basicallysource/sorter-v2/software/sorter-design-system/docs/overlays.md

# Overlays

What floats over the page: the popover, the menu, the select's list, the
tooltip and the modal. All of them are the raised plane: `bg-raised` with one
`border-line`, and no shadow. They render in the browser's top layer (the
`popover` attribute, or the native `<dialog>`), so no ancestor's overflow can
clip them and no z-index is needed. `place.ts` puts a floating panel next to
what opened it, on the preferred side, flipped when that side has no room,
and kept 8px inside the window.

## Popover

`Popover.svelte`. A little content that opens from a button: a picker, a
short form, an explanation too long for a tooltip. It closes on a click
outside, on Escape, and focus goes back to the button. The trigger snippet
gets the attributes that wire its button to the panel; spread them onto it:

```svelte
<Popover label="Camera exposure">
	{#snippet trigger(props)}<Button {...props}>Exposure</Button>{/snippet}
	...
</Popover>
```

## Menu

`Menu.svelte`. Actions or links from one button: the machine's menu, a
card's "more" menu, a switcher. The button that opens an actions menu shows
three dots (`ellipsis`) and a name, never the icon of one of the actions
inside it ([icons.md](icons.md#a-menus-button-is-three-dots)). The arrow keys, Home and End
move, Enter chooses, Escape and Tab close. An item that destroys something
comes last, after a separator, in danger ink, and its action asks first (a
`Modal`). A switcher's items take `checked`, and the current one gets a
check; a link that is `checked` is the current page (`aria-current`), which
is how the top bar's folded pages mark where you are. A group,
`{ group: 'Admin', items: [...] }`, puts its name over its items as a label,
like a group in the side nav:

```svelte
<Menu
	label="Account"
	items={[
		{ label: 'Your settings', href: '/account' },
		'separator',
		{ group: 'Admin', items: [{ label: 'Users', href: '/admin/users' }] },
		'separator',
		{ label: 'Sign out', onselect: signOut }
	]}>...</Menu
>
```

With no `trigger`, a Menu is a context menu: the thing that was right-clicked
opens it where the pointer is, with `openAt(event)` on the component (on a
Mac it waits for the button's release), and it closes like any other menu. Keep what it offers on the page as well (a
button beside the selection), since a touch screen has no right click:

```svelte
<Menu bind:this={menu} label="Bin" items={[{ label: 'Point the chute here', onselect: aim }]} />
<canvas
	oncontextmenu={(e) => {
		e.preventDefault();
		menu.openAt(e);
	}}
></canvas>
```

## Select

`Select.svelte` is a field that opens a list: our own, not the browser's, so
it looks like the rest of the page on every system. From the keyboard, Enter,
Space or the arrows open it; the arrows, Home and End move; typing jumps to
the first match; Enter chooses; Escape and Tab close. The list is at least as
wide as the field and scrolls past 18rem.

`class` goes on a wrapper around the field, so a width set there wins
(`class="w-44"`): no sized `<div>` around it. Any other attribute goes on its
button. In a form, `name` submits the value from a hidden native `<select>`,
which also takes `required` and `autocomplete`, so the browser checks it on
submit and can fill it.

## Tooltip

`Tooltip.svelte`. A short name for something with no room for one: a cut-off
value, a status dot, a mark on a chart. It shows after a short pause under
the pointer, at once on keyboard focus, and hides on Escape. An icon button
names itself (`Button`'s `label`) and needs no Tooltip. A tooltip never holds
what a setting needs to be understood: that goes under the setting, where it
is always visible.

The one exception is a dense list of settings, where a sentence under every
row would make the list as tall as a page. There a row's explanation sits
behind an `info` icon button right after its name (`SettingRow`'s `info`,
[components.md](components.md#settings)), and its Tooltip shows it on hover and
on keyboard focus. That text says what the setting is for. A warning, or what
a setting costs, is still written under the setting where it is always visible.

## Modal

`Modal.svelte`, the browser's own `<dialog>`: focus stays inside it, Escape
closes it, and the page sits under the scrim. A head with the title and a
close button, a body that scrolls, and a foot with the actions: the way out,
then the one thing to do. A click on the scrim does not close it, so a
half-filled form is never lost to a stray click; the close button and Escape
always do. For a decision that stops everything else, or a short form that
belongs to nothing on the page.

A confirmation says what will happen in a sentence ("The machine stops
sorting and comes back in standby in about half a minute"), and its button
says the action ("Restart"), in `danger` when it destroys or stops something.

While something runs that must not be interrupted (restarting the backend,
rebooting, powering down), the dialog cannot be closed: `dismissible={false}`
takes away the close button and makes Escape do nothing, and the app closes it
when the thing is done. It still holds focus, and the page stays under the
scrim. `status` says what is happening now, beside the Spinner at the start of
the foot ("Waiting for the machine to come back"), where the actions were.
The confirmation and the wait can be one dialog: the title changes, the
actions go, the status comes.

```svelte
<Modal
	open={restarting}
	title="Restarting the machine"
	size="sm"
	dismissible={false}
	status="Waiting for the machine to come back"
>
	<p>This page reconnects by itself when the machine is back.</p>
</Modal>
```

## Image zoom

`ImageZoom.svelte`. A picture that enlarges where it is pointed at: a thumbnail
in a list of pieces, one frame of a burst. The pointer on it, or keyboard focus
in it, shows the picture large beside it at once, and taking the pointer off
puts it away: nothing to click, nothing to close, so a row of photos is looked
over by moving along it. It is the raised plane in the top layer like the
others, and it never takes the pointer, so what is under it stays where it was.
The large picture is the thumbnail's own file, shown whole at its own shape
(never cropped, no bars), as large as the window allows up to about 28rem and
three times its own size, on the right of the thumbnail or on the left where
there is no room; `label` says what it is under it. A click on the thumbnail
still does what it did.

```svelte
<ImageZoom src={crop.src} label="Burst 3 of 9, 16:37:31">
	<img src={crop.src} alt="" class="size-20 object-contain" />
</ImageZoom>
```

## What there is not

- **No toasts.** A result shows where it happened: the button's own state, a
  sentence in the panel, or an `Alert` in the flow.
- **Nothing opens on hover but a tooltip and a picture's enlargement.** A
  touch screen has no hover, and a machine may have one; both only say more
  about what is already shown.
- **One overlay at a time.** A menu item that needs a dialog closes the menu
  first, and a dialog never opens another. A select inside a popover is the
  one exception, because its list belongs to the popover.
- **No shadows.** The line and the fill are enough.
