basicallysource/sorter-v2/docs/src/content/hardware/helpers/lazy-susan.md

---
layout: default
title: Preparing the Lazy Susan
type: how-to
section: hardware
slug: helper-lazy-susan
kicker: Helpers — Lazy Susan
lede: One-time prep for the lazy Susan bearing before it goes into an assembly.
permalink: /hardware/helpers/lazy-susan/
author: spencer
parts_needed:
  - part: brg-lazy-susan
    qty: 2
tools_needed: [Pliers]
---

**A machine takes two of these bearings and both get the same prep.** Some variants
ship with four rubber feet on one face. They hold the bearing off whatever it is
bolted to, so they come off first. If yours has no feet, there is nothing to do on
this page.

Do this before either bearing goes in: one at the [top interface]({{ '/hardware/assembly/distribution/top-interface/' | relative_url }}), one at the [bottom interface]({{ '/hardware/assembly/distribution/bin-frame/bottom-interface/' | relative_url }}).

<figure class="single-figure">
  8-inch lazy Susan bearing; the rubber foot to remove is boxed in red
  <figcaption>One of the four feet, boxed in red. <cite>Photo: Spencer.</cite></figcaption>
</figure>

## Remove the rubber feet

<ol class="numbered-steps">
  <li>Grip one foot with the pliers, close to where it meets the bearing housing.</li>
  <li>Pull straight up until it releases.</li>
  <li>Work around the housing until none are left.</li>
</ol>

<figure class="video-figure">
  <div class="video-embed video-embed-wide">
    <iframe
      src="https://www.youtube.com/embed/YQCLAKlc9-M"
      title="Removing the lazy Susan rubber feet"
      allow="encrypted-media; picture-in-picture; web-share"
      allowfullscreen
      loading="lazy"></iframe>
  </div>
  <figcaption>The same three steps on video. <cite>Video: Basically's own YouTube channel. Who filmed it isn't recorded.</cite></figcaption>
</figure>

## The finished result

A bearing that sits flat on a bench on both faces, with no feet on either.

<div class="img-placeholder">Image coming: the prepared bearing lying flat, the face the feet came off facing up, with the four feet beside it</div>

Sourcing, the load rating and the 8 inch variant are on the [Lazy Susan part page]({{ '/hardware/parts/lazy-susan/' | relative_url }}).
