basicallysource/sorter-v2/software/hive/agent-docs/labeling-queue.md

# The review queues, and why no request scans the fleet

The two review pages, Piece samples (`/piece-bboxes`) and Channel samples
(`/samples`, its sample pages and `/review`), read from tables that background
workers keep and from indexes walked in order, never from a join or count over
all of `machine_pieces`, `machine_piece_images` or `samples`. At a million pieces those took 11 to 48 s
per request and spilled hundreds of MB to temp files; every request now reads a
handful of rows. Keep it that way: **no HTTP request aggregates, sorts or counts
history.** If a page needs a number over the fleet, a worker computes it per
machine and the request sums the rows.

## What lives where

## One queue module, one machine filter

`services/review_queue.py` is "the filtered, sorted, keyset-paged queue of
things to review" for both pages: `piece_page` / `piece_cards` / `piece_count`
for pieces, `sample_page` / `sample_counts` for samples. What a sample filter
means lives in `services/sample_filters.py` (`SampleFilters`,
`apply_sample_filters`); the samples list, the review queue (`needs_review`),
the batch archive and delete, and a teacher re-run all go through it, so an
action never reaches a sample the page did not show.

**The machine filter is one machine or several** (`machine_id` repeated in a
query, `machine_ids` in a body, `machine=<id>,<id>` in the page URL) and is
applied by `restrict_to_machines` inside the one query every page of a list is
read from: every sort, every tier of a sort, every "load more". The tests
(`test_labeling_queue.py`, `test_review_queue.py`) walk every sort with one
machine and with several and fail on any other machine's row.

On the frontend, `lib/reviewQueue.svelte.ts` is the list both pages share: a
`ReviewQueue` per set of filters (`queueFor`), loaded a page at a time; the
grid (`ReviewGrid.svelte`), the Piece samples pane, the sample page and the
review page all step through it. A filter change makes a new queue and drops
the old one, so a response still on its way for the old filter can never land
in the new list (that is how one machine's pieces once showed up in another
machine's grid: a "load more" for the previous filter was appended after the
filter changed). `MachineFilter.svelte` is the machine picker on both pages.

| table | written by | read by |
|---|---|---|
| `labeling_queue` | `services/labeling_queue.py` (worker) | the piece grid (`GET /api/labeling/pieces`) |
| `labeling_queue.has_palette` | same worker, from `services/piece_palette.py` | the grid's palette badge and filter (`with_palette`) |
| `labeling_queue.has_training_label` | same worker, and the sync endpoints (`services/training_runs.py`) | the colour sorts, the cards' Training badge |
| `machine_training_runs.*_count` | the sync endpoints, per run they touch (`services/training_runs.py`) | the machine page's runs, the worker's per-machine sum |
| `labeling_queue_counts` | same worker, every pass | `GET /api/labeling/stats` (`total_labelable`, and `training_labeled_pieces` from `training_labeled`) |
| `labeling_queue_state` | same worker | the worker (its progress) |
| `piece_link_scores` | `services/piece_link_scores.py`, on the first open of a piece | `GET /api/labeling/possible-crops/...` |
| `piece_color_guesses` | `services/piece_color_guess.py`, on the first open | `GET /api/labeling/piece/...` |
| `machine_stats_cache.*_samples` | `services/machine_stats.py` (hourly) | `GET /api/stats/overview` (the dashboard) |
| `sample_diversity_weekly` | `services/sample_diversity.py`, in the same hourly pass | `GET /api/samples/diversity` |

## The samples list

`sample_page` walks one index newest first (`sample_path`): the one that leads
with the most selective filter the page has, a review state, then the machines
(a filter's, or the caller's own), the source, the capture reason, each with a
teacher-checked twin for the default view; archived samples have their own.
It looks at `SAMPLE_WINDOW` (2,000) samples of that index at most: it reads the
key of the last one from the index alone, then takes the page's rows from that
stretch. A filter that is rare in the stretch gives a short page, even an
empty one, with a `next_cursor` to go on from; the list ends when
`next_cursor` is null, and the frontend's queue keeps asking through short
pages (`reviewQueue.svelte.ts`). However rare the filters, no request reads
further back than the window.

## The queue

One narrow row per labelable piece: not dead, at least one crop in storage. The
grid also waits until a piece arrived 15 minutes ago (its upstream channel crops
upload after it), checked on `arrival_at` at read time. `arrival_at` is
`coalesce(seen_at, recorded_at, created_at)`: the grid's "newest" order, the
15-minute rule and the same-piece window all use it.

The worker (`labeling-queue-worker`, every 5 minutes):

- evaluates the pieces, and piece crops, that reached Hive since its last pass
  (by `created_at`, with a 10-minute overlap for transactions still open),
- marks queued pieces whose arrival window holds a newly synced channel crop as
  having same-piece candidates,
- recounts each machine's labelable pieces, and sums the pieces its training
  runs labelled (from the counts kept on each run),
- sets `has_training_label` for the pieces it evaluates (a training run's
  colour that counts, `piece-data.md`); the piece-records and training-runs
  sync endpoints set it for queued pieces whose training state, or whose run's
  exclusion, changes later,
- works out `has_palette` again for the queued pieces near the swatch runs
  stored since its last pass (see the palette, below),
- once a day re-evaluates every piece in batches of 5,000, which catches rows
  that changed after they arrived (a record re-sent as dead or re-classified,
  a palette frame whose sample was deleted); and so does the first pass after
  the swatch model the palette filter reads changes.

The first pass after a deploy is that full evaluation; it fills an empty queue
in a couple of minutes, and the grid shows what is done so far. A piece that
dies between evaluations never shows: the grid joins `machine_pieces` and
checks `dead` on the rows it serves.

It reads the crop tables through BRIN indexes on `created_at` (they only
append), and `machine_pieces` through `(machine_id, created_at)` one machine at
a time.

## The grid

`services/review_queue.py` (`piece_page`). Every sort is a few segments read in order until
the page is full: a **walk** of the queue in arrival order through an index
(for a sort about a label count, only pieces with no label of that kind, which
is nearly all of them), the **labeled** pieces ordered by how many labels (a
small set, written by people), and for "likely a rare color" a walk of its own
index. "Priority" is: candidates with no colour label, candidates with labels,
then the same without candidates.

**A training run's colour is a colour label.** The colour sorts (priority,
needs_me, least/most colour) leave the pieces with `has_training_label` out of
their walks and read them in a "trained" segment of their own: the pieces a run
labelled and no person has, newest first, through two partial indexes like the
palette's (`ix_labeling_queue_training_arrival`, `..._machine_arrival`). It
comes just before the labeled segment, as if they had one label; a piece people
labelled is in the labeled segment by their labels, whatever a run said.
`GET /api/labeling/stats` adds `training_labeled_pieces`, a sum of the
per-machine counts the worker keeps from the runs' own.

**By a colour model's confidence.** `least_sure` and `surest` (with
`color_model`, a model's sha256; the active model when none is named) walk that
model's stored answers (`piece_model_colors`, kept by the `color_model_run`
job, `jobs.md`) through `ix_piece_model_colors_confidence` (model,
confidence, machine, piece), or `..._machine_confidence` for one machine,
joining each answer to its queue row for the filters. Only the pieces the model
has answered are in these sorts. Any sort given `color_model` puts that model's
answer on its cards (`model_color`, a keyed read of the page's pieces); the
page shows it with a High / Medium / Low band (`frontend/src/lib/colorModels.ts`,
90% and 60%). The menu after "N shown" picks the model and the order.

**Agreeing in bulk.** With a model chosen, cards with its answer can be picked
(shift-click picks a stretch, "Pick all shown" the loaded ones), and
`POST /api/labeling/agree` (`model_sha256`, up to 500 pieces) writes the
user's own colour label for each as the colour that model answered for it: a
few keyed reads and one row each, skipping pieces the user may not see, the
model has not answered, or whose answer is not a labelable colour. The cards
are patched in place; correcting one piece stays the panel's job.

Paging is a keyset cursor (`next_cursor`, passed back as `cursor`): the segment
and the sort key of the last piece served. Page 50 costs what page 1 does, and
a label made while someone scrolls shifts nothing under them.

`with_palette` keeps the pieces with the colour reference palette in view near
them; it is `has_palette IS true`, the predicate of two partial indexes that
are the arrival walks over only those pieces, so the filter is an index walk in
every sort.

Thumbnails come as presigned storage URLs (`thumb_url`) when the storage
backend can sign them, so a page of 60 cards is not 60 more API requests. The
image routes remain for local storage and as the fallback.

## Per-piece results kept, not recomputed

Both results below are worked out ahead for the pieces a grid page shows (the
`piece_warm` job, `jobs.md`), so opening a piece reads rows. The page also
fetches the next three pieces after the open one, and a card the pointer
rests on, with their pictures (`frontend/src/lib/pieceCache.ts`); the pane
shows that at once and refreshes it in the background. Images in the object
store are written with `Cache-Control: private, max-age=86400, immutable`, and
their signed URLs are kept for half the signature's life, so the browser keeps
them.

- **Link scores** are kept per `(machine, piece, link model sha256)`. The first
  open reads the anchor and candidate crops concurrently, with no transaction
  open, and scores them; later opens read the row. Crops that synced since are
  scored and merged in. The pick threshold is the published model's
  `predict_threshold` (the `detection_models` row of the same slug), else
  `hive.predict_threshold` in the ONNX metadata, else 0.5; the response carries
  it as `link_threshold` and the panel shows it.
- **Colour guesses** (pixel average and colour model) are made from one
  concurrent read of the piece's crops and kept per `(machine, piece, colour
  model sha256)`, remade when the piece's usable crops change.

## The palette near a piece

Some machines carry a colour reference palette at the edge of the
classification camera's view (`jobs.md`, `swatch_find`). A piece has it in view
when a classification frame of its machine within two hours of its arrival
(`piece_palette.WINDOW`; a sorting machine takes one at least hourly) was called
palette-in-view by the swatch model the samples filter reads (the active one,
else the one changed last). Each swatch run carries its sample's machine and
frame time (`machine_id`, `frame_at`: captured, else uploaded), and
`ix_sample_swatch_runs_palette_frames` (model, machine, frame time; palette
calls only) makes "this machine's palette frames near this time" one range:

- the worker reads the frame times near a stretch of a machine's pieces in one
  query (pieces grouped into runs, the runs' ranges OR'd, as for candidates)
  and sets `has_palette`; a run stored since its last pass makes it work out
  the pieces within two hours of that frame again; a run stored without a
  machine and time (by a release that did not set them) is given them first;
- the piece panel (`GET /api/labeling/piece/...`, `palette`) shows the latest
  palette frame at or before the piece within the window, else the first one
  after it, and that run's swatches: two LIMIT 1 probes on the same index.

## Postgres

Prod's postgres settings are in `docker-compose.prod.yml` (`command:`), sized
for the 4 GB box. A release never recreates the postgres container, so a change
there only takes effect after `docker compose ... up -d postgres` on the box
(see `scripts/README.md`). Handlers and workers that still aggregate call
`app.database.tune_for_aggregates` (per-transaction `work_mem`, JIT off).
