basicallysource/sorter-v2/docs/src/content/index.md

---
layout: default
title: What Sorter is
type: landing
slug: home
kicker: Sorter
lede: An open-source LEGO sorting machine: what it sorts, what it will not, and where to start if you want to build one.
---

<figure class="landing-hero-float">
  <div class="landing-hero-media">
    Sorter assembled: a hexagonal tower of open bins under the platter, distributor and camera head.
  </div>
  <figcaption><cite>Rendered from the part geometry, not from a build.</cite></figcaption>
</figure>

You feed bulk LEGO into a hopper. The machine separates the pieces one at a time, works out what each one is by part number (and by color, if you want), and drops it into the right bin.

Machines are built and running, and they sort every day. It is not a product yet: there is no kit and no price yet. What exists is the design, the parts list, and these instructions. For the latest, see the [Basically website](https://basically.website/).

**What it sorts:** loose, rigid LEGO pieces up to ten studs in any direction. That is most of a mixed tub, not all of it, and the rest you pick out by hand before a run:

- **Anything over ten studs.** Baseplates, long plates and beams, boat hulls, large wheels and tank tracks.
- **Tyres and anything rubber.** Rubber grips where plastic slides, so a tyre stalls in a channel instead of dropping out of it.
- **Cloth, string and chain.** These tangle, with each other and with ordinary parts.
- **Minifigures and their small accessories.**
- **Duplo, Primo and other brands.**

[Preparing LEGO]({{ '/sorter/preparing-lego/' | relative_url }}) is the full list, with what each thing does to the machine if it stays in.

**How much it sorts at once is your choice.** The machine is a stack of layers, each holding 18 bins or 12 larger ones, so more layers means more categories in one pass and more to build. [Getting started]({{ '/getting-started/' | relative_url }}) has what a machine costs and what you need to build one.

## Start here

<div class="callout-grid callout-grid-paired">
  <a class="callout callout-lead" href="{{ '/getting-started/' | relative_url }}">
    <strong>Getting started</strong>
    <p>Want to build a machine? Read this first: what it costs, the skills and tools you need, and the order to read the rest in. It also covers working on the project.</p>
    <span class="callout-lead-cta">Start here</span>
  </a>
  <div class="callout">
    <strong><a href="{{ '/hardware/' | relative_url }}">Hardware</a></strong>
    <p>The detail behind the build: machine sizes, parts counts and printing time, everything to buy and print, and the step-by-step assembly.</p>
  </div>
  <div class="callout">
    <strong><a href="{{ '/sorter/' | relative_url }}">SorterOS</a></strong>
    <p>The software on the machine. Install it, set it up, calibrate the cameras and the chute, and run a sort.</p>
  </div>
  <div class="callout">
    <strong><a href="{{ '/hive/' | relative_url }}">Hive</a></strong>
    <p>The community space in the cloud: sorting profiles shared by other builders, the samples behind them, and the community review that checks those samples.</p>
  </div>
  <div class="callout">
    <strong><a href="{{ '/lab/' | relative_url }}">Design and research</a></strong>
    <p>How the machine is designed, what is connected to what, tested variants, and the research behind it.</p>
  </div>
</div>
