basicallysource/sorter-v2/docs/src/content/sorter/preparing-lego.md

---
layout: default
title: Preparing LEGO for a sort run
type: how-to
section: sorter
slug: sorter-preparing-lego
kicker: SorterOS — Operate
author: brickcyclealice
lede: What to take out of a tub of bulk LEGO before it goes in the bulk bucket, and what each thing does to the machine if it stays in.
permalink: /sorter/preparing-lego/
last_verified: 2026-09-20
og_image: https://assets.basically.website/sorter-docs/lego-intake-prep-sheet-full-7444bbbb1daa.png
warning: >-
  **A working house standard, not a published specification.** Basically has not
  published a list of parts the machine will and will not take. This page is
  written from failures builders have reported and from what the software does
  with a part, so treat it as a starting point and adjust it to what your own
  machine stops on.
---

The machine does not check a piece before it feeds it. Nothing in the feeder sets oversized or awkward parts aside, so whatever goes in the bulk bucket is what the machine tries to sort. A tub is prepared by hand first.

This is worth a few minutes per tub. One stuck piece stops every piece behind it.

## The size limit

**The machine handles a piece up to 80 mm in any direction.**

A LEGO stud is 8 mm across, so 80 mm is ten studs. Count studs instead of measuring:

- A 2x10 brick fits.
- A 2x12 brick does not.
- A Technic beam with ten holes fits. A longer one does not.
- A 10L axle fits. A longer one does not.

A piece over the limit does not fall through a channel cleanly. It bridges the channel, or it wedges on the way into the chute, and everything behind it stops.

**Ten studs is the feed side, and the layer a piece is sorted to is tighter.** A half-size layer takes 8 studs, a third-size layer 6, so on a machine whose layers are all third size six studs is the working limit for the tub. [Which bin a box lands in]({{ '/hive/first-profile/send-it-to-your-machine/' | relative_url }}#bins-are-chosen-on-the-machine-not-in-the-profile) has the detail and what it means for your sorting profile.

The [one-page sheet](#the-one-page-sheet) at the bottom of this page carries a life-size 2x10 brick, so a doubtful piece can be laid straight on top of it instead of counted.

## What to take out

### <svg viewBox="0 0 100 100" width="30" height="30" aria-hidden="true" style="display:inline-block;vertical-align:-7px;margin-right:10px"><g fill="#fff" stroke="currentColor" stroke-width="5" stroke-linejoin="round" stroke-linecap="round"><rect x="8" y="30" width="15" height="11"/><rect x="43" y="30" width="15" height="11"/><rect x="78" y="30" width="14" height="11"/><rect x="5" y="41" width="90" height="25" rx="2"/><path d="M5 84 H95" fill="none"/><path d="M17 76 L5 84 L17 92" fill="none"/><path d="M83 76 L95 84 L83 92" fill="none"/></g></svg>Pieces over ten studs

Baseplates of every size. Long plates, bricks and tiles. Boat hulls, wings, masts, aerials, long poles and ladders. Long Technic beams, liftarms, axles and flexible tubing. Large windscreens and canopies. Large wheels and tank tracks.

### <svg viewBox="0 0 100 100" width="30" height="30" aria-hidden="true" style="display:inline-block;vertical-align:-7px;margin-right:10px"><g fill="#fff" stroke="currentColor" stroke-width="5" stroke-linejoin="round" stroke-linecap="round"><circle cx="50" cy="50" r="40"/><circle cx="50" cy="50" r="17"/><path d="M50 10 V22 M50 78 V90 M10 50 H22 M78 50 H90 M22 22 L30 30 M78 78 L70 70 M78 22 L70 30 M22 78 L30 70" fill="none"/></g></svg>Tyres, wheels and rubber

Every tyre, loose or still on its rim. Rubber tank treads, rubber bands, hoses, flexible tubing, suction cups and rubber axle connectors.

Rubber grips where plastic slides. A tyre carried around a channel is pushed by the turning rotor against the fixed outer wall, and instead of sliding on it stalls there. It does not drop out of the channel on its own. This is the most frequently reported way a machine stops.

Take the whole wheel out. If you pull the tyre off the rim, the bare rim is an ordinary part and can go back in.

### <svg viewBox="0 0 100 100" width="30" height="30" aria-hidden="true" style="display:inline-block;vertical-align:-7px;margin-right:10px"><g fill="none" stroke="currentColor" stroke-width="6" stroke-linecap="round" stroke-linejoin="round"><path d="M6 40 C6 18 30 8 44 18 C56 26 50 44 36 40 C22 36 28 16 48 14 C64 13 72 22 72 32"/></g><g fill="#fff" stroke="currentColor" stroke-width="6" stroke-linejoin="round"><rect x="7.0" y="75.0" width="30" height="18" rx="9.0" transform="rotate(-17.5 22 84)"/><rect x="28.0" y="68.4" width="30" height="18" rx="9.0" transform="rotate(-17.5 43 77.4)"/><rect x="49.0" y="61.8" width="30" height="18" rx="9.0" transform="rotate(-17.5 64 70.8)"/></g></svg>Cloth, string and chain

Capes, sails, flags, curtains, sleeping bags and parachutes. String and rope. Chain. Paper and card.

These tangle, with each other and with ordinary parts. The cameras read a tangle as a single object, and nothing in the machine pulls one apart.

### <svg viewBox="0 0 100 100" width="30" height="30" aria-hidden="true" style="display:inline-block;vertical-align:-7px;margin-right:10px"><g fill="#fff" stroke="currentColor" stroke-width="5" stroke-linejoin="round"><rect x="34" y="22" width="16" height="10"/><rect x="62" y="22" width="16" height="10"/><rect x="30" y="32" width="58" height="24" rx="2"/><rect x="16" y="46" width="14" height="10"/><rect x="12" y="56" width="58" height="24" rx="2"/></g></svg>Pieces still joined together

Part-built models. Stacked plates. Bricks pressed together. Pins pushed into beams. A wheel on a hub.

Every piece has to arrive on its own. Two pieces joined together are photographed as one object, and no such object exists in the catalog, so the machine cannot name it. Pull them apart before they go in the tub.

### <svg viewBox="0 0 100 100" width="30" height="30" aria-hidden="true" style="display:inline-block;vertical-align:-7px;margin-right:10px"><g fill="#fff" stroke="currentColor" stroke-width="5" stroke-linejoin="round" stroke-linecap="round"><circle cx="50" cy="20" r="14"/><rect x="44" y="34" width="12" height="6"/><path d="M34 40 H66 L72 70 H28 Z"/><path d="M34 44 L18 60 M66 44 L82 60" fill="none"/><rect x="30" y="70" width="16" height="22"/><rect x="54" y="70" width="16" height="22"/></g></svg>Minifigures

Whole figures, capes, whips, and accessories smaller than a fingernail.

Two separate reasons. The soft accessories behave like the cloth and string above. Whole figures are a different matter: the classifier does recognise an assembled figure, but no one has reported running figures through a machine, so how one travels through the channels is unknown. Figures are also usually the most valuable thing in a tub, which is its own reason to set them aside for a person.

Loose minifigure heads, torsos, legs, hats and hair are ordinary rigid parts. Leave those in.

### <svg viewBox="0 0 100 100" width="30" height="30" aria-hidden="true" style="display:inline-block;vertical-align:-7px;margin-right:10px"><g fill="#fff" stroke="currentColor" stroke-width="5" stroke-linejoin="round"><rect x="24" y="34" width="20" height="12"/><rect x="56" y="34" width="20" height="12"/><rect x="20" y="46" width="60" height="28" rx="2"/></g><g fill="none" stroke="#C8102E" stroke-width="7" stroke-linecap="round"><circle cx="50" cy="52" r="42"/><path d="M21 23 L79 81"/></g></svg>Rubbish, or Primo, Duplo and other brands

Anything that is not LEGO at all: paper, stickers, packaging, coins, screws, batteries and dirt. Duplo and Primo. Other brick brands.

Duplo and Primo are a firm exclusion rather than a preference. The software throws away any identification in those two categories, so a Duplo brick can never be named, whatever the camera sees. It occupies the machine for its full classification timeout and then goes to the misc bin.

### <svg viewBox="0 0 100 100" width="30" height="30" aria-hidden="true" style="display:inline-block;vertical-align:-7px;margin-right:10px"><g fill="#fff" stroke="currentColor" stroke-width="5" stroke-linejoin="round" stroke-linecap="round"><path d="M72 6 C72 6 92 30 92 43 A20 20 0 0 1 52 43 C52 30 72 6 72 6 Z"/><rect x="10" y="52" width="18" height="11"/><rect x="40" y="52" width="18" height="11"/><rect x="6" y="63" width="62" height="29" rx="2"/><path d="M30 63 L38 74 L26 80 L34 92" fill="none"/></g></svg>Dirty, damaged or damp pieces

Chewed, cracked, glued, painted, mouldy or badly faded pieces. Anything damp.

A piece is identified from a photograph of it, so dirt and damage change what the machine sees and it files the piece wrongly. Damp pieces stick to each other and to the rotor. The tub goes in dry.

## What to leave in

These are all in scope, and picking them out wastes time:

- **Small parts**, down to 1x1 plates and tiny tiles.
- **Printed and decorated parts.** The classifier covers printed parts.
- **Transparent, glow, chrome, metallic and rare colours.**
- **Loose minifigure heads, torsos, legs, hats and hair.**

Some small flat pieces are still hard to name, because the classification channel photographs a piece from above only and a small tile's identifying detail is often underneath. Those pieces go to the misc bin. That costs one slot in a bin, not a stoppage, and it is not a reason to pre-sort them out.

## Where the pulled pieces go

Use one tray for everything that comes out, and have someone go through it afterwards rather than deciding at the tub. Anything a person is unsure about goes in the same tray. A wrong guess into the tub can stop the machine; a wrong guess into the tray costs nothing.

## The one-page sheet

<figure class="single-figure">
  One-page intake standard headed LEGO tub prep, in three numbered zones: a size check with a life-size 2x10 brick drawn under an 80 mm dimension, a red take-out block of eight illustrated tiles, and a green leave-in strip
  <figcaption>The same rules as a single sheet for the bench or the wall. <a href="https://assets.basically.website/sorter-docs/lego-intake-prep-sheet-full-7444bbbb1daa.png">Open it full size</a> and print it at A4, at 100% scale rather than fit-to-page. The brick on it is drawn life size, so a doubtful piece can be laid straight on top of it; the bar under the brick measures 80 mm on a correct print, which is how you check the printer did not scale the page. <cite>Drawn from the rules on this page. Drawing: balloon.</cite></figcaption>
</figure>

## Box labels

Everything pulled out has to go somewhere, and a box with a label on it is faster to aim at than a list on a wall. This second sheet is the same seven icons plus the ask-someone one, sized to cut out and stick on a box or a tray.

<figure class="single-figure">
  An A4 sheet of eight box labels, two columns by four rows, each with a dashed cut line, a red header carrying the category number, a large icon, the category name in capitals and one line of examples; the last label is yellow and reads Not sure
  <figcaption>Eight labels on one A4 sheet. <a href="https://assets.basically.website/sorter-docs/lego-intake-box-labels-full-46addd21f573.png">Open it full size</a> and print it at A4, 100% scale. Each label cuts out at about 96 by 63 mm. The numbers are the same as the wall sheet, so a piece that matches tile 3 goes in box 3. <cite>Drawn from the rules on this page. Drawing: balloon.</cite></figcaption>
</figure>

Anything not named on one of those boxes stays in the tub and goes to the machine.

## Next

[Before your first sort run]({{ '/sorter/before-first-sort-run/' | relative_url }}) covers the machine side, and [Your first sort run]({{ '/sorter/tutorials/first-sort-run/' | relative_url }}) walks a prepared tub through it.
