basicallysource/sorter-v2/parts-calculator/VERSIONING.md

# Versioning: how parts are identified, revised, and retired

The short version of how this catalog handles change. When someone asks "can
we delete this part?" or "how do I revise this?", this page is the answer to
point at. The authored source of truth is `catalog/parts.json`; the mechanics
live in `catalog/generate.py` and are enforced by CI.

## Identity: the uid

Every part, hardware item, assembly, version, and candidate gets a **uid** when
it is added (`catalog/mint_uid.py`). A uid names one design revision. It is the
string engraved into printed plastic, and the site serves a permanent page at
`/u/<uid>` for every uid ever minted.

**A uid is a permanent promise.** Once minted, it must keep resolving forever —
someone may hold a print with it stamped on, or a link to its page. CI
(`scripts/check_generated_pins.py`) fails any change that drops a uid from
`parts.json`. There is no override; entries are never deleted.

## Revising a part

A revision is an **addition**, never an edit-in-place:

1. New geometry is exported and published; its bytes get a new content hash and
   therefore a new URL. Old URLs keep serving forever (the asset service has no
   delete or overwrite operation — see the "Artifacts and the asset service"
   section of `AGENTS.md`).
2. The new revision gets a new uid. `stamp_versions.py` archives the outgoing
   design into the part's `versions[]` with its uid and `stl_hash` (the sha256
   of its final bytes). Historical geometry is fetched by that pin — never
   reconstructed from git history.
3. The new `versions[]` entry declares its **`breaking` bit** (next section).
4. Regenerate (`catalog/generate.py`) and commit source and generated data
   together in the same change.

A **candidate** is a revision under test for a part's slot: its own uid and
`stl_hash`, no version number until adopted. Candidates are never deleted,
only marked `superseded_by` / `rejected_at`.

## The `breaking` bit

From 2026-08-31, every new `versions[]` entry — part or assembly — declares
`breaking: true | false`. It answers exactly one question about exactly one
node:

> **Can an old physical instance of THIS node still be used in its place?**

For a part an instance is a print; for an assembly it is an assembled unit.
`false`: old instances stay interchangeable with the new revision. `true`:
old instances don't fit or function in the current design — scrap for
current builds (still valid for building the archived old structure they
came from).

The rules that keep the bit meaningful:

- **Each node speaks only for itself.** An assembly can be reworked inside —
  parts merged, members swapped — and still be `breaking: false` if it mates
  outward the same way; whoever holds the old assembled unit keeps using it.
- **Bits are set bottom-up at authoring time, on the nodes the change
  touched.** A change is recorded on the node that owns what changed:
  geometry → the part; membership or quantities → the assembly that owns
  the lines. Then ask the same question one level up, and stop as soon as
  the answer is false. There is never a search for "what broke" after the
  fact — the causal chain and the edit are the same thing.
- **First versions and new identities carry no bit.** Nothing older exists
  to break. A replacement design is a *new* part or assembly (new uid, v1),
  not a revision of the thing it replaces — the replaced one is retired from
  the lines that used it, unrevised.
- **Unused ≠ breaking.** A part whose slot disappeared is retired (see
  below); its geometry didn't stop fitting anything. Never use `breaking`
  to express removal.
- **Candidates carry no bit.** A candidate is a parallel experiment, not a
  revision; the judgment happens on the version minted if it is adopted.

Why: whether any old print fits today's machine becomes *computable* from
the chain of bits — never reconstructed from memory or CAD archaeology.
`scripts/check_versioning.py` (CI) refuses a new revision without its bit.

## Revising an assembly

Any change to an assembly's `lines` — a member added, removed or replaced,
a quantity changed — is a revision and must be **stamped** in the same
change:

1. Bump the assembly's `version`.
2. Append a `versions[]` entry: new version number, `date`, `message`, its
   `breaking` bit, `"commit": null` (pending).
3. After committing, run `catalog/stamp_versions.py`: it ties the entry to
   its commit and snapshots the superseded lines with each member's uid of
   the day, so the box as built then reads back part by part. On a node's
   first stamp it also writes the entry for the state being left behind, so
   there is always a snapshot to flip back to.

There is no "just filling in what was always there" exemption: the lines
are the record, and every change to them is a moment someone may need to
flip back to. CI enforces this (`scripts/check_versioning.py`).

**Flipping to a version shows the site as it was, straight out of git.**
The site of any stamped moment already exists, verbatim: the generated
catalog committed alongside the change. Nothing about old versions is
copied into today's data. At build time (`npm run build`, and dev),
`scripts/version-snapshots.mjs` subsets that data per superseded version —
the era's own records for every assembly, part and hardware item under the
node — into `static/versions/<assembly>-v<version>.json` (gitignored,
derived). Flipping "Viewing vN" fetches that file and renders only from
it: the era's names, descriptions, photos, renders, weights, joints, and
the era's plain and uid-engraved STL downloads, all at permanent
content-addressed URLs published when that version was current. A
version's moment is the last commit of its reign (the parent of the commit
that superseded it); an entry may pin a different moment with
`snapshot_at` — the feeder's v4, stamped purely to lock the machine before
the C-channel overhaul, points at its own commit. Structurally, a flipped
view cannot show anything from today: it never reads today's catalog.

## History is derived, not recorded

A node's change log — everything that ever happened at or below it — is
computed, git-log style, as the union of the `versions[]` entries in its
subtree. The assembly page's History panel renders it at any level, from one
bracket up to the whole machine. Version entries are therefore the only
history anyone writes; there is no separate log to maintain.

Every row of that timeline is a moment the whole tree can be resolved at:
each assembly's lines are read from its recorded states, so the page can
render the tree as it was then, diff a moment against the one before it (the
change itself), or diff it against the current tree. This works because
stamps snapshot lines: keep stamping and time travel keeps working for free.

Changes older than the stamp rule (2026-08-31) were reconstructed once from
the git history of `parts.json` into `src/lib/data/changelog.generated.json`
(`scripts/backfill_changelog.py`), along with the per-assembly line
timelines that resolve moments inside that era. The file is frozen: it
covers a closed era, is never regenerated, and is never hand-edited.
Moments after its horizon resolve from `versions[]` snapshots.

## Tags

A tag blesses a moment of a node's whole subtree: top-level `tags` in
`parts.json`, each `{name, node, stability, date, commit, message?}`.
`stable` means the build as of that moment is known good; `golden` adds the
forward promise — future revisions of a golden-tagged node must not be
breaking, so anything built against it keeps working; `experimental` marks
a coherent but unproven cut. A tag resolves against history exactly like a
timeline point and renders highlighted on the timeline.

A tag resolves exactly like a version flip — the whole subtree as of the
end of its date — but adds a stability claim about that build. Locking a
subtree needs no tag: stamp a version (previous section).

Tags are appended only by a human decision. No tool, check, or agent ever
mints one.

## Retiring a part

A part, hardware item or assembly the machine stops using is **retired**,
never deleted. It becomes invisible to the current version and stays whole
for the older ones that used it:

1. **Take it out of every current line** that names it, stamping each
   assembly you change (above). The superseded versions keep their line
   snapshots, which name it by uid, so the builds they describe stay intact.
2. **Set `retired_at`** on the entry to the date it left the machine, and
   drop any `quantities` or `sheet_qty` it still carries. In its
   `description`/`note`, say why it went and what replaced it, plus a
   "do not re-add" warning if old docs or photos still show it.
3. **Update the docs pages** that had steps using it.
4. **Regenerate and commit** source + generated together.
5. **Leave the assets alone.** STLs, renders, and stamped downloads stay at
   their hash URLs by design; they cost nothing and old links keep working.

What `retired_at` does: every view of the current machine (the parts and
hardware lists, the totals and buy list, search, the all-parts bundle, the
assembly tree) leaves the entry out. Its own page, `/u/<uid>`, the History
panel and the flipped views of the versions that used it still resolve it,
and its page says it is retired. `scripts/check_versioning.py` (CI) refuses a
retired entry that a live line, param or `requires` still names, or that
still carries quantities.

**Retiring is the end of an entry's life here.** Nothing is left to delete,
so there is no deletion to track, request or approve: no "to be removed"
notice, no delete issue, no override of the check that keeps entries. If a
later design needs the same part again, clear `retired_at`; if it is a new
design, it is a new part with its own uid.

Worked example: the light post, the overhead camera mount and the camera
extension, retired 2026-09-02 when the Camera lamp replaced them. None of
them is in today's lists, and the feeder's v0.1 and v0.2 still show them.

## What never happens

- Deleting an entry from `parts.json`, or asking for one to be deleted
  (CI refuses the deletion; retiring, above, is the whole job).
- Reusing a uid, or minting a new uid for unchanged geometry (a re-export of
  the same design is a new hash under the same uid).
- Deleting or overwriting an asset (the service cannot).
- Hand-editing `src/lib/data/catalog.generated.json` (it is an output).
- A new revision without its `breaking` bit, or a change to an assembly's
  lines without a version stamp (CI refuses both, from 2026-08-31;
  `scripts/check_versioning.py`).
- Compatibility claims between arbitrary version pairs. Compatibility is
  computed from the chain of `breaking` bits; anything the chain can't
  derive is honestly unknown.
