basicallysource/sorter-v2/docs/src/content/hardware/software-setup.md

---
layout: default
title: Software setup
type: how-to
section: hardware
slug: hardware-software-setup
kicker: Hardware — Software setup
lede: The physical build is finished. Install the software, then carry on in the SorterOS section.
permalink: /hardware/software-setup/
og_image: https://assets.basically.website/sorter-docs/sorteros-first-load-sorter-ui-full-c7e8aae4ac07.png
author: spencer
---

The machine is built. Everything is printed, bolted, wired and plugged in, and nothing more is added to it by hand. What is left is software, and all of it lives in the [SorterOS]({{ '/sorter/' | relative_url }}) section.

## 1. Install SorterOS on the Pi

[Installation]({{ '/sorter/installation/' | relative_url }}) has three routes: the **SorterOS image**, pre-built and the recommended one for the Orange Pi 5; the **one-command installer** for generic Linux; and the **by-hand** sequence for anything else. Each ends the same way, with the SorterOS UI open in a browser and the first-boot setup wizard waiting.

## 2. Carry on in SorterOS

Flashing the control board, the setup wizard, the calibrations and your first sort run are all in the [SorterOS]({{ '/sorter/' | relative_url }}) section, which lists them in order.

## The finished result

The SorterOS UI open in a browser on the machine's own address, and the setup wizard waiting. Everything from here happens in this window.

<div class="img-row">
  <figure>
    The SorterOS UI's dashboard the first time it loads: the Dashboard, Bins, Profiles, Records and Settings tabs along the top, a feeder panel reading No Camera Assigned, the machine in System Standby with a Home button, no pieces yet, and the runtime stats all at zero.
    <figcaption>The SorterOS UI, before the wizard has been through it. <cite>Screenshot recorded in a browser.</cite></figcaption>
  </figure>
</div>
