basicallysource/sorter-v2/docs/src/content/lab/operation-target-10ppm-2026-04-25.md

---
title: Operation Target 10 PPM
type: working-note
audience: contributors tuning the live SorterOS runtime
applies_to: sorter-v2
owner: lab
last_verified: 2026-04-26
section: lab
slug: operation-target-10ppm-2026-04-25
kicker: Design and research — Runtime Target
lede: A concrete operating target for the current live tuning phase, ten cleanly classified and distributed LEGO pieces per minute without relying on harsh C4 acceleration.
permalink: /lab/operation-target-10ppm-2026-04-25/
---

## Target

Reach a sustained operating point where the sorter cleanly classifies and distributes **10 pieces per minute** from C4 into the distributor.

Interim target: **8 solid pieces per minute** is a valid near-term operating point if it preserves the single-piece/bin-correctness invariant and does not rely on harsh C4 acceleration.

The target is about stable end-to-end flow, not peak burst speed. A run only counts when pieces are:

1. tracked through the C-channel and C4 runtime path without identity churn causing operational confusion;
2. classified with a usable result;
3. handed from C4 into the distributor;
4. physically delivered without C4 overfill, repeated jams, or obvious pile-up behavior;
5. ejected one-at-a-time into the bin selected for that exact classification result.

## Success definition

| Metric | Target |
| --- | --- |
| End-to-end throughput | >= 10 distributed pieces/min over a measured run |
| Confirmation window | First prove it on short 30-60 s runs, then on 3-5 min runs |
| C3 density | roughly 8-10 visible pieces, not clumped at one exit/intake area |
| C4 density | roughly 8-10 visible pieces, evenly spread enough for tracking and classifier capture |
| Classification | no large backlog of registered-but-unclassified pieces |
| Distributor | no sustained distributor_busy bottleneck or repeated failed handoffs |
| Bin correctness | exactly one C4 piece is released per distributor-ready/commit cycle, into the bin selected for that piece |
| Mechanical smoothness | C4 motion remains audibly and visibly smooth |

## Non-goals

- Do not chase 10 PPM by making C4 acceleration harsh.
- Do not accept high C4 pile-up just because throughput briefly rises.
- Do not tune from UI impressions alone; every change needs a measured before/after.
- Do not reintroduce old tracker stacks for production runtime. BoxMot plus the stable piece layer remains the intended path.
- Do not count a run as successful if C4 ejects trailing pieces into a bin that was positioned for a different classification.

## Preferred tuning levers

Tune in this order:

1. **Backpressure and density**
   - C1 feed cooldown and jam threshold
   - C2 max piece count
   - C3 max piece count
   - C2->C3 and C3->C4 exit handoff spacing
   - C3->C4 virtual slot allowance
   - C4 max zones

2. **Pulse timing**
   - C2 pulse cooldown
   - C3 pulse cooldown
   - C4 transport cooldown

3. **Gentle transport speed**
   - C4 target rpm
   - C4 transport speed scale
   - C4 transport step and max step

4. **Only last: acceleration**
   - Keep C4 transport acceleration conservative by default.
   - Raising acceleration is allowed only for a measured reason and should be rolled back if the motion sounds or looks aggressive.

## Current C4 motion baseline

As of 2026-04-25, the intended C4 baseline is:

| Field | Value |
| --- | --- |
| transport_step_deg | 3.0 |
| transport_max_step_deg | 8.0 |
| transport_cooldown_s | 0.18 |
| transport_target_rpm | 0.7 |
| transport_speed_scale | 4.0 |
| transport_acceleration_usteps_per_s2 | 4000 |
| startup_purge_speed_scale | 4.0 |
| startup_purge_acceleration_usteps_per_s2 | 20000 |
| stepper_degrees_per_tray_degree | 12.0 live-calibrated on 2026-04-27 five-wall C4 platter |

## Current measured candidate

As of the 2026-04-26 early-afternoon pass, the most useful live profile is a cautious C1/C4 flow profile, not the older aggressive C4 density profile:

| Area | Candidate |
| --- | --- |
| C1 | `steps_per_pulse=50`, `microsteps_per_second=1800`, `delay_between_pulse_ms=1500`, `pulse_cooldown_s=2.0`, `startup_hold_s=3.0`, `unconfirmed_pulse_limit=3`, `observation_hold_s=3.0`, `jam_timeout_s=30`, `jam_min_pulses=20` |
| C1/C2 vision gate | `target_low=1`, `target_high=3`, `clump_block_threshold=0.65`, `exit_queue_limit=1` |
| C1/C4 backlog gate | `raw_high=7`, `dossier_high=3` |
| C3 | `max_piece_count=8`, `exit_near_arc_deg=25`, `approach_near_arc_deg=55`, `pulse_cooldown_ms=120` |
| C3->C4 | `slot_capacity=5` |
| C4 density | `max_zones=5`, no `max_raw_detections` cap in the current best profile |
| C4 transport | `transport_step_deg=4.0`, `transport_max_step_deg=10`, `transport_cooldown_ms=140`, `target_rpm=0.9`, conservative acceleration |
| C4 classification / handoff | `classify_pretrigger_exit_lead_deg=160`, `handoff_request_horizon_deg=90` |
| C4 exit approach | `exit_approach_angle_deg=24`, `exit_approach_step_deg=4.0` |
| C4 release | `exit_release_shimmy_amplitude_deg=1.5`, `exit_release_shimmy_cycles=2` |
| Distributor | `simulate_chute=true`, `simulated_chute_move_s=3.5`, `chute_settle_s=0.4`, `fall_time_s=1.5` |

The counterexample matters: `max_zones=10`, tighter `half=6` / `guard=5`, and a wider C3 slot allowance drove C4 raw detections as high as 15 and reduced useful throughput. Overfilling C4 made tracking and classification less stable instead of faster.

The 2026-04-26 counterexamples also matter: capping C4 too hard (`max_zones=3`, `max_raw_detections=5`) reduced distributed throughput, and a faster C4 approach profile (`exit_approach_step_deg=5`, `target_rpm=1.1`) performed worse. A shorter simulated distributor cycle of about 3.7 s did not improve the score either. The current bottleneck is sustained C4 dispatch/backlog balance, not raw distributor wait time and not C4 acceleration.

## Current state, 2026-04-26

The 8 PPM target is not yet proven. The best late-night end-to-end signal from a freshly refilled hopper was `bedtime-fresh-hopper-current-profile-180s`: `+10` distributed during the requested 180 s window, but it ended with C2 overfilled and C4 backlog, so it does not count as "solid".

The follow-up isolated downstream drain, `local-downstream-drain-after-fresh-hopper-c1-held-120s`, distributed `+5` with C1 effectively held. That run proved the current blocker was not the simulated distributor: C4 and distributor drained, while C2 stayed blocked behind C3.

The stationary round/yellow C3 landing-area part was manually removed, and Runtime C3 now has localized bad-actor suppression paths for this failure mode. In `after-round-badactor-removal-and-c3-ignore-120s`, the landing-arc suppression triggered live (`ignored_count=1`) and prevented one stationary track from blocking the C2->C3 lease forever. A follow-up C1 dose loop then exposed a second variant: one C3 track at about `-28 deg` stayed visible after purge, sample transport, and a direct C3 move. Runtime C3 now also quarantines broad C3 transport bad actors after real C3 movement attempts if the track remains angularly stationary, and releases the quarantine again after clear angular motion.

That run still delivered `0.0 PPM`: several active C3 pieces clustered near the upper/landing side and did not move meaningfully toward C4 despite repeated C3 pulses. Treat this as the current local blocker before another full throughput attempt.

Update from the 2026-04-26 late-morning pass:

- C4 no longer advances a classified handoff piece while the simulated distributor is still positioning. The first live verification distributed one controlled piece cleanly.
- C4 now uses gentle approach motion once the distributor is ready, even when the piece is still far from the exit, avoiding the previous "ready but shoved/lost before exit" failure.
- The C4 hardware worker now restarts/reuses queued work robustly after a stale stop sentinel; the previous stuck state was `hw_pending=1`, `hw_busy=false`.
- C4 classification can still happen early (`classify_pretrigger_exit_lead_deg=160` in the current test profile), but distributor handoff requests are now horizon-gated. The best current compromise is `handoff_request_horizon_deg=90`: `60` was safer but starved the distributor; unbounded early handoff caused order thrash.
- C3 transport bad actors no longer freeze upstream at three ignored tracks. The current software block threshold is eight ignored transport bad actors. Five visible non-carrying C3 parts were later drained/distributed instead of freezing C1/C2.
- The current best measured distributed score is **10 distributed in 180 s = 3.33 PPM** (`scored-180s-c1-rhythm2s-low1-handoff90`). That same run classified **26 in 180 s = 8.67 classified PPM**, but it ended with C2/C3/C4 WIP and C4 overfill, so it does not count as 8 solid PPM.
- The honest current conclusion is: **C4 safety/handoff is much better, C1 can feed, and classifier throughput can reach the target band, but sustained distributed throughput is still blocked by C4 backlog/dispatch balance and upstream backpressure.**
- `run_observer.py` post-run drain now must require the whole line to be idle (`C2/C3/C4` runtime and runner counts zero), not merely distributor idle. Older `drained=true` summaries before this change can hide C3/C4 WIP.
- C1 now has a live `feed_inhibit` maintenance gate and an orchestrator C4-backlog gate. This lets downstream local drains happen without fighting new bulk feed, and lets C4 WIP stop C1 before the line turns a good classification rate into an overfilled C4 state.

Update from the 2026-04-26 dynamic live-tuning pass:

- The machine was restarted, homed to `ready`, and visually/camera-checked clean before the dynamic tests: direct C2/C3/C4 detection showed no objects and RT showed C2/C3/C4 empty.
- A conservative 90 s loop (`live-dynamic-cautious-loop-90s`) distributed `+2` and classified `+3`. Flow-gate accounting showed C1 was too conservative: `BLOCKED_C2_VISION_TARGET_BAND` plus `BLOCKED_C2_VISION_EXIT_QUEUE` dominated while C4 was mostly not backlogged.
- Opening C1 live (`target_low=2/3`, `target_high=4/5`, faster C1 pulses) immediately improved feed but rebuilt C4 backlog. The 120 s loop (`live-dynamic-open-c1-loop-120s`) classified `+10` and distributed `+3`; C1 was then correctly stopped by `BLOCKED_C4_BACKLOG_DOSSIERS`.
- The follow-up drain with `feed_inhibit=true` (`local-drain-after-dynamic-open-c1-inhibited`) distributed another `+3`, reached `drained=True`, and ended clean by RT and direct camera detections.
- Current lesson: dynamic live tuning is the right workflow, but the control law needs hysteresis/phase awareness. C1 should be allowed to refill when C4 is genuinely starved, then inhibited quickly when C4 has 2+ dispatch dossiers; otherwise it oscillates between starvation and C4 backlog.

Earlier, the stationary part had remained detected after:

- a 180 s C2/C3/C4 purge attempt;
- direct C3 reverse/forward moves;
- direct C2/C3/C4 detection verification.

Direct detection after that purge timeout:

| Channel | State |
| --- | --- |
| C2 | no object detected |
| C3 | 1 object detected at the C2->C3 landing area |
| C4 | no object detected |

Do not run another throughput test until the tray state has been visually checked again and the C3 clustered/stiction state has either been purged, manually cleared, or deliberately selected as a localized C3 transport test. Any run started from an unintended C3 cluster is invalid for PPM scoring.

Safety update from the 2026-04-26 morning recovery attempt: aggressive maintenance motion can make the C-channel steppers skip and sound rough. Sample transport and direct debug moves are now capped in software, but the operating rule remains stricter than the code: if a recovery move causes skipping, rattling, or harsh circular noise, stop immediately, power-cycle/re-home if needed, and continue only with lower speed/acceleration and shorter local probes.

## Test protocol

Each tuning iteration should be small:

1. Capture `/api/system/status`, `/api/rt/status`, `/api/rt/tuning`, and current C2/C3/C4 track snapshots.
2. Visually inspect the C2/C3/C4 trays before every test.
   - Look at the current camera frames/overlays, not only numeric track counts.
   - Record the physical starting state: empty, lightly loaded, overloaded, clumped, or containing a known bad actor such as a round/stationary piece.
   - Decide explicitly whether to purge, partially drain, manually remove a piece, or keep the state as an intentional loaded-start condition.
   - Do not start a throughput test if the trays do not match the intended starting condition.
3. Use conservative maintenance motion only.
   - Prefer normal runtime pulses or capped sample transport over direct stepper moves.
   - Start local recovery at low speed/acceleration and short duration; scale only after camera evidence shows smooth motion.
   - Do not use long direct moves or high-rpm sample transport as a purge substitute.
   - Stop immediately on skipped steps, rough circular noise, or visible loss of motion authority.
4. Run a short observed test window.
   - Start with 30-60 s while behavior is uncertain.
   - Move to 3-5 min only after C4 flow is stable.
5. Record:
   - distributed pieces/min;
   - classified pieces/min;
   - bin-correct single-piece ejections;
   - any multi-piece tailgating during a single C4 exit release;
   - visual starting condition and purge/no-purge decision;
   - registered piece backlog;
   - C2/C3/C4 live track counts;
   - C3/C4 density and clump symptoms;
   - blocked reasons from runtime status;
   - `flow_gate_accounting` Pareto from the run summary;
   - any audible or visible harsh motion.
6. Change one small cluster of related parameters.
7. Repeat and compare to the previous run.

## Density heuristic

The desired physical state is not "as empty as possible" and not "as full as possible".

Good:

- C3 and C4 show multiple separated pieces across the tray.
- The exits are fed regularly, but not buried.
- Pieces have enough spacing that tracking can hold stable identities.
- C4 has enough candidates to keep the classifier and distributor busy.

Bad:

- C2 stores a pile because the bulk bucket dumped too much at once.
- C3 exit area repeatedly forms a clump.
- C2 or C3 pushes several pieces through an exit in one short burst.
- C4 contains many pieces in one arc and empty space elsewhere.
- C4 must use harsh or frequent recovery motion to keep up.

## C1/C2 burst controller

C1 is not a precision feeder. A single C1 pulse can produce no piece, one piece, a few pieces, or a large clump if the hopper exit releases a packed bridge. Do not tune C1 as though `N` pulses should yield `N` parts.

The intended control model is:

**C1 is a stochastic bulk source. C2 is the measured buffer and first singulator.**

Runtime C2 now exposes a compact density snapshot for the orchestrator:

| Metric | Meaning |
| --- | --- |
| `c2_occupancy_area_px` | Sum of visible C2 bbox areas; a rough burst/load signal. |
| `c2_piece_count_estimate` | Fresh visible C2 track count, including pending tracks. |
| `c2_clump_score` | Simple polar-spacing/cluster score from 0.0 to 1.0. |
| `c2_free_arc_fraction` | Largest empty angular gap as fraction of the platter. |
| `c2_exit_queue_length` | Stable tracks already in the C2 exit/approach queue. |

C1 is allowed to feed only when C2 is low and clean. Current first-pass constants:

| Gate | Value |
| --- | --- |
| target low | `< 1` C2 visible pieces |
| target high | `>= 3` C2 visible pieces blocks C1 |
| clump block | `c2_clump_score >= 0.65` with at least two visible pieces blocks C1 |
| exit queue block | `c2_exit_queue_length >= 1` blocks C1 |
| C4 raw backlog block | `c4.raw_detection_count >= 7` blocks C1 |
| C4 dossier backlog block | `c4.dossier_count >= 3` blocks C1 |

If C2 is in the middle band, C1 holds and lets C2/C3 drain. This intentionally trades a little peak feed aggressiveness for fewer bulk avalanches onto C2 and fewer C2->C3 clump transfers. C1 still also respects transitive C3 and C4 backpressure, so it will not add material just because C2 is low when C3 is saturated or C4 already has a dispatch backlog.

## Stop conditions

Pause or back off immediately when:

- C4 starts visibly overfilling;
- C4 stepper motion sounds aggressive again;
- distributor handoff failures repeat;
- C4 releases more than one visible piece during one distributor-ready/commit cycle;
- a trailing C4 piece falls into the bin positioned for the previous classified piece;
- runtime blocked reasons stay stuck instead of cycling;
- track counts explode relative to visible pieces;
- pieces are being classified but not physically distributed.

## Working hypothesis

The path to 10 PPM is likely not higher C4 acceleration. It is a better density gradient:

**C2 buffers gently -> C3 singulates and spaces -> C4 stays moderately populated -> classifier and distributor remain continuously fed.**

That means the main work is runtime tuning plus observability around density, not simply making each motor faster.

## C-channel singulation invariant

C2, C3, and C4 should all behave like gated exits, with stricter correctness the further downstream a piece gets:

1. C2 should avoid dumping several pieces into C3 at once. It may be a little forgiving, but the next platter should receive separated arrivals rather than bursts.
2. C3 should avoid pushing a short train of pieces into C4. C4 needs spaced arrivals for stable tracking, classification capture, and a clean final ejection queue.
3. C4 is strict: one classified piece, one distributor-ready decision, one physical release attempt.
4. If an exit handoff was just started, the runtime should hold nearby following pieces for a short configurable gap before allowing the next handoff.
5. If the same exit track is still waiting for the downstream side to accept it, the runtime should not create repeated downstream claims for that same track.

## C4 to distributor invariant

C4 must treat the distributor as a per-piece gate, not as an open drain:

1. Once a C4 piece has a classification result, C4 may request a distributor handoff before the physical exit, ideally during the final approach window.
2. The distributor must finish moving to the selected bin and signal ready before C4 releases that piece.
3. A distributor-ready signal authorizes exactly one C4 eject attempt for the matching `piece_uuid`.
4. The exit release should be gentle and narrow enough that only the matched piece falls. If the matched piece is more than half inside the exit zone but does not drop, C4 may use a small exit wiggle for that same piece.
5. The next piece must remain staged behind the exit until it has its own classification result, bin decision, distributor-ready signal, and eject/commit cycle.

Throughput only counts when this invariant holds. A run with 10 physical pieces/min is a failure if multiple pieces ride through one bin decision.

## Open work queue

These are the current known tasks, ideas, and hypotheses while driving toward 10 real PPM. Keep this list compact and update it after each meaningful run or code change.

| Priority | Task / idea | Why it matters | Current next action |
| --- | --- | --- | --- |
| P0 | Fix the active C4 tracked-piece projection truth | Runtime C4 can be empty while `/api/tracked/pieces` still shows old active C4-zone rows. That makes Recent/Tracked and observer queue metrics look unstable or wrong. | Verify and fix the `piece.registered/classified/distributed/lost` projection so delivered/lost C4 pieces become terminal/inactive reliably. |
| P0 | Visually verify tray state before every test | Numeric RT counts can miss the operational reality: leftover piles, clumps, or a round/stationary object can invalidate a run before it starts. | Before each run inspect camera frames/overlays, document the starting condition, and choose purge/partial drain/manual removal/no-purge deliberately. |
| P0 | Treat stationary or non-carrying C3 parts as localized blockers | A part can sit on C3 without moving with the platter, causing correct lease denial or invalid local C1-dose trials. | Runtime C3 quarantines stationary landing-arc tracks and post-transport non-carrying tracks. Validate live with the current stuck C3 object; if this becomes frequent, add a mechanical anti-hook/stiction feature instead of expanding software ghost logic. |
| P0 | Do not blindly score PPM runs while C3 has visible transport bad actors | Ignored C3 tracks keep software flow from freezing, but the physical parts still occupy the tray and can invalidate feed/throughput conclusions. | Observer reports `c3_transport_bad_actor_visible`; C3 now blocks upstream capacity only when the ignored transport cluster reaches 8 pieces. Deliberately decide whether a run is a bad-actor stress test or a clean PPM test. |
| P0 | Make purge success camera-backed | C234 purge can report `cleared` while a fresh camera frame still sees one C2/C3 part shortly afterward. That invalidates automated dose-loop trials. | Observer post-run drain now checks line-idle state, but the maintenance purge coordinator itself still needs camera/runner-backed clear hold. |
| P0 | Use flow-gate accounting before the next tuning change | `downstream_full` hides whether C4 admission, lease spacing, density caps, or distributor readiness is the real blocker. | Compare the `Flow Gate Pareto` in each `run_observer` summary before changing spacing/admission parameters. |
| P0 | Keep enforcing one C4 piece per distributor decision | The 10 PPM target is invalid if trailing pieces fall into the bin positioned for the previous classification. | Keep C4 handoff ordering strict: nearest physical exit candidate only, abort stale handoffs, and only one eject per `piece_uuid`. |
| P0 | Use burst diagnostics to explain multi-arrival drops | When >2-3 pieces appear in a downstream dropzone quickly, we need the upstream motion context, not guesswork. | Review `handoff_burst_diagnostics` after each run and tune C1/C2/C3 exit spacing based on concrete burst records. |
| P1 | Verify the C1/C2 vision burst controller live | Current C1/C2/C3 behavior still oscillates between starvation and clumps. The first C1 gate from C2 density is implemented, but not yet proven in a clean run. | After resolving the current C3 transport/stiction cluster, run a short visual-start test and watch `capacity_debug.c1.controller`, C2 density, and C1 pulse cadence. |
| P1 | Validate the C1/C4 backpressure hysteresis live | Code is in (resume thresholds + sticky block state, default 4/1 below 7/3) but unmeasured. Without hysteresis the gate flapped at the high-water mark every distributor cycle, which let C1 fire one bulk pulse per cycle and rebuilt C4 backlog. | After the next backend restart, run a 90-180 s C1-feeding loop and watch `c1.c4_backpressure.blocked` and the `*_holding` reasons in `capacity_debug.c1`. Adjust `raw_resume` / `dossier_resume` if the dwell band is too narrow (gate flaps) or too wide (C1 starves while C4 has room). |
| P1 (live) | Validate the headroom-gated C1 recovery escalation | Code is in (`c1.recovery_admission` with seed q95 estimates `[3, 6, 12, 25, 40]` and safe capacity 14), but the seed numbers are heuristic. The original symptom was the 2026-04-26 stepper-skip when a high-level recovery push fired into a near-full C2. | Force a stall with C2 partially loaded and watch `c1.runtime_debug.last_recovery_admission`. The decision must show `allowed=false / reason=insufficient_c2_headroom` for higher levels until C2 drains. After enough live data, replace seed `level_estimates_eq` with measured q95 from `c1_pulse_observations.jsonl`. |
| P1 (live) | Calibrate `level_estimates_eq` and pulse output from observation logs | Each C1 dispatch now lands in `logs/c1_pulse_observations.jsonl` with `delta_c2_*` measurements at +1 s and +3 s per `action_id` (`pulse` or `recover_level_N`). The headroom-gated recovery currently relies on **seed** q95s that have not been measured. | After 50-100 dispatches per action, group by `action_id`, compute q50/q95/q99 of `delta_t3.c2_piece_count_estimate`, and `runtime_tuning` the new q95s into `c1.recovery_admission.level_estimates_eq`. Same procedure can later refresh the C2 vision target band and the C1/C4 hysteresis thresholds. First 23 live samples already confirm seed `[3, 6, 12, 25, 40]` is too low for level 0 (observed `[1, 4, 7]` non-zero outputs; max `7`). |
| P0 | Add C2 clump-quarantine / micro-wiggle escape | C2 has no bad-actor / clump-escape path analogous to C3. Once 3 pieces land within a 60° arc on C2 (`min_spacing_deg ≈ 3`, `max_cluster_count_60deg=3`), the vision burst gate hits `clump_score=1.0` and C1 is blocked for the whole run. Two consecutive 180 s test runs in this session distributed `0` because of this lock-out. | Add a periodic small reverse/forward C2 wiggle that fires when `clump_score >= 0.65` and `pulse_count_estimate <= max_piece_count` — break the clump before the gate locks. Alternatively, model a C2 transport-bad-actor suppression like C3's `transport_bad_actor_suppression`. |
| P0 | Document and operationalise the platter-friction bottleneck | The 2026-04-26 acceleration sweep (4 runs, A-D) produced 0.0 / 0.0 / 1.89 / 1.25 PPM. PPM variance across runs is partly physical (stuck pieces) but the section-shadow observer at 17:34 showed the ceiling is **not** physical — Main's section-based logic would have allowed C1 to feed 92 % of the run while sorthive blocked it 69 %. | Out-of-software next steps: visual inspection of the C3/C2 surfaces during a stuck-piece episode; passive C1 weir to cap worst-case dump size; anti-hook geometry. Software side: pick the architectural option below before the next throughput attempt. |
| P0 | Decide architectural path: keep multi-layer backpressure or revert to Main-style sectional logic | Live shadow observer evidence (2026-04-26 17:08–17:38, ``logs/sector_shadow.jsonl``) shows sorthive's C1 backpressure stack (``vision_density_clump``, ``vision_target_band``, ``c4_backpressure_holding``, ``transport_bad_actor_cluster``) is the dominant cap on PPM. Disabling them progressively brought PPM 0.0 → 2.17, but Main's sectional logic delivered 6-7 PPM at ~1/10 the LOC. | Section path (option A) is now wired in as ``orchestrator.feeder_mode = "section"``. Geometry calibration is the next gate before a fair PPM comparison. |
| P0 | Make section-mode the default feeder path (after the daemon-death bug is fixed) | Clean A/B 2026-04-26 19:21–19:55 measured **lease 1.07 PPM** vs **section 2.08 PPM** under identical conditions. Section's calibrated geometry (`c2_intake_center=-60°`, narrow `c3_exit_arc=8°`) and piece caps deliver ~2× throughput at ~10 % of the LOC. The remaining gap to Main's 6-7 PPM is downstream of the feeder. | Wait for the daemon-thread-death bug (next row) before making section the default; once stable, change the bootstrap default to `feeder_mode="section"` and tighten lease back as the fallback / debug path. |
| P1 | Investigate orchestrator daemon-thread death after long sessions | 2026-04-26 19:35: in the second section-mode A/B round, the orchestrator's daemon loop stopped advancing (`tick_count` flat across polls, individual runtime `last_tick_ms` still reflecting older work). Switching `feeder_mode` did not revive the loop. Only a supervisor hard restart recovered. Backend log captured camera-init noise but not the underlying exception. | Reproduce with a deterministic stress sequence (purge → tune → resume → run → repeat). Add an explicit watchdog that logs when the daemon hasn't ticked for >2 s. Possibly the issue is a deadlock or thread leak around live tuning patches mid-run. |
| P0 | Drive the C4 classify + distributor cycle next (the new bottleneck) | With section feeder removed as the cap, C4's `front_already_requested = 2122` vs `accepted = 14` shows the time budget is dominated by C4 transport waiting for classification + distributor handoff. The simulated chute is fast (1 s + 0.4 s settle + 1.5 s fall = ~3 s/piece), but the classify pre-trigger and handoff horizon currently leave the front piece in `front_already_requested` for most of its rotation. | **Done**: `CarouselC4Handler` (commit 82baa60), live wiring (RuntimeC4 `set_carousel_mode_active` + orchestrator `_tick_carousel_c4_handler`), and 5-sector mode for the new platter (commit pending). 585 tests passing. **Next**: install the 5-wall platter, switch `c4_mode = "carousel"` + `geometry.sector_count = 5`, run a fair lease/runtime vs section/carousel A/B from a clean state, then move the cap further downstream. |
| P0 | First-run config for the 5-wall C4 platter (install 2026-04-27) | New rotor with 5 physical walls forces pieces into fixed 72° sectors. The carousel handler + sector mode + wall-angle calibration path are wired; the operator-side workflow on first install is the only remaining question. | Step-by-step: (1) install rotor, home machine, drain via the C234 purge, then verify all three trays are physically empty with ``scripts/grab_camera_frame.py 0/1/2 /tmp/cN.jpg``. (2) Capture 60–120 wall frames at varied platter rotations: ``uv run --with websockets python scripts/wall_detector_capture.py --output-dir captures/c4_walls_<date> --duration-s 90 --frame-period-s 0.5 --c4-rpm 1.0`` — script auto-inhibits C1 feed and slowly rotates C4 via ``sample_transport`` while pulling frames off the camera-preview WS. (3) Label the frames with Gemini: ``OPENROUTER_API_KEY=… uv run python scripts/wall_detector_collect.py --input-dir captures/c4_walls_<date> --output-dir datasets/c4_walls_<date> --preview --min-walls 4`` (script defaults already set, ``--preview`` writes overlay JPEGs for spot-checking). (4) Review ``datasets/c4_walls_<date>/previews/`` for any wrong boxes, fix the corresponding ``.txt`` by hand if needed. (5) Train a small YOLO model (single class ``wall``, class_id 0) on the resulting tree. (6) At runtime, post detected wall angles via tuning API: ``{"orchestrator": {"carousel_c4_handler": {"geometry": {"wall_angles_deg": […]}}}}`` — the handler auto-snaps ``classify_deg`` / ``drop_deg`` to the matching sector centers. (7) Visual cross-check from the camera frame; if the snapped angles don't physically match the chute geometry, override them via ``geometry.classify_deg`` / ``geometry.drop_deg``. |
| P1 | Tune C2/C3 singulation earlier in the chain | Every downstream platter is easier when the previous exit avoids short trains of parts. | Keep C2/C3 retry pulses bounded; tune handoff gap, precise pulse size, and escalation separately per channel. |
| P1 | Keep distributor prepositioning, but only in physical exit order | Early handoff requests can hide chute/bin movement time, but wrong ordering creates wrong-bin risk. | Preposition only the nearest classified exit-order piece; never request a trailing classified piece ahead of an unclassified/front piece. |
| P1 | Continue with simulated chute while Waveshare is unreliable | We still need meaningful C4 flow tests even when the real chute controller flakes out. | Use `simulate_chute=true` with realistic move/settle/fall timing, and separately monitor real Waveshare availability before real distribution tests. |
| P2 | Improve observer truth source for C4 queue | The observer currently derives queue symptoms from tracked API data that may be stale. | Prefer runtime C4 dossiers for live queue metrics; use tracked API for history/UI validation. |
| P2 | Add a target-density/clump monitor | The desired state is 8-10 well-spaced pieces, not just a count. | Derive simple per-channel density/clump signals from polar spacing and dropzone-arrival bursts. |
| P2 | Run longer confirmation windows once short runs are clean | Short runs are good for debugging but do not prove sustained target throughput. | After reaching clean >=10 PPM in 60 s, run 3-5 min windows with raw observer evidence. |
| P2 | Re-check BoxMot tracker stability under final density | The current tracker is visually good, but density and burst behavior can still create identity churn. | After flow is stable, rerun the replay/live tracker benchmark on fresh raw crops and verify low churn. |

## Changelog

Real PPM is `distributed delta / requested active run window`. Post-run drain time is tracked in the observer summaries but not counted as active throughput.

| Time | Real PPM | Finding / change | Result / next step |
| --- | ---: | --- | --- |
| 2026-04-25 11:00 | n/a | Defined the operating target as 10 clean classified+distributed pieces/min with smooth C4 motion. | Target and test protocol are now explicit. |
| 2026-04-25 11:10 | 0.0 | Baseline 45 s run after homing: `classified +1`, `distributed +0`; C2 filled to 7-9 pieces while C3/C4 did not establish flow. | Do not tune speed yet; fix flow gating first. |
| 2026-04-25 11:15 | n/a | Found repeated `c3_to_c4 taken=4` while C4 had no matching raw detections/dossiers yet. | Treat as C3 handoff/backpressure issue, not as a C4 acceleration problem. |
| 2026-04-25 11:20 | n/a | Added stale C4 dossier cleanup on RT runtime start. | Prevents old active C4 rows from surviving across tracker epochs/restarts. |
| 2026-04-25 11:25 | n/a | Working fix: debounce C3 downstream claims per `global_id` for the handoff hold window. | Next measured run should show C3 not filling all C3->C4 virtual slots with repeats of the same exit track. |
| 2026-04-25 11:30 | 2.5 | First verification after debounce distributed 2 pieces in 48 s and removed C3->C4 slot spam, but C3 still bunched at the exit while C4 ran empty. | Refined the fix: repeat precise C3 pulses for the same exit track are allowed, but they no longer create duplicate downstream claims. |
| 2026-04-25 11:35 | n/a | Second verification saw C4 raw tracks rise to 6, but C4 dossiers stayed at 1 because the zone guard/half-width geometry is too conservative for the 8-12-piece target. | Added live tuning for C4 zone half-width and guard so density can be tuned without backend restarts. |
| 2026-04-25 11:45 | 6.0 | Dense C4 geometry improved the run to 6 distributed/min, but `c2_to_c3` stayed reserved while C2 held 5-8 pieces and C3 still had headroom. | Applied the same no-duplicate-claim repeat-pulse handoff pattern to C2->C3. |
| 2026-04-25 11:58 | 9.3 | Best pre-restart run: controlled C4 density delivered `+7` in a 45 s requested window. | This became the reference tuning direction: moderate C4 density, not max fill. |
| 2026-04-25 12:02 | 8.0 | Follow-up with slightly faster C4 transport delivered `+6` in 45 s; chute telemetry remained healthy. | C3->C4 and startup/loaded-state effects still dominate; C4 acceleration is not the main lever. |
| 2026-04-25 12:05 | n/a | Live observation: C4/distributor can appear to route several trailing pieces through the bin selected for one classified part. | Added C4->distributor single-piece/bin-correctness as a hard success invariant; next fix must enforce one ready/commit/eject cycle per matched `piece_uuid` and tune the exit release/approach to prevent tailgating. |
| 2026-04-25 12:15 | n/a | Implemented the first software guard for that invariant: C4 now marks `eject_enqueued`/`eject_committed` per dossier, so one distributor-ready piece can only enqueue one physical C4 eject before delivery/finalization. | Unit test covers repeated exit ticks for the same ready piece; next live step is to restart RT and tune the mechanical exit pulse so the one allowed eject does not drag followers. |
| 2026-04-25 12:25 | n/a | Waveshare/controller availability was unstable during live work. | Added distributor chute telemetry (`last_move_*`, `last_position_*`) to RT status so test runs can distinguish a healthy bin-positioning path from blind C4 ejection attempts. |
| 2026-04-25 12:35 | n/a | Replaced the broad C4 legacy eject pulse with a narrow configurable exit-release shimmy. | C4 now releases a matched piece with small forward/back wiggles; UI/API expose release amplitude and cycle count for live tuning against tailgating. |
| 2026-04-25 12:08 | 4.0 | Aggressive C3/C4 density trial after homing delivered only `+3` in 45 s. | Too much C4 loading creates registered-but-unclassified backlog; back off. |
| 2026-04-25 12:10 | 6.0 | Steady trial with aggressive density delivered `+6` in 60 s but hit `raw=15`, `dossiers=8`, and 17 samples with confirmed tracks lacking active dossiers. | Marked as bad direction. Do not use high C4 density as the path to 10 PPM. |
| 2026-04-25 12:12 | 7.0 | Controlled-density run delivered `+7` in 60 s, with `raw=9`, `dossiers=4`, and healthy chute telemetry. | Safer and cleaner than aggressive density, but still below 10/min. |
| 2026-04-25 12:14 | n/a | C1 jam was cleared via `/api/rt/c1/clear-jam`; C1 feed recovered and filled C2/C3 from an empty pipeline. | C1 can feed again, but it can overfill C2 quickly; C1 feed cooldown and jam threshold now need live tuning. |
| 2026-04-25 12:15 | 6.0 | Loaded C3 run delivered `+6` in 60 s and exposed a measurement bug: observer paused while distributor was still `ready/sending`. | Increased observer post-run drain default to 8 s, added grace wait, and record drain result in summaries. |
| 2026-04-25 12:26 | n/a | Added C1 runtime tuning for `pulse_cooldown`, `jam_timeout`, `jam_min_pulses`, `jam_cooldown`, and recovery cycle cap. | Next tuning pass can slow C1 deliberately instead of relying on jam recovery after C2 overfill. |
| 2026-04-25 13:05 | n/a | Found false C4 stitch on `27610dc7cbd6`: black ladder tracklet `86` and white bracket tracklet `90` were merged into one piece. | Tightened C4 same-channel `track_split` stitching to a 1.25 s holdover and a 45 deg hard angle gate; cross-channel C3->C4 transit remains separate. |
| 2026-04-25 13:10 | n/a | Waveshare/chute can be unavailable during tuning, but C4 must still wait as if bin positioning happened. | Added distributor `simulate_chute` runtime tuning with configurable simulated move wait and settle time; one-piece C4 handoff stays enforced. |
| 2026-04-25 13:18 | n/a | C4 could hold a real piece at/near the exit that missed the normal classify angle. | Added late-exit classification fallback; C4 can classify at the exit tolerance before waiting for distributor-ready release, avoiding a safe-but-stuck state. |
| 2026-04-25 13:20 | n/a | Live observation: C3 and even C2 can still feed multiple parts downstream in short bursts, creating clumps before C4 has a chance to separate them. | Added the C-channel singulation invariant and C2/C3 runtime handoff spacing so the system can throttle exits earlier, not only at the final C4 distributor gate. |
| 2026-04-25 13:25 | 6.0 | Best post-fix measured window so far: `slow-c1-moderate-c4-90s` delivered `+9` in 90 s with simulated chute wait. | This is stable enough to keep the single-piece C4 gate, but still below target. The remaining gap is upstream density rhythm, not distributor wait. |
| 2026-04-25 13:28 | 1.5 | A near-empty 8-zone target-profile run showed long starvation, then a late C1 bulk dump into C2 (`piece_count` rose to 10) while C3/C4 were empty. | C1 needs to be treated as a controlled feeder, not just "on when C2 has headroom". Keep C1 slow and jam-tolerant during tuning; add better feed/density control before chasing C4 speed. |
| 2026-04-25 13:30 | n/a | Short live runs showed C4 could resurrect a just-delivered `piece_uuid` from a lingering/rebound track and request another distributor handoff. | Added a short C4 delivered-track tombstone so recently delivered UUIDs/raw IDs cannot immediately become new dossiers again. |
| 2026-04-25 13:34 | n/a | C2/C3 still used large normal advance pulses when multiple pieces were on the ring but none was yet inside the approach arc. | Loaded C2/C3 rings now use precise/gentle advance pulses; single far-away pieces may still use normal transport to avoid unnecessary starvation. |
| 2026-04-25 13:35 | n/a | The first C2/C3 spacing fix was too conservative: if the same front track did not physically arrive downstream, the runtime waited for the long slot hold. | C2/C3 now retry the same front track after the configurable handoff gap, but without taking a second downstream claim; different following pieces still wait. |
| 2026-04-25 13:37 | 3.3 | Verification after loaded-ring precise advance reduced the obvious giant-pulse path but did not yet reach 10 PPM (`+5` in 90 s) and still ended with C2/C3 backlog. | Next lever is a real density controller: throttle C1 by observed C2/C3/C4 counts and add C2/C3 target-density windows, instead of only gating per exit handoff. |
| 2026-04-25 17:40 | n/a | Live state after the previous commit still showed C3 waiting on a front track at the exit while C4 had room, with C2/C3 backlog behind it. | Added same-track handoff retry escalation for C2/C3: after repeated failed arrivals, the runtime may use a bounded double precision nudge without creating another downstream claim. |
| 2026-04-25 17:42 | 2.7 | Retry-escalation smoke run delivered `+2` distributed in 45 s after restart/homing. | Functional, but below target; C4 admission was often blocked by intake/dropzone clearance while C2/C3 refilled. |
| 2026-04-25 17:44 | 6.0 | Loaded retry-escalation run delivered `+9` distributed in 90 s. | Throughput returned to the stable 6 PPM band; remaining blocker is C4 admission closed by dropzone/intake arc, not C3->C4 virtual slots. |
| 2026-04-25 17:51 | 5.0 | Early C4 classification submitted pieces before the exit (`submitted_early=7`) and proved the distributor can be prepositioned during approach, but it also exposed an out-of-order ready state: distributor ready for an older trailing piece while a different piece was physically at the exit. | Fix C4 handoff ordering before the next throughput run; early prepositioning must target the next physical exit candidate only. |
| 2026-04-25 18:01 | n/a | Added C2/C3/C4 handoff-burst diagnostics: rolling recent arrivals, recent move decisions, warning log, RT status snapshot, and observer anomaly surfacing when 3+ arrivals appear in a short dropzone window. | Next runs should capture concrete upstream move context whenever C2->C3 or C3->C4 dumps several pieces in one burst. |
| 2026-04-25 18:01 | n/a | Fixed C4 distributor preposition ordering: C4 now requests the distributor only for the nearest physical exit-order candidate and aborts a stale ready handoff when another piece is actually at the exit. | Unit tests cover ordering and out-of-order abort; restart RT and rerun short controlled windows toward 10 PPM. |
| 2026-04-25 18:04 | 4.0 | First smoke after handoff-order fix delivered `+2` in 30 s, but startup/recovered tracks produced noisy burst diagnostics. | Suppress baseline/recovery false positives so burst logs represent new real downstream arrivals. |
| 2026-04-25 18:06 | 8.0 | Second 30 s smoke delivered `+4`; false-positive burst noise was mostly gone. | Good short signal, but follow-up status still showed C2/C3 burst history and C4 underfeed. |
| 2026-04-25 18:08 | 5.0 | Slower C1 plus single C2/C3 retry pulses delivered `+5` in 60 s and showed C3 stuck waiting for downstream arrival while C4 recovered tracks without releasing C3's slot. | Fix C4 recovered cross-channel transit so C4 can claim pending C3 transit and release the upstream slot. |
| 2026-04-25 18:12 | 7.0 | After C4 recovered-transit release, run delivered `+7` in 60 s and `+10` classified; C4 transit linking improved. | Best current post-fix candidate, but still below target and still shows occasional C2/C3 bursts. |
| 2026-04-25 18:14 | 6.0 | Faster C4 transport (`step=5`, `rpm=1.1`) delivered `+6` in 60 s. | Faster C4 transport did not help; keep C4 smooth baseline and focus upstream rhythm/projection truth. |
| 2026-04-25 18:16 | 3.0 | Allowing double C3 retry nudges delivered only `+3` in 60 s, despite few observer anomalies. | Double nudges are not the current path; return to bounded single nudges and inspect why metrics/Tracked still show stale active C4 rows. |
| 2026-04-25 18:25 | n/a | Live inspection shows runtime C4 `dossier_count=0`, but `/api/tracked/pieces` still reports multiple active C4-zone rows. | Treat projection truth as the next blocker before trusting observer queue metrics or tuning from Tracked UI state. |
| 2026-04-25 18:30 | 1.0 | Hand-off to a fresh debugging pass. Baseline after backend restart fell to 1 PPM because runtime tuning resets to compile-time defaults on every restart, and the doc-recorded controlled-density values were no longer in code. | Move the 9.3-PPM lab values into the code defaults so a homed runtime starts at the right operating point. |
| 2026-04-25 19:14 | n/a | Built a step debugger: pause the orchestrator, step ticks one at a time, inspect dossiers / claims / slot deadlines without spelunking private fields. New API `/api/rt/debug/{pause,resume,step,inspect}`, frontend page at `/dashboard/debug`. | Architecture principles 6 and 7 (introspection + durable debugging). Used immediately to diagnose the slot/admission discrepancies below. |
| 2026-04-25 19:30 | 4.0 | Defaults moved to controlled density (`c3.max_piece_count` 3 → 8, `c4.max_zones` 4 → 9, intake half/guard 10/28 → 7/6). | Confirmed homed runtime now reaches the 4-5 PPM band straight out of restart. |
| 2026-04-25 19:50 | n/a | C4 trailing-piece safety guard added before the exit-release shimmy, anchored on the chute geometry (drop angle ± `exit_trailing_safety_deg`). Without it the shimmy occasionally nudged a second nearby piece off the carousel into the bin positioned for the matched piece. | Prevents wrong-bin double-drops; the operator confirmed the failure mode live. |
| 2026-04-25 20:00 | n/a | Slot system un-gated. Live debugger surfaced repeated cases of `downstream_full` while every CapacitySlot read 0/N empty: a transient claim from an upstream pulse that never produced a downstream arrival held the slot for its 3 s expiry. The orchestrator now sources `capacity_downstream` only from the downstream runtime's `available_slots()`, and `CapacitySlot.try_claim` is permissive (claims still recorded as a debug breadcrumb). | KISS, fewer redundant gates fighting each other. |
| 2026-04-25 20:24 | 4.7 | Operator caught C3 visibly overflowing (~25 pieces, tracker no longer separating them) after I had also removed the C3 cap. Restored the C3 cap as the load-bearing brake; C2's cap stays as the C1 backpressure surface. | Singulation invariant must hold all the way upstream; the cap was not actually a soft hint. |
| 2026-04-25 20:27 | 4.7 | Faster C3 transport (rpm 1.2 → 2.0, exit_handoff_min_interval 0.7 → 0.5) — distributor now ~65% utilized, but C4 still drains too fast between deliveries. | Per-piece distributor cycle is ~5.3 s with the simulated chute (4 s move + 0.3 s settle + ~1 s fall + eject). Theoretical max ~11 PPM. Remaining gap is upstream rhythm keeping a classified piece always ready at C4 exit. |
| 2026-04-26 | n/a | Added runtime flow-gate accounting and run-summary Pareto output so `downstream_full` can be split into concrete causes such as C4 admission, density cap, lease denial, distributor wait, cooldown, or chute singleton guard. | Next run should be a clean 60-90 s baseline using the current controlled-density profile. Accept 8 solid PPM as the first stable waypoint; only then relax C3->C4 spacing or C4 admission. |
| 2026-04-26 | n/a | Distributor servo bus showed intermittent offline errors during homing. Switched live tuning to simulated distributor positioning (`simulate_chute=true`, `simulated_chute_move_s=3.5`, `chute_settle_s=0.4`, `fall_time_s=1.5`) so C4 still waits on the handoff protocol without depending on the unstable physical layer-servo bus. | Treat the next runs as flow/safety runs, not bin-correctness validation. Keep C4 exit-hold safety active and watch for `c4_transport_near_exit_without_distributor_ready` anomalies. |
| 2026-04-26 | 4.0 | `sim-distributor-3p5s-flow-safety` distributed `+4` in 60 s with simulated distributor wait. No `c4_transport_near_exit_without_distributor_ready` anomaly was recorded. Flow Pareto still points at C2/C3 density caps and C4 admission (`dropzone_clear` + `arc_clear`) as the dominant upstream rhythm issue. | Keep the simulated distributor for flow debugging while the servo bus is unstable. Next useful change is not distributor tuning; inspect why C4 has low usable WIP despite C3/C2 being full. |
| 2026-04-26 | n/a | C1 has no explicit startup prime move, but its first normal pulse was allowed immediately after start/resume (`_next_pulse_at=0`) if C2 capacity looked open before perception had settled. | Added a configurable C1 `startup_hold_s` (default 2.0 s) that arms on runtime start/resume and is visible in RT debug/tuning. This should prevent cold-start C1 bulk drops into an already-loaded C2 ring. |
| 2026-04-26 | 1.3 | `c1-20step-start-dose-45s` proved the hold alone was not enough: C1 stacked queued pulses (`pulses_since_progress` jumped to 14) because it checked `hw.busy()` but not `hw.pending()`, and RT was using aggressive jam defaults (`4s/3 pulses`) instead of FeederConfig (`10s/6 pulses/8s cooldown`). | Fixed C1 to block while hardware commands are queued, pass FeederConfig jam values into RuntimeC1, and use a 4.0 s runtime C1 pulse cooldown. |
| 2026-04-26 | n/a | Local C1 dose series after visual clean-start: 12 single 20-step pulses produced no C2 detection; one single 50-step pulse produced one small C2 candidate. | Use 50 steps as the current C1 dose again, but only with the new pending-gate and 4 s observation cooldown. Purge to clean start before the next full-flow run. |
| 2026-04-26 01:55 | 1.3 | C1 progress-observation hold was too short-lived: first C2 progress cleared the hold and allowed follow-up C1 pulses before downstream had stabilized. | C1 progress now extends the observation hold window instead of clearing it; use this to prevent blind post-progress bulk feed. |
| 2026-04-26 02:14 | 1.5 | Clean run with C1 50-step / 3 unconfirmed / 6 s observation showed transitive C1 backpressure working, but C3->C4 admission remained a large blocker. | C1 now also respects C3 density through orchestrator transitive backpressure; next valid clean run should inspect C3->C4 lease/admission in isolation. |
| 2026-04-26 02:22 | 3.3 | Fresh hopper run distributed `+10` in 180 s but ended overfilled (`C2=10`, C4 backlog). Flow Pareto: C1/C2 density, C3->C4 admission arc, and distributor send time all visible; no unsafe C4 release anomaly observed. | Not a solid 8 PPM result. C1 can feed, but the feed controller still oscillates between starvation and overfill. |
| 2026-04-26 02:26 | 2.5 | With C1 effectively held, downstream drain distributed `+5` in 120 s and emptied C4/distributor, but C2 stayed blocked by a C3 landing-area object. | Treat C3 landing-area stationary parts as a separate local blocker before further flow tuning. |
| 2026-04-26 02:30 | n/a | C2/C3/C4 purge timed out after 180 s with C2 clear, C4 clear, and one C3 object still detected. Direct C3 reverse/forward did not move it. | Manual removal or a mechanical anti-hook/recovery feature is required before the next fair 8 PPM test. C2 now reports C3 landing-lease denial as `lease_denied` instead of generic `downstream_full`. |
| 2026-04-26 02:45 | n/a | Added localized C3 bad-actor suppression for physically stationary/rolling-back round parts in the C2->C3 landing arc. It is not a general ghost system: ignored tracks are visible in `upstream_bad_actor_suppression`, do not block upstream landing leases, and become active again after clear angular motion. | Restart backend before the next live test so the runtime loads this code. Validate with a short clean run, watching for ignored-count changes and no C2 freeze on a single stationary C3 landing object. |
| 2026-04-26 09:35 | 0.0 | Restarted backend, homed, verified C2/C3/C4 empty, then ran `after-round-badactor-removal-and-c3-ignore-120s`. The C3 ignore rule triggered live (`ignored_count=1`) and prevented the single stationary landing track from blocking C2, but no pieces reached C4. | New local blocker: several C3 pieces clustered near the upper/landing side did not move meaningfully despite repeated C3 pulses. C1 was put back into held mode; next work should isolate C3 mechanical transport/stiction before more C1 tuning. |
| 2026-04-26 10:00 | n/a | Reframed C1 as a stochastic bulk source instead of a precise dose generator. Added C2 density metrics (`c2_occupancy_area_px`, `c2_piece_count_estimate`, `c2_clump_score`, `c2_free_arc_fraction`, `c2_exit_queue_length`) and an orchestrator C1 gate that feeds only when C2 is low, unclumped, and not already queued at the exit. | Code path is unit-tested. Next live test should happen only after visual tray inspection and the current C3 transport/stiction state is cleared or intentionally isolated. |
| 2026-04-26 10:08 | n/a | Partial local C1 stochastic-dose loop (`2026-04-26_09-49-57_c1-dose-stochastic-loop`): six planned single-dose trials were stopped early. Valid clean-start observations for one 50-microstep-equivalent C1 pulse were `0 parts` then `1 part`; the next observations were contaminated because purge reported clear while the camera still saw a part. | C1 really behaves stochastically at the current dose, but the automated loop must require camera-zero after purge. The last test left C2 clear, C4 clear, and one C3 part at about `-28 deg` that did not clear after 12 s C3/C4 sample transport. |
| 2026-04-26 10:24 | n/a | Added C3 transport bad-actor suppression for physically visible parts that remain angularly stationary after real C3 pulse/sample/purge movement attempts. This is separate from the C2->C3 landing-arc suppressor and is visible as `transport_bad_actor_suppression` in C3 debug. | Restart backend and validate against the current stuck C3 object before restarting any PPM run. A waiting exit piece with downstream closed is explicitly not quarantined by this path. |
| 2026-04-26 10:55 | 1.5 | Clean `c1-single-dose-vision-c4recovered-120s` run distributed `+3` in 120 s. C4 classified/distributed cleanly once fed, but C3 accumulated non-carrying/stationary physical bad actors and C1 delivered too little usable feed. A later aggressive recovery attempt used too-high sample/direct motion values and caused stepper skipping/noise. | Added maintenance safety caps: sample transport now clamps to 8 rpm / 12k max speed / 80k acceleration, and direct debug moves reject excessive degrees/speed/acceleration. Continue with short, low-speed local probes only. |
| 2026-04-26 11:05 | 0.0 | After safe restart and clean C2/C4 state, a cautious C1 50-step flow smoke produced `+4 pieces_seen`, `+1 classified`, `0 distributed`, and left five C3 detections clustered around `-70..-100 deg`. Runtime C3 correctly ignored all five as transport bad actors; a gentle C3-only 2 rpm / 4k / 30k / 20 s sample-transport pass did not move them meaningfully. | This exposed a physical C3 transport/stiction blocker. At the time, three ignored transport bad actors froze upstream; later testing raised that block threshold to eight so localized C3 weirdness can be ignored instead of halting the line. |
| 2026-04-26 11:27 | 1.0 | `post-c4-hold-fix-50step-c1-60s` distributed one controlled piece after C4 requested a distributor handoff at ~49 deg and then held transport until the simulated distributor was ready. | Confirms the "do not shove before distributor ready" fix. Throughput was low because C1/C3 feed was sparse. |
| 2026-04-26 11:32 | 0.0 | `post-c4-ready-gentle-approach-50step-c1-60s` stopped the previous premature C4 push-out, but exposed a worker race: C4 held a ready piece with `hw_pending=1`, `hw_busy=false`. | Fixed `HwWorker` stale-stop-sentinel handling and added C4 `hw_worker` debug. |
| 2026-04-26 11:47 | 1.0 | Local single-piece C2 start distributed `+1` and ended C2/C3/C4 clean. | C4 handoff/distributor simulation is correct for a controlled single piece. |
| 2026-04-26 11:51 | 1.0 | Local C2 cluster drain with C1 held distributed `+2` in 120 s and ended clean. | C2/C3/C4 can drain clusters safely, but not fast enough. |
| 2026-04-26 11:56 | 0.5 | `classify_pretrigger_exit_lead_deg=160` increased classification (`+7`) but only distributed `+1`; early distributor handoffs thrashed/order-changed. | Added `handoff_request_horizon_deg` so early classification does not imply very early distributor reservation. |
| 2026-04-26 12:02 | 0.7 | C2 burst stress test with `handoff_request_horizon_deg=60` distributed `+2` in 180 s. C4 was safe and no out-of-order thrash dominated, but C3 transport bad actors blocked C1/C2 for 137 s. | Raised C3 transport bad-actor upstream block threshold from 3 to 8. This lets localized rolling/stationary parts be ignored without freezing the whole process. |
| 2026-04-26 12:07 | 4.0 | C3 bad-actor threshold smoke distributed `+3` in 45 s from the previously visible C3 parts and ended with C3 clear. | Confirms the higher threshold matches the "ignore localized physical weirdness, do not halt the system" policy. |
| 2026-04-26 12:09 | 1.0 | First scored run with C1 50-step, C4 pretrigger 160, handoff horizon 60 distributed `+2` in 120 s. | Horizon 60 was safe but too conservative; many C4 pieces waited outside the handoff horizon. |
| 2026-04-26 12:15 | 1.7 | Scored 180 s run with C1 50-step, C4 pretrigger 160, handoff horizon 90, and C3 bad-actor threshold 8 distributed `+5`. | Best current post-fix score, still far below 8 PPM. Ended with C3/C4 WIP, proving old observer `drained=true` was misleading. |
| 2026-04-26 12:19 | n/a | C1-held downstream drain after the scored run distributed `+2` and truly emptied C2/C3/C4 by direct detection and runtime debug. | Updated `run_observer.py` so post-run drain requires line idle, not only distributor idle. Next work should focus on upstream rhythm: C1 burst cadence and C2/C3 singulation, not C4 acceleration. |
| 2026-04-26 12:32 | invalid | A scored run after backend restart was invalid because the system had not been homed; C1 state advanced but the stepper was unavailable and no real hardware feed occurred. | After every backend restart, verify `ready`/home before treating any run as evidence. |
| 2026-04-26 12:48 | 3.3 | Best current honest distributed score: `+10` in 180 s with C1 50-step / 2 s cooldown, C2 vision low=1/high=3, C4 pretrigger 160, handoff horizon 90, simulated distributor wait. The same run classified `+26` = 8.67 classified PPM. | Not solid: it ended with C2/C3/C4 WIP and C4 overfill. The target classifier rate is reachable, but C4 dispatch/backlog is not yet controlled. |
| 2026-04-26 12:56 | 2.7 | Tight C4 cap trial (`max_zones=3`, `max_raw_detections=5`, handoff horizon 120) distributed `+8` in 180 s. | Worse than the best run and still left WIP; hard-capping C4 too far starves useful dispatch. |
| 2026-04-26 13:05 | 1.0 | Faster C4 approach trial (`exit_approach_step_deg=5`, `target_rpm=1.1`) distributed `+3` in 180 s. | Faster C4 motion did not help and reduced stability. Revert to conservative C4 motion. |
| 2026-04-26 13:14 | 2.3 | Shorter simulated distributor cycle (~3.7 s total) distributed `+7` in 180 s. | Not better; the main blocker is not simulated chute wait. |
| 2026-04-26 13:25 | n/a | Added live-tunable C1 backpressure from C4 backlog (`c1.c4_backpressure.raw_high`, `dossier_high`) and exposed it through `/api/rt/tuning`. | Use a dynamic live-tuning loop: start conservative, observe C2/C3/C4, then adjust C1/C2 and C4-backlog thresholds in small steps instead of static profile guessing. |
| 2026-04-26 13:28 | 1.3 | First dynamic loop from a clean, homed start used conservative C1/C4 settings and distributed `+2` / classified `+3` in ~98 s. | Too conservative: C1 spent most of the run blocked by one visible C2 part or one C2 exit-queue item while C4 was mostly empty. |
| 2026-04-26 13:30 | 1.4 | Second dynamic loop opened C1 live and used moderate C4 motion. It classified `+10` and distributed `+3` in ~127 s, then C1 was stopped by the new C4 backlog gate (`BLOCKED_C4_BACKLOG_DOSSIERS`). | Confirms the new C4-backlog gate works. The missing piece is a smoother controller/hysteresis that feeds C4 without letting the dossier queue pile up. |
| 2026-04-26 13:33 | n/a | C1 was set to `feed_inhibit=true` and the line was drained. The drain distributed `+3`, reported `drained=True`, and direct C2/C3/C4 detections afterwards were all clear. | Safe stopping point for the next session: machine line is empty, C1 inhibited, and the live-tune evidence points at C1/C4 hysteresis rather than C4 speed. |
| 2026-04-26 14:05 | n/a | Code-only change: added hysteresis to the C1/C4 backpressure controller. Once `raw >= raw_high` or `dossier >= dossier_high` trips the gate, C1 stays inhibited until *both* counters relax to/below `raw_resume` / `dossier_resume`. New tunables in `c1.c4_backpressure`; defaults `raw_high=7 / dossier_high=3 / raw_resume=4 / dossier_resume=1`. The `capacity_debug` reason is now one of `backlog_dossiers`, `backlog_raw`, `backlog_dossiers_holding`, `backlog_raw_holding`. | Not yet validated live. Restart backend before the next run so the new tunables and snapshot fields are visible. Validate by watching `c1_c4_backpressure.blocked` flip true on backlog spike and stay sticky through one or two distributor cycles before releasing. |
| 2026-04-26 14:35 | n/a | Code-only change: added per-pulse C1 pulse-response observer. Every C1 dispatch (`pulse` or `recover_level_N`) snapshots `c2_piece_count_estimate / c2_clump_score / c2_free_arc_fraction / c2_exit_queue_length / c2_occupancy_area_px / c4_raw_detection_count / c4_dossier_count` at dispatch, +1 s, and +3 s. Records persist as JSONL at `logs/c1_pulse_observations.jsonl` and surface live in `inspect_snapshot.c1_pulse_observer.recent`. | Not yet exercised. After backend restart, every C1 pulse during a live run should append one row. After 50-100 dispatches per action we can compute real q50/q95/q99 for each level and replace the seed estimates in `c1.recovery_admission.level_estimates_eq`. |
| 2026-04-26 14:50 | n/a | Code-only change: headroom-gated the C1 jam-recovery escalation ladder. Each level now consults `Orchestrator.c1_recovery_admission_decision(level)` before the recovery push fires. The check compares a per-level seed q95 (default `[3, 6, 12, 25, 40]` pieces for levels 0-4) against the current C2 headroom (`c2_safe_capacity_eq - c2_piece_count_estimate`, default safe capacity 14). If the worst-case dump would not fit, recovery is held with `blocked_reason="recovery_headroom_insufficient"` and the attempt counter does **not** advance. Tunable as `c1.recovery_admission.{enabled, c2_safe_capacity_eq, level_estimates_eq}`. | Not yet exercised. Pre-fix evidence is the 2026-04-26 morning stepper-skip incident: an aggressive recovery move skipped the C-channel stepper. With headroom-gating that level would have been deferred until C2 had drained. After backend restart, induce a stall on a near-full C2 and confirm `last_recovery_admission.allowed=false` instead of a hardware push. |
| 2026-04-26 15:21 | 0.46 | Code-only change verified live: backend restarted, all three new tunables visible in `/api/rt/tuning`. First post-restart 131 s run (`post-hysteresis-and-recovery-admission-120s`) distributed `+1`. C3 transport bad-actor cluster locked C1+C2 for 62 s (47% of run). | Three new code paths confirmed wired in live. C3 stuck-piece cluster from prior session dominated the run; not a fair PPM measurement. |
| 2026-04-26 15:31 | 2.83 | After C234 purge + C3 sample-transport drain at 2 rpm, run `loaded-c3-post-purge-120s` distributed `+6` in 127 s. Flow Pareto showed `c1:BLOCKED_C4_BACKLOG_DOSSIERS_HOLDING: 33.1 s` — the new sticky-block reason firing live. **Hysteresis validated**: the gate held through one or two distributor cycles instead of flipping bang-bang. | Best-known controlled-density profile is back online and measurable. |
| 2026-04-26 15:36 | 3.19 | `open-c2-burst-180s` with `c2.max_piece_count=7` and C1 vision band `target_low=2 / target_high=4` distributed `+10` in 188 s. Hysteresis sticky-block totalled 63 s. C4 active 80% of run, distributor active 46%. | New best post-fix score under live conditions. Not 8 PPM, but the new code paths are clearly functional and the hysteresis is contributing real damping evidence. |
| 2026-04-26 15:40 | 2.22 | `doc-best-c4-horizons-180s` reverted C4 to old best (`classify_pretrigger=160 / handoff_horizon=90`) — distributed `+7`, **worse** than the smaller horizons. Anomalies climbed: 13 transport-bad-actor samples vs 8 the prior run. | Wider C4 horizon was not the bottleneck. Reverted to `pretrig=72 / horizon=60`. |
| 2026-04-26 15:44 | 3.10 | `c1-cooldown-2s-180s` lowered `c1.pulse_cooldown_s` from 4.0 → 2.0; distributed `+10` in 194 s. Cooldown-block time dropped from 87 s → 22 s. C4 active 80%. Hysteresis 40 s. | C1 cooldown 2 s is the new live default; cooldown was eating ~46% of the previous run. |
| 2026-04-26 15:48 | 1.93 | `c3-faster-2rpm-180s` raised C3 transport rpm 1.2 → 2.0 and `exit_handoff_min_interval_s` 0.85 → 0.5. Distributed `+6` in 186 s — **worse** than rpm 1.2. | Faster C3 transport did not help. Reverted. Confirms operator hypothesis: faster motion is not the bottleneck. |
| 2026-04-26 16:02 | 0.0 | `accel-sweep-A-30k-2k-180s` set C2/C3 normal acceleration to 30000 us/s² (was null/motor default) and C4 transport_acceleration 4000 → 2000. Distributed `0` in 187 s. C3 transport bad-actor cluster threshold (8 ignored tracks) locked upstream feed for 187 s = 100%. | Too gentle — the 2500-step C3 pulse never reaches top speed, pieces don't get enough impulse to start moving with the platter. |
| 2026-04-26 16:06 | 0.0 | `accel-sweep-B-80k-1.5k-180s` raised C2/C3 accel to 80000, C4 to 1500. Still distributed `0` in 191 s; bad-actor cluster from run A persisted (24 anomaly samples). | Stuck-piece state inherited; gentler accel could not dislodge what aggressive accel had stuck. |
| 2026-04-26 16:11 | 1.89 | After `c234` purge + aggressive 60 s C2/C3/C4 sample-transport with default acceleration to dislodge stuck pieces, `accel-sweep-C-60k-2k-clean-180s` ran with C2/C3 normal accel 60000 and C4 2000. Distributed `+6` in 191 s. | Cleaner state, but gentler accel still slower than null/default (which would target 12000 us/s top speed instantly on a 2500-step pulse). |
| 2026-04-26 16:15 | 1.25 | `accel-sweep-D-c3-small-pulse-180s` reduced C3 normal `steps_per_pulse` 2500 → 1000 with accel 50000. Distributed `+4` in 191 s. C2 clumped (`vision_density_clump` blocked C1 for 182 s). | Smaller pulses on C3 reduced effective C3 throughput; pieces piled up on C2 and clumped. The acceleration hypothesis is not validated by the data: in this physical setup, low accel with the existing pulse profiles starves the platter of impulse before the platter can carry pieces. The cleaner finding is that the throughput ceiling is dominated by physical platter-grip variance, not accel choice. |
| 2026-04-26 16:21 | 0.0 | Restored best-known profile (run 3 baseline) and re-ran `best-profile-final-180s` and `best-profile-final-take2-180s`. Both distributed `0` because the previous experimental runs left 3 pieces clumped at one C2 sector (`min_spacing_deg ≈ 3.2`, `max_cluster_count_60deg=3`, `clump_score=1.0`), and the C2 vision burst gate blocked C1 for the whole 190+ s window. | C2 has no bad-actor suppression analogous to C3's transport quarantine; physically clustered pieces lock C1 out. Recommend either (a) extending the C2 layer with a transport-bad-actor / clump-quarantine path similar to C3, or (b) a periodic micro-wiggle on C2 to break clusters mechanically before they trigger the gate. |
| 2026-04-26 16:30 | summary | Best PPM in this session: **3.19 PPM** (10 distributed in 188 s, run 3 / `open-c2-burst-180s`). PPM range across 6 measured runs with similar profiles: 0.46 / 2.83 / **3.19** / 2.22 / 3.10 / 1.93. Acceleration sweep added 4 more runs at 0.0 / 0.0 / 1.89 / 1.25 PPM. Pulse-response observer captured live evidence: of 23 normal C1 pulses, 20 produced 0 visible C2 pieces, 3 produced (1, 4, 7) — empirical q95 ≈ 7 vs seed estimate 3. Software hysteresis + headroom-gating + observation tooling are now in place. | Open: extend C2 with a clump-quarantine / micro-wiggle escape so pieces that arrive in a cluster cannot lock C1 out indefinitely. Replace seed `level_estimates_eq` with measured q95 from `c1_pulse_observations.jsonl`. |
| 2026-04-26 17:08 | n/a | Operator reminder: legacy ``main`` branch routinely hit **6-7 PPM** with a discrete 4-position carousel + section-based C-channel feeder (~4 100 LOC for feeder/classification/vision). Current sorthive ``rt/`` subtree has ~41 700 LOC and tops out at ~3 PPM. Built a non-invasive **Sector Shadow Observer** (rt/services/sector_shadow_observer.py) that re-evaluates Main's pre-rt feeder logic on top of the live BoxMot tracks at 2 Hz and writes side-by-side decisions to ``logs/sector_shadow.jsonl``. | Run ≥30 s with the observer attached, then look at ``divergence_counts`` in the snapshot. Anything > 0 on c1 means sorthive blocked when Main would have allowed. |
| 2026-04-26 17:12 | 0.0 | First live shadow run with the default sorthive backpressure stack: **427/427 samples diverged on C1**. Sorthive blocked C1 with ``vision_density_clump`` 100 % of the run; Main's intake-only check would have allowed C1 100 % of the run. Live track angles showed 3 stationary pieces clustered at -111° / -114° / -121° on C2 (10° apart, hits ≈ 1 399, no exit/intake overlap) — sorthive's polar-spacing heuristic flagged them as a clump, Main's section logic would have just emitted PULSE_NORMAL on C2. | Concrete deadlock identified: sorthive's clump check is a false-positive when pieces stick in mid-arc. Run again with the gate disabled. |
| 2026-04-26 17:13 | n/a | Tried setting ``c1.vision_burst.clump_block_threshold = 1.0`` to disable the gate, but the runtime check was ``clump_score >= threshold`` and the validator capped the threshold at 1.0. Patched the validator (orchestrator + tuning service) to allow up to 2.0, so any value > 1.0 effectively skips the gate (clump_score is in [0, 1]). | Restart picks up the new bound. |
| 2026-04-26 17:26 | 1.55 | First post-fix run with ``clump_block_threshold = 1.5`` and ``target_low / target_high = 6 / 8`` (Main-style intake-only gating). Distributed +5 in 192 s. Shadow observer: divergence dropped from 100 % → 49 %; Main would have allowed 79.9 % of samples. Top remaining sorthive blockers: ``vision_target_band`` 65 samples, ``backlog_dossiers_holding`` 60 samples (the hysteresis added earlier in this session), ``piece_cap`` 43. | Main-style gating actually moves pieces — system unblocked from the deadlock state. Hysteresis and band block now dominate. |
| 2026-04-26 17:34 | 2.17 | Aggressive Main-parity run with ``observation_hold_s = 1.0``, ``pulse_cooldown_s = 1.0``, vision_burst 8/12, raised ``c4_backpressure`` to 30/15 (effectively disabled). Distributed +7 in 194 s. Shadow observer: divergence rose to 69 % (more pieces flowing → more frequent sorthive blocks); Main would have allowed 92 % of samples. Top blocker: ``c1:BLOCKED_C3_TRANSPORT_BAD_ACTOR_CLUSTER`` 62 s (32 %). | More pieces enter the line, but ``transport_bad_actor`` quarantine takes over from clump+band+hysteresis. |
| 2026-04-26 17:38 | summary | **Architectural finding (Option C validation):** sorthive's C1 backpressure stack systematically blocks C1 in situations Main allowed. Across three live runs with progressive gate relaxation, divergence dropped 100 % → 49 % → 69 %, and PPM rose 0.0 → 1.55 → 2.17. Even with all sorthive gates relaxed to Main parity, PPM still trails Main's 6-7 because the rest of the C-channel pipeline (leases, dossier FSMs, transit registry, BoxMot identity layer) adds latency that section-based logic does not have. The 3 PPM ceiling is **not** physical — it is software architectural overhead that compounds across the C2/C3/C4 chain. | Strategic options for next session: (1) keep BoxMot tracking for image collection but replace the C2/C3 *decision logic* with a section-based path inspired by Main, ignoring the per-piece dossier state for the feeder side; (2) keep the architecture and just disable/relax the gates that the shadow observer has now proven false-positive (lower-effort, but caps below Main); (3) partial: rip out clump_block + lease-based C2→C3 spacing first, leaving the rest. |
| 2026-04-26 18:00 | n/a | Built `rt/services/section_feeder_handler.SectionFeederHandler` as **alternative primary path** for C1/C2/C3 (operator request: keep BoxMot for image collection, just swap the decision layer). Adds an `orchestrator.feeder_mode` flag (`"lease"` default = old path, `"section"` = new path). When section mode is active, the orchestrator skips ticking C1/C2/C3 runtimes and the handler issues pulses directly via the same hardware callables the runtimes use (no parallel hardware writers). C4 + distributor keep ticking unchanged. | Tunable live as `orchestrator.feeder_mode = "section"`. Added the `orchestrator` key to the `/api/rt/tuning` payload (RuntimeTuningPayload + handler) so the mode can be flipped without a restart. |
| 2026-04-26 18:14 | n/a | First live section-mode run: 0 distributed in 188 s. The handler **did fire pulses** (C1: 18, C2: 26, C3: 3) but pieces stacked on C2 (18 tracks at end of run, scattered around the platter). Only 5 reached C3, none reached C4. Root cause: my initial `intake_center_deg` guesses (180° for both C2 and C3) match C3 (the runtime confirms `_upstream_lease_arc_center_rad = 180°`) but **not C2** — pieces clustered between -88° and -47° on C2, ~33° away from the assumed 180° intake. C2's actual intake angle (where C1 drops pieces) is not a runtime parameter and needs to be calibrated from observed track distributions. | Next: (a) add `orchestrator.section_feeder_handler.{c2_geometry,c3_geometry}` to the tuning API so the operator can sweep `intake_center_deg` live; (b) pick the C2 intake center from the observed track histogram during a short feed burst; (c) re-run. The section handler itself is correct (557 tests passing). |
| 2026-04-26 18:25 | n/a | Added live tunables `orchestrator.section_feeder_handler.{geometry,cooldowns_s,piece_caps}` to the runtime_tuning API. Calibration burst (C2/C3 cooldowns parked at 60 s, C1 free): pieces appeared on C2 at angles `[-121, -61, -39]` after 10 C1 pulses, with one piece at -61° in the C1 drop zone. **Empirical C2 intake center ≈ -60°** (vs the 180° seed). | C3 intake center 180° was already correct (matches runtime `_upstream_lease_arc_center_rad`). |
| 2026-04-26 18:31 | 1.85 | Section mode with calibrated geometry (`c2.intake_center_deg=-60`, `intake_arc_deg=20`): distributed `+6` in 194 s. Pulse activity jumped: C1 18→92 (5×), C2 26→278 (10×), C3 3→111 (37×). Pieces actually reached C4 (4 tracks) for the first time in section mode. But C3 piled up (29 tracks at end) because the section handler had no piece-cap analog to Main's discrete carousel — the next channel's intake-arc check alone wasn't enough back-pressure. | Add explicit `piece_caps` per channel (Main's 4-slot carousel had this implicitly). |
| 2026-04-26 18:38 | 0.0 | Added `c2_piece_cap` / `c3_piece_cap` (default 8) and re-ran. Hardware chute servo failed mid-run (`returned_false` from Waveshare); distributor stuck in `positioning` so nothing distributed. Switched to `simulate_chute=true` for a clean software-only comparison. | Hardware flake, not a section-mode regression. |
| 2026-04-26 18:45 | 0.0 | Section + caps + simulated chute also distributed `0`. Cause was *physical* state, not software: the previous runs had left ~9 pieces stuck on C4 (front piece in `drop_commit`, distributor `STATE_READY` for 27 s while C4 transport pulsed without delivering). Swapping to lease mode at the same physical state also produced `0` distributed in 189 s — confirming this was an inherited stuck-state, not a section-mode regression. | Hard restart of the backend cleared C4 dossier state; physical pieces (23 on C3, 9 on C4) remain. Stopping the live run loop here — accumulated physical state is dominating PPM and a fair section-vs-lease comparison needs a cleaner starting state than software can produce. |
| 2026-04-26 18:50 | summary | **Section-feeder validation is software-complete**: handler is wired, calibrated geometry tunable live, piece-caps add the missing back-pressure analog to Main's discrete carousel, full path covered by 559 tests. Live PPM comparison was inconclusive in this sitting because of accumulated stuck pieces on C3/C4 from earlier runs — both lease and section delivered 0 with the same physical state. Best clean-state section run delivered 1.85 PPM with calibrated `c2_intake_center=-60`, vs lease mode's previous best 3.19 PPM with the legacy stack. | Next session must start from a *physically* drained line (operator-side), then run the lease/section A/B comparison from a known clean state. Section side is ready; the gap to Main's 6-7 PPM remaining after that A/B is what's worth measuring. |
| 2026-04-26 19:15 | n/a | Visual sanity check: connected directly to `/ws/camera-preview/{index}` and grabbed one JPEG per channel after a long C234 purge. Confirmed C2/C3/C4 all physically empty (one small piece on C3 after a later second purge but minimal contamination). Camera index map: `c_channel_2=2`, `c_channel_3=1`, `classification_channel=0`. | Visual purge verification is repeatable from a single curl + websocket script in `scripts/grab_camera_frame.py`. |
| 2026-04-26 19:21 | 1.21 | **A/B 1 lease** from clean state, simulated chute (`AB-lease-clean-180s`): `+4` distributed in 198 s. Best-known lease profile (`vision_burst 2/4`, `clump_block 1.5`, `c2.max_piece_count=7`). | First leg of the A/B comparison. |
| 2026-04-26 19:26 | 1.58 | **A/B 1 section** with calibrated geometry (`c2_intake_center=-60°`, `c3_intake_center=180°`, `piece_caps {c2:7, c3:8}`): `+5` distributed in 190 s — **+30 % over lease in the same conditions**. | First measured win for section mode in a clean-state A/B. |
| 2026-04-26 19:35 | 0.0 | A/B round 2 attempted with section + narrow C3 `exit_arc=8°` (favouring NORMAL pulses for the C3→C4 lip). Run delivered 0; investigation showed the orchestrator daemon thread had stopped advancing — `tick_count` stayed flat across multiple `/api/rt/status` polls, even though individual runtimes still reported recent `last_tick_ms` from before. Switching `feeder_mode` back to lease did **not** revive the loop. Hard supervisor restart was the only recovery. Logs did not capture the exception (camera-init noise dominated). | Daemon-thread death is a separate bug worth investigating: aging behaviour, possibly tied to long sample-transport runs or tuning patches mid-run. Filed as P1. Hard restart cleared it. |
| 2026-04-26 19:52 | **2.58** | After hard restart + clean state, **Section AB3** (`AB3-section-fresh-180s`) distributed `+8` in 186 s — **best clean-state section result, 2.13× lease**. C4 accepted 14 handoffs (out of 12 classified, 8 distributed). Section pulse activity: C1 38 normal, C2 37 normal + 85 precise, C3 46 normal + 32 precise. | The architectural argument is now empirical: with calibrated geometry + piece caps, Main-style sectional decisions outperform the lease/dossier stack on the same hardware. Gap to Main's 6-7 PPM remaining is downstream of the feeder (C4 classify cycle + distributor handoff). |
| 2026-04-26 19:55 | summary | **Clean A/B summary** — Lease average over 2 rounds: 1.07 PPM (4 + 3) / (198 + 194) s. Section average over 2 valid rounds: 2.08 PPM (5 + 8) / (190 + 186) s. Section is **~2× lease** end-to-end on this rig with the calibrated geometry. The remaining ~3× gap to Main's 6-7 PPM is now measurably *not* in the feeder layer — C4 + distributor cycle dominates the time budget (C4 `front_already_requested` at 2122 vs `accepted` at 14). | Next bottleneck to attack: C4 classify+handoff cycle. Open work item below. |
| 2026-04-26 20:30 | n/a | Built `rt/services/carousel_c4_handler.CarouselC4Handler` — Main's serial-carousel scheduler ported to our continuous polar C4. Treats the platter as a virtual carousel with two angular checkpoints (`classify_deg`, `drop_deg`) and steps the front piece through a sequential state machine: `IDLE → ADVANCING_TO_CLASSIFY → SETTLING_AT_CLASSIFY → AWAIT_CLASSIFICATION → REQUESTING_DISTRIBUTOR → AWAIT_DISTRIBUTOR_READY → ADVANCING_TO_DROP → DROPPING`. RuntimeC4 keeps doing perception + classifier submission + dossier bookkeeping (so BoxMot piece UUIDs and image crops still work in carousel mode); the handler only owns the *scheduling* decisions (when to pulse C4 transport, when to request distributor handoff, when to fire eject). | New tunable surface: `orchestrator.c4_mode = "runtime" | "carousel"` (default runtime); `orchestrator.carousel_c4_handler.{geometry, timing}` for live calibration. 13 tests cover the state machine end-to-end plus orchestrator + tuning round-trip. **Live integration not switched on yet** — full bypass of RuntimeC4's transport/eject decisions when `c4_mode="carousel"` is the next session. The handler is wired and ready; the bootstrap attaches it and the orchestrator exposes the toggle, but the orchestrator's `_tick` does not yet route C4 decisions through the handler. |
| 2026-04-26 21:30 | n/a | Live integration of carousel handler shipped: RuntimeC4 has a new `set_carousel_mode_active(bool)` flag that disables internal transport/handoff/eject decisions while keeping perception + classifier submission live. New `carousel_front_snapshot()` exposes the front-piece state (live track angle from the `PieceTrackBank`, classification result, distributor handoff state) for the orchestrator to forward into the handler. Orchestrator `_tick` now calls `_tick_carousel_c4_handler(now_mono)` whenever `c4_mode == "carousel"`, building a `CarouselTickInput` from the front snapshot + distributor pending state. Switching modes also flips RuntimeC4's bypass flag automatically. | First wired test attempt was inconclusive — accumulated stuck pieces from earlier runs were not admitted as dossiers, so the handler had no front piece to work on. The carousel path itself is wired correctly (verified by orchestrator integration tests); a fair PPM A/B against `c4_mode = "runtime"` needs the line drained first and the new C4 platter installed. |
| 2026-04-26 22:00 | n/a | **5-wall C4 platter design — install 2026-04-27.** Marc completed CAD for a new C4 rotor with 5 physical walls dividing the platter into 5 hard 72° sectors. Pieces inside a sector are forced to travel with the platter (no more stiction / sliding — the dominant variability source in 2026-04-26's PPM measurements). C2 and C3 keep their existing wall-less rotors. | Software prepared: `CarouselC4Handler` got a `sector_count` + `sector_offset_deg` mode (default 0 = continuous, set to 5 for the new platter). When sector mode is on the handler auto-snaps `classify_deg` / `drop_deg` to the nearest sector centers, sets `advance_step_deg = 360 / sector_count` (one full sector per pulse), and widens default tolerances to "sector-half-width minus 10 % margin". New helpers `sector_index_for(angle)` / `sector_center_deg(idx)` for diagnostics. Snapshot exposes `sector_size_deg`, `classify_sector_idx`, `drop_sector_idx`. Tuning API: `orchestrator.carousel_c4_handler.geometry.{sector_count, sector_offset_deg}`. 22 tests cover sector mode (snapping, indexing with offset, default-tolerance derivation, switching to sector mode mid-flight). |
