basicallysource/sorter-v2/docs/src/content/hardware/assembly/install-bins.md

---
layout: default
title: Install the bins
type: how-to
section: hardware
slug: assembly-install-bins
kicker: Assembly — Install the bins
lede: The bins that catch what the chutes drop, and the three ways to get them.
permalink: /hardware/assembly/install-bins/
og_image: https://assets.basically.website/sorter-docs/install-bins-printed-bins-from-above-w1600-3edc30bd133f.jpg
author: spencer
contributors: [brickcyclealice, daddyosbricksbill]
tools_needed: ["Hot glue gun, for cardboard bins", "Laser cutter, or a cutting service, for cardboard bins", "Sharp knife, metal ruler, A4 printer and paper or thin card stock, if you are cutting cardboard bins by hand"]
last_verified: 2026-09-25
parts_needed:
  - part: bin-half-left
    qty: 6
  - part: bin-half-right
    qty: 6
  - part: bin-third-left
    qty: 6
  - part: bin-third-center
    qty: 6
  - part: bin-third-rightback
    qty: 6
---

Bins go in last, after the electronics, so the chutes can be connected and their movement tested with the bays still empty. Nothing here is fastened: each bin drops into its bay and is held by the [bin retainers]({{ '/hardware/assembly/distribution/bin-frame/bin-retainers/' | relative_url }}) that are already bolted to the frame.

The list above is per layer, and a layer takes **one** of the two sets, not both. Which set depends on the size of that layer's funnel, which is step 1.

**Step 2 is three ways of getting the same bins**, printed, laser cut or cut by hand. They fit the same frame, so the choice is cost and what you own.

{% include step.html n="1" title="Check which set each layer takes" %}

Each layer takes the set that matches the funnel already fitted to it.

- **A half-size layer** takes **12 bins**: 6 Bin (half, left) and 6 Bin (half, right).
- **A third-size layer** takes **18 bins**: 6 each of Bin (third, left), Bin (third, center) and Bin (third, right-back).

Six bays around the hexagon, with two bins in each bay on a half-size layer and three on a third-size one. A machine can mix the two sizes, in any order up the stack.

Changing a layer to the other size at this point means printing a new funnel as well as new bins. [Funnel brackets]({{ '/hardware/assembly/distribution/chute/funnel/' | relative_url }}) is where that choice is made.

{% include step.html n="2a" title="Either: print the bins" %}

Your layer's two or three bin parts are in the parts catalog with their STLs, printed the same way as everything else ([Printing the parts]({{ '/hardware/printing/' | relative_url }})). Nothing but a printer and time.

Budget for it, and start it early. A half set is about 2.1 kg of filament and 55 hours of printing per layer, a third set about 2.1 kg and 60 hours, so a five layer machine is roughly 10 kg and about 300 hours in bins alone. That is the single biggest print on the machine.

<figure class="single-figure">
  A five layer distribution stack on casters, every bay filled with blue 3D printed bins: three across on the top two layers, two across on the bottom three
  <figcaption>Printed bins. This machine mixes the sizes: third size on the top two layers, half size on the bottom three. <cite>Photo: Daddy-O's Bricks - Bill.</cite></figcaption>
</figure>

{% include step.html n="2b" title="Or: laser cut them from cardboard" %}

What the bins were designed for: cut flat, folded and glued. Cut them with the [laser cut bin generator](https://bin-gen.basically.website/), which turns a bin into a foldable flat pattern.

<ol class="numbered-steps">
  <li>Pick your bin from the <strong>built-in bins</strong> list. You only need a CAD file if you have modified one, and then you drag your own <code>.step</code> in instead.</li>
  <li>Set <strong>thickness</strong> to your stock. 1/8 inch cardboard is 3.175 mm, which is the default.</li>
  <li>Leave <strong>kerf compensation</strong> on, so the finger joints come out the size they were drawn.</li>
  <li>Export <strong>SVG</strong> to hand to somebody else's laser, or the LightBurn file if you are driving your own. Avoid the DXF for now: it carries no layer colours, so LightBurn merges the cut and score lines into one layer.</li>
  <li>Cut in colour order, <strong>green first, then blue, then red</strong>, with the green side face up. Green is the fold score and only goes through the first outside wall of the corrugation, so it has to be cut while the sheet is still whole. Blue perforations and red outlines are both full through cuts.</li>
  <li>Fold the bin up and glue the corners.</li>
</ol>

<div class="callout callout-warning">
  <span class="callout-icon" aria-hidden="true">⚠</span>
  <p>The built-in <strong>Bin (third, right-back)</strong> is wrong: it has no front wall, so it gives you three panels instead of four. Do not cut it. Export <strong>Bin (third, left)</strong> instead and mirror the pattern before cutting: the right bin is the left one flipped. Or print that bin, or cut it by hand from the template below. Until the generator is fixed (<a href="https://github.com/basicallysource/sorter-v2/issues/1137">#1137</a>).</p>
</div>

<div class="callout callout-warning">
  <span class="callout-icon" aria-hidden="true">⚠</span>
  <p>Glue the corners of a cardboard bin. The folded finger joints on their own do not hold in corrugated stock: most of the volume is air, so a finger usually lands on two paper walls with nothing between them. Hot glue is what the bins at Basically are held together with.</p>
</div>

**No laser of your own.** A makerspace or an online laser cutting service will cut the sheets from the exported file. Each bin is one connected piece and cannot be split across two smaller sheets, so give them the size up front: on the default 3.175 mm stock a half-size bin's flat pattern is about 410 x 390 mm, and the largest of the three third-size ones about 345 x 300 mm.

<figure class="single-figure">
  A bin tower on castors under its plywood deck, five layers of folded cardboard bins with sorted LEGO in them
  <figcaption>Laser cut cardboard bins, on the same frame. <cite>Photo: Basically.</cite></figcaption>
</figure>

{% include step.html n="2c" title="Or: cut them by hand" %}

No laser and no cutting service: print a paper template, tape it together, and cut the cardboard with a knife. Four templates cover all five bins, because the two half bins are mirror images of each other and come off the same one.

[Download the hand cutting templates](https://assets.basically.website/sorter-parts/bin-hand-cutting-templates-1e894705ea20.zip), a zip of four PDFs. Each one opens with a cover sheet: a view down into the finished bin, what you need, and the eight steps. After that it tiles the pattern across A4, four sheets for a half bin, four for third left, three for third centre, two for third right-back.

You need a printer, A4 paper or thin card stock for the template itself, a sharp knife, a metal ruler, something to measure thickness with, tape, a hot glue gun and a pin.

<ol class="numbered-steps">
  <li>Print every sheet at <strong>100% or Actual size</strong>, never Fit to Page. Thin card stock outlasts paper.</li>
  <li><strong>Once printed, measure the bar at the foot of each page.</strong> It must be 100 mm. If it is not, the print is scaled: fix the setting and print again.</li>
  <li>Tape the sheets together on the registration crosses. The same cross is printed on both sheets of every overlap.</li>
  <li><strong>Measure the thickness of the cardboard</strong> and follow the one outline that matches. Every template carries three, for 4, 5 and 6 mm stock, tagged along their length.</li>
  <li>Turn the template until the long double-headed <strong>FLUTES</strong> arrow runs the same way as the corrugations. Tape it down, draw round it, then lift it off and cut. Do not cut against the paper: you need the template a dozen times or more.</li>
  <li>Score the folds on the face that will be inside the bin, cutting the inner liner only, then fold towards the score.</li>
  <li>Fold the bin up and glue the corners.</li>
</ol>

<div class="callout callout-warning">
  <span class="callout-icon" aria-hidden="true">⚠</span>
  <p>Leave the toothed edge off. Each template draws a dotted straight line across it: cut there instead. The notches that key a bin onto the retainer's teeth are too fine to cut by hand in 4 to 6 mm corrugated. A bin without them still sits in its bay and is held by the same retainers, it just slides along the rail rather than locking to it.</p>
</div>

**One blank makes either hand.** The face you score becomes the inside of the bin, so scoring the other face gives you the mirror bin and you never need a second template. Dry fold the paper both ways and hold it to an empty bay to see which is which: the toothed edge belongs along the bottom front, against the rail, and the narrow end points at the middle of the machine.

{% include step.html n="3" title="Drop them in" %}

<figure class="single-figure">
  A layer seen from floor level, filled with folded cardboard bins radiating out from the chute in the middle
  <figcaption>A finished layer, seen from below. Photographed on an early build, so the frame around the bins is an older revision. <cite>Photo: Spencer.</cite></figcaption>
</figure>

Work around one layer at a time. Each bin sits in its bay with the wide open mouth facing outward and the narrow end toward the middle of the machine, resting on the frame, with its front edge behind the Bin retainer (left) and Bin retainer (right) on the front face of that bay's A extrusion. The retainers bolt to the frame and not to the bin, which is why cardboard and printed bins are held the same way and why swapping one for the other later costs nothing.

**A bin does not just sit behind the rail, it keys into it.** The inner face of a retainer carries seven teeth just below its top edge, and the lower front edge of a bin is castellated to match, so a bin dropped into its bay lands with its notches over those teeth and is located along the rail rather than free to slide. Cut bins have the same edge: it is part of the flat pattern.

Push each bin fully back until it seats. If one stands proud, it is sitting on a tooth rather than over one: lift it and drop it again.

<figure class="single-figure">
  Close-up of two bin retainer rails: the upper bin is seated with its castellated front edge meshed into the rail, the lower bin is lifted clear so the rail's own teeth are visible
  <figcaption>The joint, seen at one corner. The upper bin is seated and its castellations are over the rail's teeth; the lower bin is lifted clear so the teeth show. <cite>Photo: Daddy-O's Bricks - Bill.</cite></figcaption>
</figure>

If the retainers are not on the frame yet, they go on first: 6 of each per layer, 2 {% include fastener.html size="M5" variant="socket-button" length="16" %} each, into T-nuts fitted at that step. That step is on [Bin retainers]({{ '/hardware/assembly/distribution/bin-frame/bin-retainers/' | relative_url }}).

{% include step.html n="4" title="Check the funnel clears every bin" %}

The funnel lands right at the bin entrances by design, so there is very little gap for a piece to escape through, and very little room for a bin that is sitting proud of its bay. Before running the machine, turn the chute stack by hand to each end of its travel and watch that nothing touches. You will feel the chute stepper resisting; it should still turn smoothly against that. If a bin touches, push it fully back into its bay and turn again.

## The finished result

Every bay on every layer loaded, and the chute turning clear of all of them.

<figure class="single-figure">
  A loaded distribution stack seen from above and to one side, five layers of blue printed bins radiating out around the corner column, casters on the floor below
  <figcaption>Every bay on every layer loaded. <cite>Photo: Daddy-O's Bricks - Bill.</cite></figcaption>
</figure>

With the bins in, the hardware is finished. Continue to [Software setup]({{ '/hardware/software-setup/' | relative_url }}), which is where the machine is told how many bins each layer has and where they are.
