basicallysource/sorter-v2/docs/src/content/sorter/installation/sorter-os.md

---
layout: default
title: Install the SorterOS image
type: installation
section: sorter
slug: installation-sorter-os
kicker: Installation — SorterOS image
lede: Flash an SD card, power on the Orange Pi, and put it on your WiFi from your phone. The Pi sets up the rest.
permalink: /sorter/installation/sorter-os/
warning: >-
  **SorterOS changes quickly.** This page describes what each step does, but a
  button's name, or where it is, may have changed since this page was written,
  so it keeps screenshots to a minimum.
og_image: https://assets.basically.website/sorter-docs/sorteros-first-load-sorter-ui-full-c7e8aae4ac07.png
audience: self-hosting operator
applies_to: sorteros v4.x
last_verified: 2026-09-24
tools_needed:
  - A computer with a microSD card reader
  - Balena Etcher
  - A phone, or an Ethernet cable to your router
parts_needed:
  - part: microsd-32gb
    qty: 1
---

<div class="notice notice-warn">
  <strong>Orange Pi 5 only</strong>
  <p>The SorterOS image runs on the <a href="{{ '/hardware/orange-pi-5/' | relative_url }}">Orange Pi 5</a> with 8 GB of memory or more.</p>
</div>

## What you need

The [Orange Pi 5]({{ '/hardware/orange-pi-5/' | relative_url }}) already in the machine, with 8 GB of memory or more, and the card and tools above. You also need your WiFi's password, unless the machine is on a cable.

**Buy the card from a name brand, like Samsung.** The Pi writes to it all day and cheap cards corrupt.

**On Windows, open [Balena Etcher](https://etcher.balena.io/) with right-click, Run as administrator.** Otherwise the flash can fail with "Error starting flasher sidecar process".

## 1. Download

Download the `.zip` from the newest **SorterOS** release, the top one in [this list on GitHub](https://github.com/basicallysource/sorter-v2/releases?q=SorterOS&expanded=true).

## 2. Flash

In Balena Etcher: **Flash from file**, pick the `.zip`, **Select target**, pick the SD card, **Flash**. Wait until Etcher says the flash is complete.

## 3. Power on

Put the card in the Orange Pi and power it on. Power goes in at the USB-C socket marked `PWR IN`.

**On Ethernet to your router?** The Pi goes online by itself. Skip to step 5.

## 4. Put it on your WiFi from your phone

About half a minute after power on, the Pi starts its own WiFi network, `SorterOS-Setup-` and six characters. For up to a minute after it appears, your phone may say it's unable to join. Wait and try again.

<div class="img-row">
  <figure>
    An iPhone's WiFi settings listing a network called SorterOS-Setup-63F32A among the nearby networks
    <figcaption>In your phone's WiFi settings, join the <code>SorterOS-Setup</code> network. <cite>Screenshot recorded on an iPhone.</cite></figcaption>
  </figure>
  <figure>
    The Sorter's setup page in the phone's sign-in window, listing the WiFi networks the Sorter can see
    <figcaption>A setup page opens. Tap your WiFi network. <cite>Screenshot recorded on an iPhone.</cite></figcaption>
  </figure>
  <figure>
    The setup page asking for the password of the chosen network, with a Join button
    <figcaption>Enter its password and tap <strong>Join</strong>. <cite>Screenshot recorded on an iPhone.</cite></figcaption>
  </figure>
</div>

No setup page? Stay on the `SorterOS-Setup` network and open [http://10.42.0.1](http://10.42.0.1) in Safari or Chrome.

<div class="img-row">
  <figure>
    The setup page saying it is joining the network, and to keep the page open
    <figcaption>The Pi joins while your phone stays on the setup network. <cite>Screenshot recorded on an iPhone.</cite></figcaption>
  </figure>
  <figure>
    The setup page saying the Sorter is on the network, with its address, the next steps and a Done button
    <figcaption>It's on. Note the address and tap <strong>Done</strong>; your phone goes back to your WiFi. <cite>Screenshot recorded on an iPhone.</cite></figcaption>
  </figure>
</div>

## 5. Open the installation progress

On a phone or computer on the same WiFi, open **[http://sorter.local](http://sorter.local)**. It shows the Pi installing SorterOS, which takes a few minutes.

<div class="img-row">
  <figure>
    The installation progress page at sorter.local: Installing the Sorter, and a list of steps, three done and one running
    <figcaption>The installation progress. The page updates itself. <cite>Screenshot recorded in a browser.</cite></figcaption>
  </figure>
</div>

When it's ready, the page opens the SorterOS UI by itself.

## 6. If you fitted the WiFi module

Nothing needs installing for the module itself: the driver is in the official Orange Pi Ubuntu image that SorterOS is built on, so a SorterOS machine picks it up on its own. Third-party OS images may not have the driver at all.

Once the UI is up, the adapter shows under **Settings → WiFi**, which is where the network and password go in. Over SSH, `nmcli device wifi list` lists what it can see.

**Take the adapter's address before you unplug the Ethernet.** Joining a network gets the machine a second address, different from the one it has been answering on, and once connected the adapter's row on that same WiFi page shows what it is. Write it down, then pull the Ethernet and browse to it. Doing it the other way round leaves you hunting for the machine, because the page you were reading goes with the cable.

## 7. Shut it down before you unplug it

**Never cut the power to a running board.** It writes files continuously, and pulling the plug mid-write can corrupt the card you just flashed.

Press the small black button on the side of the Orange Pi once and leave it alone. Shutdown takes about a minute and a half, and it has finished when the red and green LEDs stop blinking. Only then unplug it. The button is a shutdown button, not a power switch: the board starts again the moment it has power, with no press needed.

[Shutting down the machine]({{ '/sorter/safe-shutdown/' | relative_url }}) covers the same from the UI.

## The finished result

The SorterOS UI open in a browser, with nothing set up on the machine yet.

<div class="img-row">
  <figure>
    The SorterOS UI's dashboard the first time it loads: no camera assigned yet, no pieces, and the machine in standby with a Home button
    <figcaption>The SorterOS UI, the first time it loads. <cite>Screenshot recorded in a browser.</cite></figcaption>
  </figure>
</div>

## Next

**Flash the control board before you open the setup wizard.** The wizard only lists boards that already answer on USB serial, so a board with no firmware on it does not appear and the wizard says `No MCU buses found`. [Flashing the control board]({{ '/sorter/' | relative_url }}#flash-the-control-board-before-the-wizard) has the route.

Then set the machine up with the setup wizard: in the SorterOS UI, **Settings**, then **General**, then **Open the setup wizard**. [First setup in the UI]({{ '/sorter/first-setup/' | relative_url }}) goes through it.

## Debugging

- **No `SorterOS-Setup` network.** It only appears while the Pi is offline. On a cable with internet, the Pi is already online: go to step 5.
- **The setup page didn't open.** Open [http://10.42.0.1](http://10.42.0.1) in Safari or Chrome while on the setup network.
- **Your phone left the setup network during the join** (it can on a WiFi that's only 5 GHz). Join it again to see the result.
- **`sorter.local` doesn't open.** Check the address starts with `http://`, not `https://`: the machine doesn't answer on `https`, and some browsers add the `s` by themselves. Use the address the setup page showed. Older Windows needs [Bonjour](https://support.apple.com/en-us/106380), and Android usually can't open `.local` names. A second machine running the SorterOS image is `sorter-2.local`.
- **Office or school WiFi** that asks for a username as well as a password can't be set up this way. Use Ethernet.

More in [troubleshooting]({{ '/sorter/troubleshooting/' | relative_url }}#first-boot).

## Or: put your WiFi in before you flash

[SorterOS Setup](https://setup.basically.website) writes your WiFi into the image, and optionally a hostname, an SSH key and a Tailscale key. It runs in your browser and uploads nothing. Unzip the download, open the `.img` there, and flash the `.img` it saves instead of the `.zip`.

## Later

- **New router or WiFi password.** When the Pi can't reach the internet for about a minute, its setup network comes back. Do step 4 again.
- **Updates.** Settings, then Versions, in the SorterOS UI. You only need a new SorterOS image when the image itself changes.
- **SSH.** User `root`, password `orangepi`.
