basicallysource/sorter-v2/docs/src/content/hardware/electronics/installation/control-board-prep.md

---
layout: default
title: Preparing the control board
type: how-to
section: hardware
slug: electronics-control-board-prep
kicker: Electronics — Preparing the control board
lede: The five stepper drivers, the Pico, the jumpers that address the drivers, and the bypass jumpers on the four LED ports.
permalink: /hardware/electronics/installation/control-board-prep/
author: spencer
contributors: [effreek]
og_image: https://assets.basically.website/sorter-docs/assembly-control-board-prep-all-jumpers-fitted-w1600-f470f24a8913.jpg
tools_needed: ["Soldering iron and solder", "Tweezers or needle-nose pliers"]
parts_needed:
  - part: ctrl-board-basically
    qty: 1
  - part: drv-tmc2209
    qty: 5
  - part: mcu-rpi-pico-presoldered
    qty: 1
  - part: jumper-cap-254
    qty: 10
---

Do this with the board loose, before the [housing]({{ '/hardware/electronics/installation/control-board-housing/' | relative_url }}).

<div class="img-row">
  <figure>
    The bare green basically Embedded Control Board on a wooden bench with five blue-finned TMC2209 stepper driver modules laid out in a row above it
    <figcaption><cite>Photo: Spencer.</cite></figcaption>
  </figure>
</div>

<div class="prep-item">
  <div class="prep-item-body">
    <p><strong>The Pico comes with its two rows of 20 pins already fitted.</strong> That is what the parts list above buys, and step 2 here only pushes it into its sockets. A bare Pico and 40 header pins do the same job if you would rather <a href="{{ '/hardware/helpers/pico-headers/' | relative_url }}">solder them on yourself</a>.</p>
  </div>
  <figure class="prep-item-figure">
    A Raspberry Pi Pico on a white background, seen at an angle from above with the chip and micro USB socket facing up, forty bright solder joints along its long edges and the pins pointing down away from the board
    <figcaption>A Pico with its pins on. <cite>Photo: BrickCycleAlice.</cite></figcaption>
  </figure>
</div>

{% include step.html n="1" title="Seat the five drivers" %}

<div class="callout callout-warning">
  <span class="callout-icon" aria-hidden="true">⚠</span>
  <p>Static caution: the TMC2209 modules and the board are ESD-sensitive. Touch a grounded metal surface before handling them, and avoid doing this on carpet in dry weather.</p>
</div>

Heatsink up, EN/MS1/MS2 edge towards the middle of the board. Module and socket are both silkscreened, so match the labels. A reversed module can be damaged the moment power is applied, so double-check against the photo before moving on.

<div class="img-row">
  <figure>
    A single TMC2209 V1.3 driver module standing on a bench, blue heatsink upwards, with its pin names readable around the edge
    <figcaption><cite>Photo: Spencer.</cite></figcaption>
  </figure>
  <figure>
    A TMC2209 driver pushed fully down into its socket on the control board, heatsink upwards, with the remaining drivers out of focus behind
    <figcaption><cite>Photo: Spencer.</cite></figcaption>
  </figure>
</div>

{% include step.html n="2" title="Seat the Pico" %}

Into the two long sockets down the middle, USB end towards the edge of the board.

<div class="img-row">
  <figure>
    A Raspberry Pi Pico held just above its two long header sockets on the control board, ready to be pushed down, with seated stepper drivers behind it
    <figcaption><cite>Photo: Spencer.</cite></figcaption>
  </figure>
  <figure>
    The Raspberry Pi Pico fully seated in its sockets on the control board, sitting flat and parallel to the board
    <figcaption><cite>Photo: Spencer.</cite></figcaption>
  </figure>
</div>

{% include step.html n="3" title="Set the address jumpers" %}

The five drivers share a UART bus, so each needs its own address. You set it by bridging the MS1 and MS2 header pins: 1-2 bridged reads 3V3 (HIGH); 2-3 bridged reads GND (LOW). MS1 is the low bit of the two-bit address. Two pins allow four addresses, one short of five steppers, so the board runs a second bus for the fifth driver. Ten jumpers in total, two per driver; tweezers or needle-nose pliers make placing the small 2.54 mm (0.1 in) jumper caps much easier.

<div class="img-row">
  <figure>
    Annotated close-up of one driver's MS1 and MS2 headers: MS1 boxed in green with its jumper on pins 1 and 2 for 3V3, MS2 boxed in blue with its jumper on pins 2 and 3 for GND, beside a table mapping the four combinations to addresses 0 to 3
    <figcaption><cite>Photo: Spencer.</cite></figcaption>
  </figure>
</div>

Which driver is which channel is fixed by the board, not by you: each driver socket is wired to its own pins on the Pico, and to the pair of stepper connectors beside it. The board prints the name of each one beside it, `Stepper_A2` to `Stepper_A6`, so set the jumpers by that name.

<table>
  <thead>
    <tr><th>Printed on the board</th><th>Its stepper connectors</th><th>Channel</th><th>Stepper</th><th>Bus</th><th>Address</th><th>MS1</th><th>MS2</th></tr>
  </thead>
  <tbody>
    <tr><td><code>Stepper_A2</code></td><td><code>J23</code> / <code>J24</code></td><td>0</td><td>chute_stepper</td><td>uart0</td><td>0</td><td>GND (2-3)</td><td>GND (2-3)</td></tr>
    <tr><td><code>Stepper_A3</code></td><td><code>J27</code> / <code>J28</code></td><td>1</td><td>c_channel_1_rotor</td><td>uart0</td><td>1</td><td>3V3 (1-2)</td><td>GND (2-3)</td></tr>
    <tr><td><code>Stepper_A4</code></td><td><code>J31</code> / <code>J32</code></td><td>2</td><td>c_channel_3_rotor</td><td>uart0</td><td>2</td><td>GND (2-3)</td><td>3V3 (1-2)</td></tr>
    <tr><td><code>Stepper_A5</code></td><td><code>J35</code> / <code>J36</code></td><td>3</td><td>carousel (C4)</td><td>uart0</td><td>3</td><td>3V3 (1-2)</td><td>3V3 (1-2)</td></tr>
    <tr><td><code>Stepper_A6</code></td><td><code>J39</code> / <code>J40</code></td><td>4</td><td>c_channel_2_rotor</td><td>uart1</td><td>0</td><td>GND (2-3)</td><td>GND (2-3)</td></tr>
  </tbody>
</table>

The two connectors in each pair are the JST-PH socket and the row of 2.54 mm (0.1 in) pins beside it, wired to the same four nets. The `carousel` stepper is the rotor of the classification channel (C4). The machine no longer has a carousel; the firmware and `machine.toml` kept the old name for that driver, so it is still called `carousel` there. Nothing plugs into them yet: the motors go on at [connecting the components]({{ '/hardware/electronics/connecting/' | relative_url }}), step 2.

<div class="callout callout-warning">
  <span class="callout-icon" aria-hidden="true">⚠</span>
  <p>Read the 1 2 3 printed beside every header. The fifth driver's block is mirrored, which is why the board prints <b>!Double check!</b> next to it, and a wrong address fails silently: that driver never answers and its stepper stays unconfigured.</p>
</div>

{% include step.html n="4" title="Bridge the bypass jumpers on the LED ports" %}

The board has four LED ports, and each one feeds +24&nbsp;V through a 180 Ω resistor: `R21` on `J8`, `R22` on `J9`, `R27` on `J10`, `R28` on `J11`. That resistor is there for a bare LED board, which has no current limiting of its own. Nothing this machine plugs into those ports wants it: the [camera lamps]({{ '/hardware/assembly/feeder/camera-lamp/' | relative_url }}) run LED strip, which limits its own current, so the resistor only costs brightness, and brightness is set with PWM in the software instead.

**Bridge all four.** Beside each port is a two-pad solder jumper, printed `Bypass R21`, `Bypass R22`, `Bypass R27` and `Bypass R28`. Melt a blob of solder across both pads of each so they are joined. Nothing is added to the board (Jon, 2026-09-13 and 2026-09-23).

<div class="img-row">
  <figure>
    Annotated close-up of the control board between ports J10 and J11: the solder jumper above R27 is circled in green with a green tick beside it and carries a blob of solder across both pads, and a red arrow points at the jumper above R28, which is two bare pads with a gap between them
    <figcaption>Circled in green, bridged. The one the red arrow points at is not. <cite>Photo: Jon.</cite></figcaption>
  </figure>
</div>

<div class="callout">
  <span class="callout-icon" aria-hidden="true">›</span>
  <p><b>Do it now, while the board is loose.</b> Once it is closed into its housing and wired, the pads are under the lid and behind a dozen cables. Which port takes which lamp is picked on the <a href="{{ '/hardware/electronics/connecting/' | relative_url }}">connecting</a> page.</p>
</div>

## The finished result

This is a correctly jumpered board.

<figure class="single-figure">
  Top-down view of the fully populated control board, with five TMC2209 drivers, the Raspberry Pi Pico, and ten yellow jumpers fitted across the MS1 and MS2 headers
  <figcaption>Five drivers, the Pico, and ten jumpers across the MS1 and MS2 headers. <cite>Photo: Spencer.</cite></figcaption>
</figure>

Next: [the control board housing]({{ '/hardware/electronics/installation/control-board-housing/' | relative_url }}).
