basicallysource/sorter-v2/docs/src/content/hardware/assembly/distribution/bin-frame/bottom-layer.md

---
layout: default
title: Bottom layer
type: how-to
section: hardware
slug: assembly-bottom-layer
kicker: Bin frame — Bottom layer
lede: The layer the machine stands on. A regular layer with foot extensions in place of piece C, and the casters under them.
permalink: /hardware/assembly/distribution/bin-frame/bottom-layer/
author: spencer
contributors: [brickcyclealice, christoph, daddyosbricksbill, dov2000]
og_image: https://assets.basically.website/sorter-docs/assembly-bottom-layer-corner-bracket-on-d-w1600-67bd9444f306.jpg
parts_needed:
  - part: ext-bracket-bottom-vertical
    qty: 6
  - part: ext-bracket-foot-cover
    qty: 6
  - part: ext-2020-d
    qty: 6
  - part: foot-connector-2020-m6
    qty: 6
  - part: caster-wheel-m6
    qty: 6
  - part: scr-m5-16-shcs
    qty: 36
tools_needed: ["Hex key, 3 mm for a button head or 4 mm for a socket head", "Tape measure"]
last_verified: 2026-09-24
---

The bottom layer is an ordinary bin layer that also carries the machine. Its vertical extrusion is one long piece per corner instead of a layer's worth: the caster screws into the bottom of it and the layer above lands on the top of it.

**Build it after a [regular layer]({{ '/hardware/assembly/distribution/bin-frame/regular-layers/' | relative_url }}), not before.** Everything here is a regular layer with three differences at floor level, so that page is the one that describes the layer and this one only covers what changes: piece D in place of piece C, an External bracket — foot cover in place of the cover and the External bracket — bottom vertical at the bottom of the corner, and the feet.

<div class="prep-item">
  <div class="prep-item-body">
    <p><strong>Build a <a href="{{ '/hardware/assembly/distribution/bin-frame/hex-frame/' | relative_url }}">hex frame</a> before you start</strong>, and leave the six External bracket — covers off this one. It is a required component of this page, not covered here.</p>
  </div>
  <figure class="prep-item-figure">
    A finished hex frame from above: six B spokes and their printed crossbeams forming the inner ring inside the aluminum outer hexagon, with a printed corner bracket at each of the six vertices
    <figcaption>A finished hex frame. <cite>Photo: BrickCycleAlice.</cite></figcaption>
  </figure>
</div>

Piece D is 2020 aluminum extrusion, cut to length. The [framing cut list](https://parts-calculator.basically.website/framing) has the exact dimensions.

This layer uses **6 × piece D (Foot extension), 231 mm**, and **no piece C**. Every layer above it takes its own piece C, so an N-layer machine needs 6 × D and 6 × (N−1) × C.

{% include fastener-legend.html %}

{% include step.html n="1" title="Close off the corners at floor level" %}

The bottom layer does not get an External bracket — cover, and it does not get an External bracket — bottom vertical *below* its frame the way every other layer does. It gets an **External bracket — foot cover** instead, one per corner, which is the single printed part that replaces both of them.

**Fit it now, before any extrusion goes in.** It takes 2 {% include fastener.html size="M5" variant="socket-button" length="16" %} screws through its outer holes into the External bracket — side, and it is awkward to fit once piece D is through the corner.

**The screw sitting loose in the middle of the photo below is not one of these two.** It is a collar screw, one of the 2 that clamp the bracket onto the extrusion. It is the same size as the foot cover screws, but it stays loose for now and is tightened in step 2.

<figure class="single-figure">
  Close-up of the foot cover bolted to the External bracket — side, with the two foot-cover screws fitted and, in the middle, a loose collar screw that is tightened in step 2
  <figcaption>The foot cover to External bracket connection, with the extrusion socket open at the top. The loose screw in the middle is a collar screw for step 2. <cite>Photo courtesy of BrickCycleAlice.</cite></figcaption>
</figure>

{% include step.html n="2" title="Run the foot extensions through the corners" %}

<figure class="single-figure">
  One corner of a built machine close up, with the C layer vertical support marked by an arrow between the two frames above and the longer D foot extension marked by an arrow running from the caster up past the bottom frame to the second
  <figcaption>One corner of a standing machine, close up. D runs from the caster, past this layer's corner, up to the layer above; C is the ordinary vertical between the layers further up. <cite>Photo courtesy of Christoph in the basically Discord.</cite></figcaption>
</figure>

The corner itself is the same as on any layer. Only the vertical changes: piece D takes the place of piece C, and it stands proud at the bottom instead of being capped.

On each of the six corners:

<ol class="numbered-steps">
  <li>Partially thread the 2 {% include fastener.html size="M5" variant="socket-button" length="16" %} screws that clamp the collar onto the extrusion, at the holes near the bottom of the External bracket — side, so they are started but not yet tight. This is the loose screw in the step 1 photo, so if you have already started them, leave them as they are.</li>
  <li>Slide a piece D down through the corner, from above, until it stands out below the foot cover.</li>
  <li>Before tightening anything, measure from the bottom of the External bracket — foot cover to the end of piece D. It should stand out <strong>about 54 mm</strong>.</li>
  <li>Tighten the 2 collar screws, bracing against the extrusion.</li>
</ol>

<div class="img-row">
  <figure>
    Piece D held against the bracket with a tape measure alongside, measuring from the bottom before the collar screws are tightened
    <figcaption>Measuring piece D from the bottom before the collar screws are tightened down. <span class="photo-credit">Photo courtesy of BrickCycleAlice.</span></figcaption>
  </figure>
  <figure>
    Driving one of the collar screws home with a hex key once piece D is positioned
    <figcaption>Tightening the collar screw once piece D is positioned. <span class="photo-credit">Photo courtesy of BrickCycleAlice.</span></figcaption>
  </figure>
</div>

Piece D stands about **54 mm** clear of the bottom of the foot cover. The 2020 M6 foot connector bolts into that exposed end.

<figure class="figure-float-right">
  <a href="https://assets.basically.website/sorter-docs/assembly-bottom-two-layers-foot-corner-section-full-6ec3353ee6cf.png" target="_blank" rel="noopener">
    Vertical cross-section through one corner at the bottom of the machine, showing piece D running through the bottom layer's bracket and up into the layer above, the foot cover around it, and the exposed end below
  </a>
  <figcaption>One corner at floor level, cut through the centre of the profile. The bottom layer is blue, the collar of the layer above purple. The numbers match the list below. Click to enlarge. <cite>Drawn from the part geometry rather than from a build, by Balloon.</cite></figcaption>
</figure>

The numbers on the drawing:

<ol class="keyed-list">
  <li><strong>External bracket — side</strong>, the same collar as on any layer, at this layer's frame.</li>
  <li><strong>External bracket — foot cover</strong> in place of the bottom vertical and cover.</li>
  <li><strong>Piece D</strong>, 231 mm cut. It runs from below this layer, through its collar, and up to 3 mm below the flange face of the collar above, so it spans the whole gap to the next layer as well as reaching the floor.</li>
  <li class="key-screw"><strong>Two {% include fastener.html size="M5" variant="socket-button" length="16" %} screws</strong> clamp this layer's collar onto piece D, and two more clamp the External bracket — bottom vertical onto it in step 4. Same screws, same holes as on a regular layer.</li>
  <li class="key-note"><strong>The exposed end of piece D</strong>, which takes the 2020 M6 foot connector and the caster. It stands about 54 mm below the foot cover.</li>
  <li><strong>The collar of the layer above</strong>, sitting on the External bracket — bottom vertical fitted in step 4. From here up, every joint is the ordinary layer joint described on <a href="{{ '/hardware/assembly/distribution/stacking-the-layers/' | relative_url }}">Stacking the layers</a>.</li>
</ol>

{% include step.html n="3" title="Fit the feet" %}

<div class="callout callout-warning">
  <span class="callout-icon" aria-hidden="true">⚠</span>
  <p>Fit all six casters before the machine gets any taller. A bin tower on five feet is not something you want to discover at four layers.</p>
</div>

Bolt a **2020 M6 foot connector** into the open bottom end of each piece D. The connector is an aluminum bracket made for the end of 2020 extrusion and comes with its own bolts and nuts.

Screw a **swivel stem caster (M6 × 15 mm)** into the connector's M6 thread. The casters have brakes; leave them on while you build.

{% include step.html n="4" title="Cap each extrusion with the bottom vertical bracket" %}

This is the step that turns the bottom layer into an ordinary layer as far as everything above it is concerned. Slide an **External bracket — bottom vertical** onto the length of piece D standing above the frame, ensuring its angles align at the bottom, and secure it with 2 {% include fastener.html size="M5" variant="socket-button" length="16" %} screws through its outer holes. It is the same part, fitted the same way, as on a regular layer.

<figure class="single-figure">
  One corner of the bottom layer seen close up from above: the External bracket — bottom vertical standing on the collar with the end of piece D recessed in its square socket, the foot cover below the frame, and the caster under that
  <figcaption>One finished corner, from the collar up to the socket the next layer lands on and down to the caster. The end of piece D sits a few millimetres below the top face of the bracket, which is what it should look like. <cite>Photo: BrickCycleAlice.</cite></figcaption>
</figure>

Matching parts from the same print run are embossed with a shared set code (e.g. **"b2"**) on both the External bracket — side and the External bracket — bottom vertical. Keep marked pairs together so brackets don't get mixed across corners.

## The finished result

One hexagon closed, six casters on, and every corner ending in a bottom vertical bracket ready for the next layer.

<div class="img-placeholder">Image coming: the whole layer on its casters, with nothing yet fitted under the spokes</div>

The [Bin frame]({{ '/hardware/assembly/distribution/bin-frame/' | relative_url }}) page contains the instructions for the entire stack, and is where you should return once you're done here.
