basicallysource/sorter-v2/software/hive/backend/app/routers/machines.py

from datetime import datetime, timezone
from typing import Any
from uuid import UUID, uuid4

from fastapi import APIRouter, Depends, Query, Request
from pydantic import BaseModel, Field
from slowapi import Limiter
from slowapi.util import get_remote_address
from sqlalchemy import delete, select, text, tuple_
from sqlalchemy.dialects.postgresql import insert as pg_insert
from sqlalchemy.dialects.sqlite import insert as sqlite_insert
from sqlalchemy.orm import Session, joinedload

from app.deps import get_current_machine, get_current_user, get_db, require_role, statement_timeout, verify_csrf
from app.errors import APIError
from app.machine_network import normalize_network_block
from app.models.machine import Machine
from app.models.machine_piece import MachinePiece
from app.models.machine_piece_image import MachinePieceImage
from app.models.machine_channel_crop import MachineChannelCrop
from app.models.machine_training_run import MachineTrainingRun
from app.models.user import User
from app.schemas.machine import (
    MachineCreate,
    MachineHeartbeat,
    MachineRegister,
    MachineResponse,
    MachineUpdate,
    MachineWithTokenResponse,
)
from app import background
from app.services import machine_defaults, machine_stats, training_runs
from app.services.auth import generate_machine_token, verify_password
from app.services.machine_set_progress import cached_inventory_index, summarize_machine_set_progress
from app.services.machine_stats import get_machine_stats_worker
from app.services.storage import delete_machine_files, serve_stored_file
from app.services.telemetry_limits import effective_limits

router = APIRouter(prefix="/api", tags=["machines"])
limiter = Limiter(key_func=get_remote_address)


class MachineSetProgressItemPayload(BaseModel):
    category_id: str | None = None
    set_num: str
    name: str | None = None
    part_num: str
    color_id: int | str
    quantity_needed: int = 0
    quantity_found: int = 0


class MachineSetProgressReportPayload(BaseModel):
    version_id: UUID
    artifact_hash: str = Field(min_length=1)
    items: list[MachineSetProgressItemPayload] = Field(default_factory=list)


@router.get("/machines", response_model=list[MachineResponse])
def list_machines(
    scope: str | None = Query(None, pattern="^(mine|all)$"),
    include_archived: bool = Query(False),
    db: Session = Depends(get_db),
    current_user: User = Depends(get_current_user),
):
    query = db.query(Machine).options(joinedload(Machine.owner))
    if scope != "all":
        query = query.filter(Machine.owner_id == current_user.id)
    if not include_archived:
        query = query.filter(Machine.archived_at.is_(None))
    return [machine_response(machine, current_user) for machine in query.all()]


@router.get("/machines/stats")
def get_machine_stats(
    db: Session = Depends(get_db),
    current_user: User = Depends(get_current_user),
):
    """Per-machine statistics for the dashboard cards: the caller's machines'
    rows of machine_stats_cache, which the stats worker keeps (hourly), not a
    count over their samples on every page load."""
    from app.models.machine_stats_cache import MachineStatsCache

    machine_ids = [
        mid for (mid,) in db.query(Machine.id).filter(Machine.owner_id == current_user.id).all()
    ]
    if not machine_ids:
        return {}
    cached = {
        str(row.machine_id): row
        for row in db.query(MachineStatsCache).filter(MachineStatsCache.machine_id.in_(machine_ids))
    }

    result = {}
    for mid in machine_ids:
        row = cached.get(str(mid))
        result[str(mid)] = {
            "total_samples": row.total_samples if row else 0,
            "accepted_samples": row.accepted_samples if row else 0,
            "first_capture": row.first_capture.isoformat() if row and row.first_capture else None,
            "last_capture": row.last_capture.isoformat() if row and row.last_capture else None,
            "total_sessions": row.total_sessions if row else 0,
            "parts_found": row.parts_found if row else 0,
            "parts_needed": row.parts_needed if row else 0,
        }

    return result


@router.get("/admin/machines")
def admin_list_machines(
    db: Session = Depends(get_db),
    admin: User = Depends(require_role("admin")),
):
    """Every machine across ALL owners (admin-only fleet view)."""
    machines = db.query(Machine).options(joinedload(Machine.owner)).order_by(Machine.created_at).all()
    return [
        {
            "id": str(m.id),
            "name": m.name,
            "description": m.description,
            "owner_id": str(m.owner_id),
            "owner_email": m.owner.email if m.owner else None,
            "owner_display_name": m.owner.display_name if m.owner else None,
            "is_active": m.is_active,
            "archived_at": m.archived_at.isoformat() if m.archived_at else None,
            "last_seen_at": m.last_seen_at.isoformat() if m.last_seen_at else None,
            "last_seen_ip": m.last_seen_ip,
            "created_at": m.created_at.isoformat() if m.created_at else None,
        }
        for m in machines
    ]


@router.get("/admin/machines/stats")
def admin_machine_stats(
    db: Session = Depends(get_db),
    admin: User = Depends(require_role("admin")),
):
    """Per-machine lifetime metrics (pieces, PPM, on-time %) across ALL machines.

    Served from the machine_stats_cache table, refreshed hourly by the
    machine-stats worker (see app.services.machine_stats). Cold-start fallback:
    if the cache has never been populated, compute it once here so the first
    admin load isn't blank.
    """
    from app.models.machine_stats_cache import MachineStatsCache

    if db.query(MachineStatsCache.machine_id).first() is None:
        try:
            machine_stats.refresh_cache(db)
        except Exception:
            # A concurrent refresh (e.g. the boot-time worker pass) may have
            # populated the cache between the check and here — just serve
            # whatever is there rather than 500 on the insert race.
            db.rollback()
    return machine_stats.get_fleet_stats(db)


@router.post("/admin/machines/stats/refresh")
def admin_refresh_machine_stats(
    db: Session = Depends(get_db),
    admin: User = Depends(require_role("admin")),
    _csrf: None = Depends(verify_csrf),
):
    """Have the machine-stats worker recompute every machine's cached stats
    now instead of at its next pass. A pass is the fleet-wide aggregates over
    every piece, so it never runs on a request: this returns at once, and the
    numbers change when the pass is done (``worker.last_run_at``)."""
    name = get_machine_stats_worker().name
    background.request_pass(db, name)
    return {"ok": True, "requested": True, "worker": background.worker_status(db, name)}


def _may_view(machine: Machine, user: User) -> bool:
    """A machine's own details are for its owner and admins."""
    return str(machine.owner_id) == str(user.id) or user.role == "admin"


def machine_response(machine: Machine, viewer: User) -> MachineResponse:
    """A machine as ``viewer`` may see it. Where to find it on its network is
    for its owner and admins only, so ``?scope=all`` lists everyone else's
    machines without it."""
    response = MachineResponse.model_validate(machine)
    if _may_view(machine, viewer):
        return response
    return response.model_copy(update={"network_info": None, "network_reported_at": None})


def _machine_for_viewer(db: Session, machine_id: UUID, user: User) -> Machine:
    """Fetch a machine the given user may view (its owner, or any admin).

    Non-owners without the admin role get a 404 rather than a 403 so the
    endpoint doesn't confirm the existence of other users' machines.
    """
    machine = db.query(Machine).options(joinedload(Machine.owner)).filter(Machine.id == machine_id).first()
    if machine is None or not _may_view(machine, user):
        raise APIError(404, "Machine not found", "MACHINE_NOT_FOUND")
    return machine


@router.get("/machines/{machine_id}/overview")
def get_machine_overview(
    machine_id: UUID,
    db: Session = Depends(get_db),
    current_user: User = Depends(get_current_user),
):
    """Dashboard overview for a single machine — metadata + cached stats.

    Accessible to the machine's owner or any admin. Stats come from the
    machine_stats_cache (lazily computed on a miss)."""
    machine = _machine_for_viewer(db, machine_id, current_user)
    stats = machine_stats.get_machine_stats(db, machine.id)
    is_owner = str(machine.owner_id) == str(current_user.id)
    return {
        "machine": {
            "id": str(machine.id),
            "name": machine.name,
            "description": machine.description,
            "is_active": machine.is_active,
            "archived_at": machine.archived_at.isoformat() if machine.archived_at else None,
            "last_seen_at": machine.last_seen_at.isoformat() if machine.last_seen_at else None,
            "network_info": machine.network_info,
            "network_reported_at": machine.network_reported_at.isoformat() if machine.network_reported_at else None,
            "created_at": machine.created_at.isoformat() if machine.created_at else None,
            "token_prefix": machine.token_prefix,
            "hardware_info": machine.hardware_info,
            "owner": {
                "display_name": machine.owner.display_name if machine.owner else None,
                "email": machine.owner.email if machine.owner else None,
            },
        },
        "stats": stats,
        "is_owner": is_owner,
        "viewer_is_admin": current_user.role == "admin",
    }


PIECE_IMAGE_CACHE_CONTROL = "public, max-age=31536000, immutable"

# The most crops one page of a filtered crop list looks at.
CROP_WINDOW = 2000


def _serialize_machine_piece(piece: MachinePiece, images: list[MachinePieceImage]) -> dict[str, Any]:
    return {
        "piece_uuid": piece.piece_uuid,
        "local_id": piece.local_id,
        "run_id": piece.run_id,
        "seen_at": piece.seen_at.isoformat() if piece.seen_at else None,
        "recorded_at": piece.recorded_at.isoformat() if piece.recorded_at else None,
        "classification_status": piece.classification_status,
        "part_id": piece.part_id,
        "part_name": piece.part_name,
        "color_id": piece.color_id,
        "color_name": piece.color_name,
        "category_id": piece.category_id,
        "confidence": piece.confidence,
        "color_confidence": piece.color_confidence,
        "bin": {"x": piece.bin_x, "y": piece.bin_y, "z": piece.bin_z},
        "dead": piece.dead,
        # The operator's verdicts, as the records list carries them.
        "part_correct": piece.part_correct,
        "color_corrected_id": piece.color_corrected_id,
        "correction_updated_at": piece.correction_updated_at.isoformat() if piece.correction_updated_at else None,
        "brickognize_preview_url": piece.brickognize_preview_url,
        "images": [
            {
                "seq": im.seq,
                "source": im.source,
                "channel": im.channel,
                "sharpness": im.sharpness,
                "bytes": im.bytes,
                "used": im.used,
                "excluded_from_result": im.excluded_from_result,
                "score": im.score,
                # image_key is NULL once the crop was evicted from the machine's
                # local store before syncing — the row rides up regardless, so
                # the UI still knows the piece had N crops but can't show them.
                "available": im.image_key is not None,
                "evicted_locally": im.evicted_locally,
            }
            for im in images
        ],
    }


@router.get("/machines/{machine_id}/pieces")
def list_machine_pieces(
    machine_id: UUID,
    limit: int = Query(60, ge=1, le=1000),
    cursor: int | None = Query(None),
    db: Session = Depends(get_db),
    current_user: User = Depends(get_current_user),
):
    """Every synced piece for one machine, newest first — the fleet analogue of
    the on-machine /records page. Keyset-paginated on the machine's local_id.

    Accessible to the machine's owner or any admin."""
    machine = _machine_for_viewer(db, machine_id, current_user)

    query = db.query(MachinePiece).filter(MachinePiece.machine_id == machine_id)
    if cursor is not None:
        query = query.filter(MachinePiece.local_id < cursor)
    pieces = query.order_by(MachinePiece.local_id.desc()).limit(limit + 1).all()

    has_more = len(pieces) > limit
    pieces = pieces[:limit]
    next_cursor = pieces[-1].local_id if (has_more and pieces) else None

    images_by_piece: dict[str, list[MachinePieceImage]] = {}
    piece_uuids = [p.piece_uuid for p in pieces]
    if piece_uuids:
        images = (
            db.query(MachinePieceImage)
            .filter(
                MachinePieceImage.machine_id == machine_id,
                MachinePieceImage.piece_uuid.in_(piece_uuids),
            )
            .order_by(MachinePieceImage.seq.asc())
            .all()
        )
        for im in images:
            images_by_piece.setdefault(im.piece_uuid, []).append(im)

    return {
        "machine": {
            "id": str(machine.id),
            "name": machine.name,
            "owner_email": machine.owner.email if machine.owner else None,
        },
        "items": [
            _serialize_machine_piece(p, images_by_piece.get(p.piece_uuid, []))
            for p in pieces
        ],
        "next_cursor": next_cursor,
        "total": machine_stats.piece_total(db, machine_id),
    }


def _training_run_cursor(run: MachineTrainingRun) -> str:
    started = run.started_at if run.started_at.tzinfo is not None else run.started_at.replace(tzinfo=timezone.utc)
    return f"{started.isoformat()}|{run.id}"


@router.get("/machines/{machine_id}/training-runs")
def list_machine_training_runs(
    machine_id: UUID,
    limit: int = Query(50, ge=1, le=200),
    cursor: str | None = Query(None, max_length=120),
    db: Session = Depends(get_db),
    current_user: User = Depends(get_current_user),
):
    """The machine's training runs, newest first, each with the piece,
    labelled and excluded counts kept on its row (services/training_runs.py).
    Keyset-paged on (started_at, id): pass next_cursor back as cursor.

    Accessible to the machine's owner or any admin."""
    machine = _machine_for_viewer(db, machine_id, current_user)
    query = db.query(MachineTrainingRun).filter(MachineTrainingRun.machine_id == machine.id)
    if cursor:
        try:
            started_raw, run_id_raw = cursor.split("|", 1)
            after = (datetime.fromisoformat(started_raw), UUID(run_id_raw))
        except ValueError as exc:
            raise APIError(400, "Invalid cursor", "CURSOR_INVALID") from exc
        query = query.filter(tuple_(MachineTrainingRun.started_at, MachineTrainingRun.id) < after)
    runs = (
        query.order_by(MachineTrainingRun.started_at.desc(), MachineTrainingRun.id.desc()).limit(limit + 1).all()
    )
    has_more = len(runs) > limit
    runs = runs[:limit]
    colors = training_runs.palette() if runs else {}
    return {
        "items": [training_runs.run_out(run, colors) for run in runs],
        "next_cursor": _training_run_cursor(runs[-1]) if has_more and runs else None,
    }


@router.get("/machines/{machine_id}/pieces/{piece_uuid}/images/{seq}")
def get_machine_piece_image(
    machine_id: UUID,
    piece_uuid: str,
    seq: int,
    db: Session = Depends(get_db),
    current_user: User = Depends(get_current_user),
):
    """Stream one synced crop's bytes from object storage. Cookie-session auth
    (owner or admin) is enough for an <img> tag on a same-origin page."""
    _machine_for_viewer(db, machine_id, current_user)
    image = (
        db.query(MachinePieceImage)
        .filter(
            MachinePieceImage.machine_id == machine_id,
            MachinePieceImage.piece_uuid == piece_uuid,
            MachinePieceImage.seq == seq,
        )
        .first()
    )
    if image is None or not image.image_key:
        raise APIError(404, "Image not found", "IMAGE_NOT_FOUND")

    return serve_stored_file(image.image_key, headers={"Cache-Control": PIECE_IMAGE_CACHE_CONTROL})


def _serialize_channel_crop(crop: MachineChannelCrop) -> dict[str, Any]:
    return {
        "local_id": crop.local_id,
        "channel": crop.channel,
        "ts": crop.ts.isoformat() if crop.ts else None,
        "captured_at": crop.captured_at.isoformat() if crop.captured_at else None,
        "track_id": crop.track_id,
        "com_forward_to_exit_deg": crop.com_forward_to_exit_deg,
        "com_section": crop.com_section,
        "zone_code": crop.zone_code,
        "sharpness": crop.sharpness,
        "bbox": [crop.bbox_x1, crop.bbox_y1, crop.bbox_x2, crop.bbox_y2],
        "bytes": crop.bytes,
        # image_key is NULL once the crop was evicted from the machine's local
        # store before syncing — the row rides up regardless.
        "available": crop.image_key is not None,
        "evicted_locally": crop.evicted_locally,
    }


@router.get("/machines/{machine_id}/channel-crops")
def list_machine_channel_crops(
    machine_id: UUID,
    limit: int = Query(120, ge=1, le=500),
    cursor: int | None = Query(None),
    channel: int | None = Query(None),
    zone_code: int | None = Query(None),
    db: Session = Depends(get_db),
    current_user: User = Depends(get_current_user),
):
    """Unlabeled C2/C3 bbox crops synced from one machine, newest first.
    Keyset-paginated on the machine's local crop id. Optional channel / zone_code
    filters. Accessible to the machine's owner or any admin.

    With a filter a page looks at no more than CROP_WINDOW crops, so a rare
    filter can return a short page, or an empty one, with a next_cursor to go
    on from. ``total`` is the machine's crop count at the stats worker's last
    pass (hourly)."""
    machine = _machine_for_viewer(db, machine_id, current_user)

    query = db.query(MachineChannelCrop).filter(MachineChannelCrop.machine_id == machine_id)
    if cursor is not None:
        query = query.filter(MachineChannelCrop.local_id < cursor)
    end = None
    if channel is not None or zone_code is not None:
        # The last crop of this stretch, from the (machine_id, local_id) index alone.
        end = (
            query.with_entities(MachineChannelCrop.local_id)
            .order_by(MachineChannelCrop.local_id.desc())
            .offset(CROP_WINDOW - 1)
            .limit(1)
            .scalar()
        )
        if end is not None:
            query = query.filter(MachineChannelCrop.local_id >= end)
        if channel is not None:
            query = query.filter(MachineChannelCrop.channel == channel)
        if zone_code is not None:
            query = query.filter(MachineChannelCrop.zone_code == zone_code)
    crops = query.order_by(MachineChannelCrop.local_id.desc()).limit(limit + 1).all()

    if len(crops) > limit:
        crops = crops[:limit]
        next_cursor = crops[-1].local_id
    else:
        next_cursor = end
    total = machine_stats.channel_crop_total(db, machine_id)

    return {
        "machine": {
            "id": str(machine.id),
            "name": machine.name,
            "owner_email": machine.owner.email if machine.owner else None,
        },
        "items": [_serialize_channel_crop(c) for c in crops],
        "next_cursor": next_cursor,
        "total": total,
    }


@router.get("/machines/{machine_id}/channel-crops/{local_id}/image")
def get_machine_channel_crop_image(
    machine_id: UUID,
    local_id: int,
    db: Session = Depends(get_db),
    current_user: User = Depends(get_current_user),
):
    """Stream one synced channel crop's bytes. Cookie-session auth (owner or
    admin) is enough for an <img> tag on a same-origin page."""
    _machine_for_viewer(db, machine_id, current_user)
    crop = (
        db.query(MachineChannelCrop)
        .filter(
            MachineChannelCrop.machine_id == machine_id,
            MachineChannelCrop.local_id == local_id,
        )
        .first()
    )
    if crop is None or not crop.image_key:
        raise APIError(404, "Image not found", "IMAGE_NOT_FOUND")

    return serve_stored_file(crop.image_key, headers={"Cache-Control": PIECE_IMAGE_CACHE_CONTROL})


@router.post("/machines", response_model=MachineWithTokenResponse)
def create_machine(
    data: MachineCreate,
    db: Session = Depends(get_db),
    current_user: User = Depends(get_current_user),
    _csrf: None = Depends(verify_csrf),
):
    raw_token, token_hash, prefix = generate_machine_token()
    machine = Machine(
        owner_id=current_user.id,
        token_hash=token_hash,
        token_prefix=prefix,
        name=data.name,
        description=data.description,
    )
    db.add(machine)
    db.commit()
    db.refresh(machine)

    data_dict = MachineResponse.model_validate(machine).model_dump()
    data_dict["raw_token"] = raw_token
    return MachineWithTokenResponse(**data_dict)


@router.patch("/machines/{machine_id}", response_model=MachineResponse)
def update_machine(
    machine_id: UUID,
    data: MachineUpdate,
    db: Session = Depends(get_db),
    current_user: User = Depends(get_current_user),
    _csrf: None = Depends(verify_csrf),
):
    machine = db.query(Machine).filter(Machine.id == machine_id, Machine.owner_id == current_user.id).first()
    if not machine:
        raise APIError(404, "Machine not found", "MACHINE_NOT_FOUND")

    if data.name is not None:
        machine.name = data.name
    if data.description is not None:
        machine.description = data.description
    db.commit()
    db.refresh(machine)
    return machine


@router.delete("/machines/{machine_id}")
# One DELETE that cascades to every piece, image and crop the machine sent.
@statement_timeout(seconds=60)
def delete_machine(
    machine_id: UUID,
    db: Session = Depends(get_db),
    current_user: User = Depends(get_current_user),
    _csrf: None = Depends(verify_csrf),
):
    machine = db.query(Machine).filter(Machine.id == machine_id, Machine.owner_id == current_user.id).first()
    if not machine:
        raise APIError(404, "Machine not found", "MACHINE_NOT_FOUND")

    delete_machine_files(str(machine.id))
    db.delete(machine)
    db.commit()
    return {"ok": True}


@router.post("/machines/{machine_id}/purge")
# Deletes every upload session, cascading to its samples and reviews.
@statement_timeout(seconds=60)
def purge_machine_data(
    machine_id: UUID,
    db: Session = Depends(get_db),
    current_user: User = Depends(get_current_user),
    _csrf: None = Depends(verify_csrf),
):
    """Delete all upload sessions, samples, reviews, and files for a machine."""
    from app.models.sample import Sample
    from app.models.upload_session import UploadSession

    machine = db.query(Machine).filter(Machine.id == machine_id, Machine.owner_id == current_user.id).first()
    if not machine:
        raise APIError(404, "Machine not found", "MACHINE_NOT_FOUND")

    sessions = db.query(UploadSession).filter(UploadSession.machine_id == machine.id).all()
    session_ids = [s.id for s in sessions]
    count = db.query(Sample).filter(Sample.upload_session_id.in_(session_ids)).count() if session_ids else 0
    for session in sessions:
        db.delete(session)  # cascades to samples and reviews

    delete_machine_files(str(machine.id))
    db.commit()

    return {"ok": True, "deleted_sessions": len(sessions), "deleted_samples": count}


@router.post("/machines/{machine_id}/rotate-token", response_model=MachineWithTokenResponse)
def rotate_token(
    machine_id: UUID,
    db: Session = Depends(get_db),
    current_user: User = Depends(get_current_user),
    _csrf: None = Depends(verify_csrf),
):
    machine = db.query(Machine).filter(Machine.id == machine_id, Machine.owner_id == current_user.id).first()
    if not machine:
        raise APIError(404, "Machine not found", "MACHINE_NOT_FOUND")

    raw_token, token_hash, prefix = generate_machine_token()
    machine.token_hash = token_hash
    machine.token_prefix = prefix
    db.commit()
    db.refresh(machine)

    data_dict = MachineResponse.model_validate(machine).model_dump()
    data_dict["raw_token"] = raw_token
    return MachineWithTokenResponse(**data_dict)


@router.post("/machine/heartbeat")
def heartbeat(
    request: Request,
    data: MachineHeartbeat | None = None,
    db: Session = Depends(get_db),
    machine: Machine = Depends(get_current_machine),
):
    now = datetime.now(timezone.utc)
    machine.last_seen_at = now
    # Where the request came from as Hive sees it: usually the public side of
    # the Sorter's router, so it is recorded but never linked to.
    client_ip = request.headers.get("x-forwarded-for", "").split(",")[0].strip() or (request.client.host if request.client else None)
    if client_ip:
        machine.last_seen_ip = client_ip
    if data is not None:
        if "hardware_info" in data.model_fields_set:
            if isinstance(data.hardware_info, dict) and data.hardware_info.get("schema_version") is not None:
                # A machine-specs snapshot: summarize for the dashboard + append
                # the full snapshot to the spec history.
                from app.machine_hardware import record_hardware_report

                record_hardware_report(db, machine, data.hardware_info)
            else:
                machine.hardware_info = data.hardware_info
        if "network" in data.model_fields_set:
            if data.network is None:
                # The Sorter's owner turned the field off: forget the addresses.
                machine.network_info = None
                machine.network_reported_at = None
            else:
                network = normalize_network_block(data.network)
                if network is not None:
                    machine.network_info = network
                    machine.network_reported_at = now
    db.commit()
    # The limits ride on the heartbeat so Hive can change them without a
    # release, and the defaults' version so a machine fetches the block when it
    # changes (services/machine_defaults.py); a machine that predates either
    # ignores the key.
    return {
        "ok": True,
        "machine_id": str(machine.id),
        "limits": effective_limits(db, machine),
        "defaults_version": machine_defaults.current(db)["version"],
    }


@router.post("/machine/register", response_model=MachineWithTokenResponse)
@limiter.limit("5/minute")
def register_machine(
    request: Request,
    data: MachineRegister,
    db: Session = Depends(get_db),
):
    """Self-registration endpoint for machines.

    Authenticates with user credentials and creates a new machine,
    returning the API token in one step. No cookies/CSRF needed.
    """
    user = db.query(User).filter(User.email == data.email).first()
    if not user or not verify_password(data.password, user.password_hash):
        raise APIError(401, "Invalid email or password", "INVALID_CREDENTIALS")
    if not user.is_active:
        raise APIError(403, "Account is inactive", "ACCOUNT_INACTIVE")

    raw_token, token_hash, prefix = generate_machine_token()
    machine = Machine(
        owner_id=user.id,
        token_hash=token_hash,
        token_prefix=prefix,
        name=data.machine_name,
        description=data.machine_description,
    )
    db.add(machine)
    db.commit()
    db.refresh(machine)

    data_dict = MachineResponse.model_validate(machine).model_dump()
    data_dict["raw_token"] = raw_token
    return MachineWithTokenResponse(**data_dict)


@router.get("/machines/{machine_id}/set-progress")
def get_machine_set_progress(
    machine_id: UUID,
    db: Session = Depends(get_db),
    current_user: User = Depends(get_current_user),
):
    """Get set-based sorting progress for a machine."""
    from app.models.machine_set_progress import MachineSetProgress
    from app.models.machine_profile_assignment import MachineProfileAssignment

    machine = db.query(Machine).filter(Machine.id == machine_id, Machine.owner_id == current_user.id).first()
    if not machine:
        raise APIError(404, "Machine not found", "MACHINE_NOT_FOUND")

    assignment = db.query(MachineProfileAssignment).filter(
        MachineProfileAssignment.machine_id == machine_id
    ).first()
    if not assignment:
        return {"progress": [], "assignment_id": None}

    version = assignment.active_version or assignment.desired_version
    rows = db.query(MachineSetProgress).filter(
        MachineSetProgress.assignment_id == assignment.id
    ).all()

    summary = summarize_machine_set_progress(
        version.compiled_artifact_json if version is not None else {},
        rows,
    )
    progress = [
        {
            "set_num": item["set_num"],
            "set_name": item["set_name"],
            "part_num": item["part_num"],
            "color_id": item["color_id"],
            "quantity_needed": item["quantity_needed"],
            "quantity_found": item["quantity_found"],
            "updated_at": item["updated_at"].isoformat() if item["updated_at"] else None,
        }
        for item in summary["progress"]
    ]

    return {"progress": progress, "assignment_id": str(assignment.id)}


@router.post("/machine/set-progress")
def report_machine_set_progress(
    payload: MachineSetProgressReportPayload,
    db: Session = Depends(get_db),
    machine: Machine = Depends(get_current_machine),
):
    """Machine reports its set progress snapshot. Authenticated via machine token.

    Machines report the whole snapshot every few seconds and it rarely
    changes, so a report stays cheap: the artifact's inventory is indexed once
    per compiled version (cached_inventory_index), the version is read without
    its artifact, and only the rows whose numbers changed are written."""
    from app.models.machine_set_progress import MachineSetProgress
    from app.models.machine_profile_assignment import MachineProfileAssignment
    from app.models.sorting_profile_version import SortingProfileVersion

    assignment = db.query(MachineProfileAssignment).filter(
        MachineProfileAssignment.machine_id == machine.id
    ).first()
    if not assignment:
        raise APIError(404, "No profile assignment found", "NO_ASSIGNMENT")

    # One report per assignment at a time. Without this, a retry of a
    # still-running report joins the row-lock queue behind it — waiting up to
    # the 60s statement timeout while holding its own locks and pinning its
    # whole parsed payload — and under a retry storm those waiters convoy
    # (2026-08-20, the second half of the OOM loop: the convoy persisted even
    # after the write path itself got fast). The advisory lock is
    # transaction-scoped, so it releases on commit or rollback no matter how
    # the request dies; a bounced retry just comes back once the in-flight
    # report lands, and then usually no-ops. Postgres-only: sqlite (tests) is
    # single-writer anyway.
    if db.bind.dialect.name == "postgresql":
        got_lock = db.execute(
            text("SELECT pg_try_advisory_xact_lock(hashtext(:aid))"),
            {"aid": str(assignment.id)},
        ).scalar()
        if not got_lock:
            raise APIError(
                429,
                "A set-progress report for this machine is already being processed",
                "SET_PROGRESS_BUSY",
            )

    # The version's id and hash only: its artifact is read on a cache miss.
    expected_version_id = None
    compiled_hash = ""
    for version_id in (assignment.active_version_id, assignment.desired_version_id):
        if version_id is None:
            continue
        found = db.query(SortingProfileVersion.compiled_hash).filter(SortingProfileVersion.id == version_id).first()
        if found is not None:
            expected_version_id, compiled_hash = version_id, found.compiled_hash or ""
            break
    if expected_version_id is None:
        raise APIError(409, "Machine assignment has no active profile version", "SET_PROGRESS_VERSION_UNAVAILABLE")
    if payload.version_id != expected_version_id:
        raise APIError(409, "Reported progress does not match the active assignment version", "SET_PROGRESS_VERSION_MISMATCH")

    expected_artifact_hash = str(assignment.artifact_hash or compiled_hash or "")
    if not expected_artifact_hash:
        raise APIError(409, "Machine assignment has no compiled artifact hash", "SET_PROGRESS_ARTIFACT_UNAVAILABLE")
    if payload.artifact_hash != expected_artifact_hash:
        raise APIError(409, "Reported progress does not match the active assignment artifact", "SET_PROGRESS_ARTIFACT_MISMATCH")

    valid_progress_items = cached_inventory_index(
        expected_version_id,
        compiled_hash,
        lambda: db.query(SortingProfileVersion.compiled_artifact_json)
        .filter(SortingProfileVersion.id == expected_version_id)
        .scalar(),
    )
    expected_keys = set(valid_progress_items.keys())
    if not valid_progress_items and payload.items:
        raise APIError(400, "Non-set profiles must report an empty progress snapshot", "SET_PROGRESS_NOT_SET_BASED")

    now = datetime.now(timezone.utc)
    normalized_by_key: dict[tuple[str, str, int], dict[str, Any]] = {}
    for item in payload.items:
        try:
            color_id = int(item.color_id)
        except (TypeError, ValueError):
            raise APIError(400, f"Invalid color_id '{item.color_id}'", "SET_PROGRESS_COLOR_INVALID")

        set_num = item.set_num.strip()
        part_num = item.part_num.strip()
        if not set_num or not part_num:
            raise APIError(400, "set_num and part_num are required", "SET_PROGRESS_ITEM_INVALID")

        key = (set_num, part_num, color_id)
        expected_item = valid_progress_items.get(key)
        if expected_item is None:
            raise APIError(
                400,
                f"Progress item {set_num}/{part_num}/{color_id} is not part of the assigned artifact",
                "SET_PROGRESS_ITEM_UNKNOWN",
            )

        try:
            quantity_found = max(0, int(item.quantity_found))
        except (TypeError, ValueError):
            raise APIError(400, f"Invalid quantity_found '{item.quantity_found}'", "SET_PROGRESS_QUANTITY_INVALID")

        normalized = normalized_by_key.setdefault(
            key,
            {
                "set_num": set_num,
                "part_num": part_num,
                "color_id": color_id,
                "quantity_needed": int(expected_item["quantity_needed"]),
                "quantity_found": 0,
            },
        )
        normalized["quantity_found"] = min(
            normalized["quantity_needed"],
            normalized["quantity_found"] + quantity_found,
        )

    incoming_keys = set(normalized_by_key.keys())
    if expected_keys != incoming_keys:
        missing_count = len(expected_keys - incoming_keys)
        extra_count = len(incoming_keys - expected_keys)
        raise APIError(
            400,
            f"Progress snapshot is incomplete for the assigned artifact (missing={missing_count}, extra={extra_count})",
            "SET_PROGRESS_SNAPSHOT_INCOMPLETE",
        )

    normalized_items = list(normalized_by_key.values())

    # Set-based write. The previous path loaded every row as an ORM object,
    # mutated all of them (touching updated_at even when nothing changed) and
    # flushed an 8.5k-parameter executemany — slower than the sorter's 15s
    # client timeout, and under contention slower than the 60s statement
    # timeout. Every retry then queued behind the previous attempt's row locks,
    # and the pile of abandoned threadpool workers (each pinning its parsed
    # payload, ORM session and artifact index) is what OOM-cycled hive-prod on
    # 2026-08-20. Only the rows whose numbers changed are sent: the steady
    # state (a machine re-reporting a mostly identical snapshot) builds and
    # sends no upsert at all, where compiling 8.5k rows of one took seconds.
    progress = MachineSetProgress.__table__
    existing = {
        (row.set_num, row.part_num, row.color_id): (row.quantity_needed, row.quantity_found)
        for row in db.execute(
            select(
                progress.c.set_num, progress.c.part_num, progress.c.color_id,
                progress.c.quantity_needed, progress.c.quantity_found,
            ).where(progress.c.assignment_id == assignment.id)
        )
    }
    existing_keys = set(existing)

    deleted = 0
    stale_keys = existing_keys - incoming_keys  # non-empty only right after the profile changed
    if stale_keys:
        deleted = db.execute(
            delete(progress).where(
                progress.c.assignment_id == assignment.id,
                tuple_(progress.c.set_num, progress.c.part_num, progress.c.color_id).in_(stale_keys),
            )
        ).rowcount

    changed = [
        item
        for key, item in normalized_by_key.items()
        if existing.get(key) != (item["quantity_needed"], item["quantity_found"])
    ]

    # Chunked: a first snapshot is ~8.5k rows x 9 columns, past both
    # postgres's and sqlite's bind-parameter caps in one statement.
    insert_fn = pg_insert if db.bind.dialect.name == "postgresql" else sqlite_insert
    for start in range(0, len(changed), 1000):
        chunk = changed[start : start + 1000]
        stmt = insert_fn(progress).values(
            [
                {
                    "id": uuid4(),
                    "machine_id": machine.id,
                    "assignment_id": assignment.id,
                    "set_num": item["set_num"],
                    "part_num": item["part_num"],
                    "color_id": item["color_id"],
                    "quantity_needed": item["quantity_needed"],
                    "quantity_found": item["quantity_found"],
                    "updated_at": now,
                }
                for item in chunk
            ]
        )
        stmt = stmt.on_conflict_do_update(
            index_elements=["assignment_id", "set_num", "part_num", "color_id"],
            set_={
                "quantity_needed": stmt.excluded.quantity_needed,
                "quantity_found": stmt.excluded.quantity_found,
                "updated_at": stmt.excluded.updated_at,
            },
            where=(
                (progress.c.quantity_needed != stmt.excluded.quantity_needed)
                | (progress.c.quantity_found != stmt.excluded.quantity_found)
            ),
        )
        db.execute(stmt)

    db.commit()
    return {"ok": True, "updated": len(normalized_items), "changed": len(changed), "deleted": deleted}

@router.post("/machines/{machine_id}/archive", response_model=MachineResponse)
def archive_machine(
    machine_id: UUID,
    db: Session = Depends(get_db),
    admin: User = Depends(require_role("admin")),
    _csrf: None = Depends(verify_csrf),
):
    """Hide a machine + its samples from default listings/stats/training pulls.

    Reversible via the matching DELETE endpoint. Sample rows stay intact; the
    archive flag just filters them out wherever the UI/training treat the
    sample roster as 'active fleet'.
    """
    machine = db.query(Machine).filter(Machine.id == machine_id).first()
    if not machine:
        raise APIError(404, "Machine not found", "MACHINE_NOT_FOUND")
    if machine.archived_at is None:
        machine.archived_at = datetime.now(timezone.utc)
        db.commit()
        db.refresh(machine)
    return machine


@router.delete("/machines/{machine_id}/archive", response_model=MachineResponse)
def unarchive_machine(
    machine_id: UUID,
    db: Session = Depends(get_db),
    admin: User = Depends(require_role("admin")),
    _csrf: None = Depends(verify_csrf),
):
    machine = db.query(Machine).filter(Machine.id == machine_id).first()
    if not machine:
        raise APIError(404, "Machine not found", "MACHINE_NOT_FOUND")
    if machine.archived_at is not None:
        machine.archived_at = None
        db.commit()
        db.refresh(machine)
    return machine
