basicallysource/sorter-v2/(commit log)

2026-10-03 harness: all three LED drops end on a strip, no COB boards
    L1p and L2p were still drawn ending on COB1 and COB2. The COB plates are
    retired and every lamp takes a clamp-on LED strip, so the drawing now has
    STRIP1 to STRIP3.
2026-10-03 harness: CH is the tail wire only, 300 mm, motor leads not included
    The cut length is what a vendor or builder needs. The motor's own 300 to
    500 mm leads vary by batch, so the overall length (about 600 mm) goes in the
    notes instead of the length field.
2026-10-03 rfq: cover sheet carries the cable schedule, lengths, ends and datasheet source from the order page
2026-10-03 chute-stepper drawing: CH is ordered with the motor end bare and tinned
2026-10-03 docs: wire harness page is how the machine is wired, schedule moves to the order page
    Keeps the PSU, the interconnect diagram and the stepper pinout. Drops the wire schedule, parts list, connector table, open items and the working-notes banner, which duplicated the order page and had drifted from it. States on the page that cables can be built, bought or ordered.
2026-10-03 docs: wire harness page, Mira's findings
    Larger diagram text with a halo on cable labels, CH label corrected, section 1 metric first and trimmed, evidence lines and the duplicate coil check out of 2.1, bulleted lists that render.
2026-10-03 docs: wire harness diagram, cable labels larger and clear of their lines
2026-10-03 docs: wire harness page previews as the interconnect diagram
2026-10-03 docs: LED strip helper page says strips, and opens with three per machine
2026-10-03 docs: LED strip page says reversed polarity only leaves the light off
2026-10-03 docs: LED strip page shows the two cable diagrams 50% wider
2026-10-03 docs: LED strip page cable diagrams up to 800 px wide
2026-10-04 Versions: a stable machine can switch to canary
    Stable v0.3.0 offers only stable releases, so a machine on it can never try
    canary. The Versions page lists both channels again and the update installs a
    stable or canary release; never a branch.
    A machine never moves to a release older than what it runs: by version, or a
    commit its code already contains. Newer code can change the machine in ways
    older code can't run on (main serves the UI from the supervisor and removes the
    Vite unit v0.3 needs), so a machine that went to canary comes back to stable
    once stable catches up. The page says so on the canary row, and says why on a
    row it can't switch to.
    After a switch the page waits for the mach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
2026-10-04 docs(feeder): list the optional stand-pinning screws and T-nuts on Arranging C-channels
2026-10-04 catalog: C-channel stands carry their optional pins, uncounted
    The stands are designed screwless. Each support structure gains optional
    lines for the M5 x 16 screws (and T-nuts for C1's extrusion legs) and draft
    joints for them. A line marked optional resolves to quantity 0, so no total,
    order list or bundle counts it.
2026-10-04 docs: recommend hook-and-loop straps over zip ties for cable securing
2026-10-04 docs: straps for the stepper motor leads and the other cables that get anchored
2026-10-06 docs(orange pi prep): WiFi module screw goes in from the top face, with photos for it and the heatsink fan
2026-10-06 docs(orange pi prep): the screw, washer and nut come with the board, two sets
2026-10-06 docs(orange pi prep): WiFi module named before the heatsink fan, and why the fan is off in the screw photo
2026-10-06 docs(orange pi prep): antennas come connected, so the step folds into step 1; peel both films off the thermal pad
2026-10-06 docs(sorter): running without the chute and layers
    The --disable switches (chute, servos, channels, carousel) were
    documented nowhere. Explains them, where to set them, and that Home
    still homes the chute.
2026-10-07 electronics: show the S1 (RESET button) reference on the distribution board silkscreen
    The reference was hidden, so BOM line S1 had no matching marking on the
    board and PCB assembly flagged it. Unhide it and move it clear of the
    RESET label, which it overlapped.
2026-10-08 Incidents: remove Feeder jam and Chute jammed; reset to default on every row
    Feeder jam is gone with everything behind it: the stuck-piece watch on C2
    and C3, its nudges and shakes, and its three "Stuck pieces" tuning fields.
    The feeder now just pulses. Chute jammed (the chute or a door taking longer
    than three times its estimated move) is gone too; a chute that really stalls
    is still caught by StallGuard, as Motor stalled.
    Settings > Incidents rows are SettingRows now, like every other setting: a
    row not on its default takes the tint and a "Reset to Automatic" button, and
    pointing at that button says what the default does. SettingRow gains that
    tooltip for every reset button ("Default: 6 /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
2026-10-08 docs: find a stepper's coils by joining two wires and turning the shaft
2026-10-09 docs(printing): warn that STL orientation is not final yet, link #855
2026-10-09 docs(printing): fold the orientation warning into the orientation section
2026-10-09 docs(printing): drop the date from the orientation warning
2026-10-09 docs(printing): drop the issue reference from the orientation section
2026-10-09 Camera feeds: one stream per camera; the page draws zones, boxes and crop
    The settings page drew a zone twice: the zone editor on its canvas, and
    perception again, baked into the video. After a save the editor showed the
    new zone at once while the video kept the old one until perception rebuilt
    the channel and inferred again, so the old zone sat under the new one.
    The video is now only pixels. Each camera role is one stream, encoded once
    for every page: the frames perception inferred on, or the camera's own while
    perception has none or is a second behind. What is drawn over it comes beside
    it as data on the same socket: a layout note (the zones perception worked
    with, as shapes, and the das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
2026-10-09 CameraPicture: a draw puts the canvas state back, so the crop's clip never carries over
    Without it the clip stayed on the context: the next frame's clear and
    backdrop were clipped to it, and its anti-aliased edge piled up into a
    dark line around the cropped channel.
2026-10-09 Sorter UI: the cached profile follows the machine's active profile
    Piece cards and bins look category names up in profile metadata the page
    fetched once. When the profile was switched anywhere but that tab (another
    tab, the API, a Hive sync), the page kept the old profile's categories and
    the cards lost their category names until a reload.
    The machine already reports its active profile over the socket. The page now
    refetches the metadata when that profile's identity changes, and a slow
    answer for the old profile can no longer land on top of the new one.
2026-10-09 Feeder: a piece its channel cannot move gets the channel next to it turned
    A piece rides its rotor, so when C2 or C3 has turned 45 degrees under a piece
    that has not moved, it rests on something else: in the channel's landing area
    it still hangs off the channel above, at its exit it hangs onto the channel
    below. The feeder turns that other channel a little (8 degrees, 3 for C1) and
    watches again. A held piece blocks the channel above by itself, since a channel
    only drops into a clear landing area, so this is the one move that frees it and
    the one the feeder never made.
    C3 is turned only while it has no piece at its own edge, so its next piece
    never drops on the classification channel out of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
2026-10-09 Cycle time: waits with nothing in view say why, and held pieces are listed
    A wait with no piece seen on C3 is now one of three: a piece only out of the
    camera's view on C3 (the feeder's unseen arc expects one), none on C3 but some
    on C2, or none on C3 or C2 (the hopper running low, or C1). The page's pieces
    a minute says what it would have been while the hopper kept up.
    Every piece C2 or C3 could not move is kept (held_pieces): where it sat, how
    long, how many turns of the next channel it took, whether the operator was
    called, and how it ended. The page lists them.
2026-10-09 Feeder runs while the chute moves; the chute aims 0.8 s sooner after a drop
    Since February the feeder stood still whenever the chute moved, from a time
    when stepper commands could collide. Nothing the feeder does puts a piece in
    the chute, and the classification channel ejects only once the chute is aimed,
    so the feeder now keeps going: on one machine it had stood still for 10% of
    the time the classification channel waited for its next piece.
    After a piece drops, distribution waited the 1.5 s chute settle plus a 0.8 s
    cooldown before the chute could aim for the next piece. A piece clears the
    chute in about 0.4-0.6 s, so the cooldown is now 0 and the chute is free 1.5 s
    after the drop.
    Co-A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
2026-10-09 Tracker: one piece boxed two ways keeps one id
    The detector can box one piece two ways from frame to frame. An antenna base
    with its lever was boxed whole (85 x 216 px) in one frame and as only the base
    (80 x 76 px, inside the first box) in the next; the size and colour difference
    refused the match, so the base-only box became a second piece. The two ids were
    never in the same frame, so the double-feed rule never fired: both were
    photographed and classified (the whole part and the base alone), the base-only
    one was staged and placed, and when its id vanished it was withdrawn and
    reaped as a dead record.
    Now a box left unmatched in a frame is the track whose last box it sits inside
    (or aroun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
2026-10-09 Control data: each piece's tracker colour, and the boxes behind a merged piece
    The classification channel merges detector boxes that overlap or nearly touch
    into one piece before tracking, so one object drawn in parts (an assembly, a
    two-colour brick) and two pieces touching both become one piece. The boxes
    behind each merged piece were only drawn on the camera feed; the state record
    now keeps them ("merged": [[merged box, [box, ...]], ...]), so the two cases
    can be told apart later from how their parts arrived and moved.
    Each piece in a state record also carries the colour descriptor the tracker
    measured for it (a ninth element), so a replay of the log matches pieces the
    way the tracker di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
2026-10-09 Tracker: no piece moves forward faster than the platter carries it
    During a turn a one-frame false box on the platter (grey, the platter's own
    colour) appeared 170 degrees ahead of a classified piece that was still in view
    30 degrees on. Matching the piece to the false box and starting a new id for
    the piece's real box was the cheaper alignment (new ids cost half in the drop
    zone), so the piece lost its id and its classification and went out as a
    stray, and its record was reaped as dead.
    Pieces on the classification channel move at most ~300 deg/s between frames
    (99.9th percentile over 113,000 steps); every faster step in the logs was an id
    taken this way, about five an hour. A detection fu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
2026-10-10 catalog: buy one micro USB cable, not a multipack; add Amazon DE
    The machine needs a single USB-A to micro USB cable. Replace the 3-pack (US)
    and 2-pack (FR) listings with single-cable ones, add Amazon DE, and use a
    product photo that shows one cable.
2026-10-10 docs: recommend labelling every cable at both ends, with a printable label sheet
2026-10-10 docs: US Letter label PDF and Brother P-touch flag files for the cable labels
2026-10-10 docs: fold line on the cable labels, one wire-pair flag file sized for 18 AWG
2026-10-10 docs: cable label PDFs get one page per cable type, with strips sized to the cable
2026-10-10 docs: cable label PDFs flow across pages, one row per strip length
2026-10-10 docs: cable label PDFs get a legend, an illustration of a label on a cable, and inch units on the scale bar
2026-10-10 docs: add a 3 in mark to the scale bar on the cable label PDFs
2026-10-10 docs: tape the printed label sheet before cutting, and give the strip height as 0.47 in
2026-10-10 docs: rewrite the cable labelling steps for the reader, link regenerated label files with equal text margins
2026-10-10 docs: one stepper-leads variant for the cable labels, regenerated files
2026-10-10 docs: the chute stepper cable is fixed to the motor, so CH gets one label; regenerated PDFs
2026-10-10 docs: Brother flag files hold both flags of every cable and fit the printer's length limit
2026-10-10 docs: give the three camera USB leads IDs U3 to U5 and labels
2026-10-10 docs: show the printed cable labels as a prepared component to have ready before connecting
2026-10-10 docs: say the camera USB leads are detachable and separate from the lamp cable
2026-10-10 docs: put the cable labels item right after the LED strips, before the PSU pigtails sentence
2026-10-10 docs: rename cable IDs to a three-letter prefix and a number (PWR, STP, LED, USB, CHU, PSU, LIM)
    Across the docs, the catalog, the wire harness sources and the cable label sheets and flag files.
2026-10-10 docs: point the harness page at the renders with the new cable IDs
2026-10-10 Make the LED pigtail IDs LED1p to LED3p in the harness source, and name the USB leads in the catalog
2026-10-10 docs: point the harness page at the LED drawing with lowercase p pigtail IDs
2026-10-10 docs: label every detachable cable at both ends in the vendor spec, rename connector designators to the new cable IDs
2026-10-10 docs: point the harness page at the renders with the new connector names
2026-10-10 docs: sub-harness drawing sources with the new cable IDs, and PWR1, PWR3 and interconnect pictures re-lettered
2026-10-10 docs: point the harness page at the sub-harness renders with the new cable IDs
2026-10-10 docs, catalog, harness: LED1 to LED3 is the lead on the strip, LED1a to LED3a the optional board lead
2026-10-10 docs: harness drawing links for the LED renames
2026-10-10 docs: nav and links use the LED strip helper page's own title
2026-10-10 Leave the harness sources and drawings to #832
    The wire harness YAML, rfq.txt, AGENTS.md and the drawing links are renamed
    there, so this PR is docs, catalog and labels only.
2026-10-10 docs: add Design pages for the sorter, printed parts, Orange Pi, USB and power; DIAG pin, Pico pin diagram and board schematic link
2026-10-10 docs: note which screws and hardware are used, and that source links are for digging deeper
2026-10-10 docs: shorten the Orange Pi design page, move power and USB to their own pages, keep the optional note on the overview only
2026-10-11 docs: add Pico, motors and servos pages to the Lab, move the shared text to one place, Research areas first
2026-10-11 docs: render the board names as code in the servo page lists
2026-10-11 docs: images for the variants, internet note on the Orange Pi page, tested status for the C1 legs and Orange Pi base
2026-10-11 docs: say why the Orange Pi base without inserts exists, make the two-builder test explicit
2026-10-11 docs: lab pages use the channel-numbered cable IDs
2026-10-11 docs: lab pages use the new cable IDs (LED2 to LED4, USB5 and USB6, USB2 to USB6)
2026-10-11 docs: cut repeated text on the design pages and add the recorded reasons for design decisions
2026-10-11 docs: give the reason for the 160 mm layer height
    A bin is 80 mm high, tilted 30 degrees, which spans 160 mm. The 30 degrees is the chute angle, set in January 2026 after the 13 degree chute stuck pieces.
2026-10-11 docs(control-board-prep): say the carousel stepper is C4
2026-10-11 docs(control-board-prep): stack the jumper table on phones, add C1 to C3 to the stepper names
2026-10-11 docs: make the wide tables on connecting, wire-harness and chute-stepper-lead fit a phone
2026-10-11 docs(lab motors): the sourced reason for the NEMA 23 chute, and what is still undocumented
2026-10-11 docs(lab motors): where the three-second chute turn comes from
2026-10-11 docs(lab): an Abandoned ideas page under Variants
    Fifteen dropped designs (the carousel and identification chamber, imaging from several channels, embeddings, the turntable, vibrating and step feeders, light posts, older stands and mounts, the linear layout, Firmata and others), each with what it was and why it went.
2026-10-12 docs(lab motors): the buyer's reason for the 2.4 Nm chute motor
2026-10-12 catalog: the inverted chute STLs (18 parts to v2: chute core, door, bearing mounts and retainers, servo parts, funnel slides, layer connectors, funnels)
    The bearing race is held back: gen3_bearing_connector is exported with no
    face on the bed and will not slice.
2026-10-12 catalog: use the print-oriented inverted chute STLs, support on the core and funnels, bearing race included
2026-10-12 catalog: close the bearing-holder merge change, the new holders are a handed pair
2026-10-12 catalog: drop the build plate with the old chute core and funnel slides
2026-10-12 catalog: the chute-without-core build plate, with the id stamps on every part
2026-10-12 catalog: heat insert counts for the inverted chute (core 21, holders 5 each, race none)
2026-10-12 catalog: the servo adapter's servo side takes 4 short M3S inserts again
2026-10-12 docs(chute): the servo adapter's servo side takes 4 short M3S inserts; the funnel pockets are unused
2026-10-12 docs(funnel): the bracket screw is an M3x12 countersunk, and the funnel is held by the brackets' spring force
2026-10-12 catalog: the inverted chute's inserts and screws, stamp chute v3
    The core carries 21 inserts, the bearing holders 5 each and the race none, the race bolts to the core with 2 M3x16, and the servo bracket arms take 3 screws into the core.
2026-10-12 docs(chute): layer connectors turned the right way round, flat countersunk face out
2026-10-12 docs(chute): re-render every picture at full size, the chute core in scale
    The exploded views of the funnel brackets and layer connectors and the two-layer view made the core small in the frame. They now show the core with its inserts ringed, and the joint zoomed in.
2026-10-12 docs(chute): the core page ends at the core with its inserts; the component pages start from the prepared core
2026-10-12 docs(chute): zed0's four-chute CAD view is the result and preview image of the chute page
2026-10-12 docs(chute): Mira pass: self-contained wall names, no letters or reasons she does not need, race and servo orientation
2026-10-12 docs(chute): flap assembly goes in along the slope, connector check, cover names; pictures re-posed with the door against its stop
2026-10-12 docs(chute): board header towards the servo side, servo wires out of the housing's open end
2026-10-12 Rank the colors a piece is likely to be, on Hive and the sorter
    One ranker (color_rank.py, the same file in both backends): closeness to
    the predicted colors (CIELAB distance plus a hue term between chromatic
    colors and a finish term) times how likely the part exists in each color
    (the square root of its share of BrickLink pieces for sale, floored so a
    color with no sales is never zero). Every color comes back with its stats.
    Hive serves it to people (GET /api/labeling/likely-colors) and machines
    (GET /api/machine/parts/{part}/likely-colors) from the cached BrickLink
    data it already has, over one labelable palette that replaces the three
    filters. The sorter asks Hive per piece (GET /api/pie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
2026-10-12 Color review tiles: two to a row on a phone, the share for sale under each
    Long names wrap to two lines instead of being cut, the predicted mark
    wraps too, and a tile's second line is its share of the part's pieces for
    sale (how near it is shows in the swatch), so nothing is cut at 390 wide.
    The chosen tile is its tint; the list keeps its check.
2026-10-12 hive: serve the labeling page and dashboard from worker-kept tables
    Every slow Hive page aggregated or sorted the whole fleet's history per
    request. Now:
    - Piece grid: a labeling_queue table (one narrow row per labelable piece)
    kept by a worker that evaluates what synced since its last pass and
    re-evaluates everything daily. list_pieces walks an index per sort segment
    and stops at the page size, with keyset cursor paging (next_cursor) in
    place of offset. Every sort still works. Replaces the piece_has_candidates
    materialized view and its 5-minute full refresh (left in the schema, unused,
    so a rollback still finds it).
    - Labelable counts: summed from per-machine counts the worker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
2026-10-12 hive: postgres sized for its box, a daily storage walk, API keys out of URLs
    - docker-compose.prod.yml: shared_buffers 1GB, work_mem 16MB, random_page_cost
    1.1, effective_io_concurrency 200, jit off. Releases never recreate postgres,
    so scripts/README.md gives the one manual step that applies them.
    - The object-store walk for the admin storage numbers runs daily instead of
    every three hours, pausing briefly every listing page so request threads
    keep the CPU.
    - Rebrickable requests send the key in an Authorization header, not the query
    string, so it never appears in an error message or a logged traceback.
    BrickLink price errors are redacted the same way.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
2026-10-12 hive: one shared pool for storage reads; skip grid segments a filter empties
    read_many used a thread pool per call, so concurrent piece opens each started
    up to 16 threads; they now share one pool of 16. With "has candidates" on, the
    priority sort no longer walks its no-candidate segments, which would read the
    whole queue index on the last page to find nothing.
2026-10-12 hive: one review queue for Piece samples and Channel samples; a machine filter that cannot leak
    The leak: with a machine chosen, the piece grid could show another machine's
    pieces. A "load more" (or a first page) still on its way for the previous
    filter was appended to the list after the filter changed, so the grid showed
    the old machine's pieces above the new one's, and the labeling pane stepped
    through them. The standalone piece page's next/previous ignored the filters
    altogether, and the Channel samples grid had the same late-answer race.
    Now both pages read one queue module:
    - services/review_queue.py: the filtered, sorted, keyset-paged queue for
    pieces and samples. The machine filte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
2026-10-12 hive: a sample filter is declared once
    SampleFilters is now the one model of the Channel samples filters: the list
    builds it from its query (sample_filters_query), the batch archive/delete
    bodies and the teacher job filter subclass it, and apply_sample_filters gives
    each field its meaning. Adding a filter is a field, its meaning, and its query
    parameter, all in services/sample_filters.py.
2026-10-12 hive: the swatch finder calls whether the colour palette is in view, and stores the call
    The finder copy now matches the research finder's latest: a swatch is one
    region of top face in one colour, a 150 network pixel floor, and the frame's
    call, the chain of neighbouring swatches that makes up the palette (at least
    4 in at least 4 colours), with the palette flags over those swatches only.
    Runs store palette_present and palette_swatches, swatches in_palette, behind
    a (model, call, sample) index; a backfill reads again runs made before the
    call. swatch_jobs.palette_filter is the where-clause for a samples filter on
    it. The sample page says whether the palette is in view and dashes the
    swatche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
2026-10-12 hive: filter samples by whether the colour palette is in view
    A palette field on SampleFilters (any, in view, not in view, not checked
    yet), so the samples list, the review queue, the batch archive and delete and
    teacher re-runs all honour it, and a "Color palette" group in the samples
    filters. The migration now follows 01ac20eed2e4.
2026-10-12 Hive: the color reference palette on Piece samples, and a compact labeling pane (#1011)
    * design system: color choice lists every color only when typed or asked for
    ColorChoice's list of every color was always open, a scroll of its own that
    caught the wheel. Now the search lists its matches only as they are typed
    (Enter picks the first) and "All colors" lists the palette on request, with no
    inner scroll. The likely colors' tiles are smaller, the chosen color is always
    in the grid, and `aside` puts what an app ranks them against beside them (Hive:
    the part's top colors sold on BrickLink). `fill` is gone. Copied unchanged into
    Hive and the sorter; docs, decisions, icons and the site's example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
2026-10-12 Hive: request timing by route, an admin Server page, cheaper machine uploads (#1008)
    * hive: time every request by route, in memory
    A pure ASGI middleware records each request against its route template:
    count, 5xx, slow, total and longest time, time in database queries, and a
    latency histogram, over the last hour in one-minute slots, so memory stays
    fixed however many requests arrive. Database time comes from SQLAlchemy's
    cursor events through a context variable the threadpool copies. A request
    over 2 s logs one line with its route, status, total and database time.
    * hive: register the request timing middleware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
2026-10-13 Hive: no request reads history: indexes per filter, bounded walks, worker-kept counts, and a plan test on a production-sized database (#1010)
    * hive: index teacher-checked samples newest first for the samples list's default view
    The list's default filter (a teacher pass validated the boxes) walked every
    sample backwards by upload time and read each row: with tens of thousands of
    newest samples not teacher-checked yet, a page ran into the 60 s statement
    timeout. A partial index on exactly that predicate makes it an index walk of
    the rows it returns (17 ms on a production-sized table).
    * hive: no request reads history: indexes per filt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
2026-10-13 Hive: a palette filter shows raw frames unless asked otherwise (#1014)
    * hive: a palette filter shows raw frames unless asked otherwise
    The classification camera's frames rarely have a teacher pass, so the
    samples list's teacher default hid nearly every frame the palette filter
    found. Under a palette filter an empty annotation filter now means all;
    the page shows which one is in effect.
    * hive: the samples list's defaults in one function, and its test on the rule
    ---------
2026-10-13 Hive: one thread at a time on the parts catalog's database (#1015)
    GET /api/profile-catalog/search-parts sometimes answered 500 with
    sqlite3.InterfaceError: bad parameter or other API misuse.
    ProfileCatalogService keeps one sqlite3 connection to parts.db
    (check_same_thread=False) for every request, and requests run on a thread
    pool. A connection may be handed to other threads but not used by two at
    once, and only some of the service's methods took its lock. search_parts, the
    status and admin reads, the sync-time check every request makes at most once a
    minute, the Rebrickable set cache, and the reload the web process runs on a
    thread of its own after a sync all used the connection without i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
2026-10-13 Sorter: a training run captures calibration frames as it goes (#1023)
    While a training run collects, the classification camera's frame (the one
    with the colour reference palette) is captured as each colour segment
    starts and at least every 30 s after, whether or not sample capture is on,
    so the run's labels can be calibrated to light that changes during it.
    The regular sample schedule keeps its own clock.
2026-10-13 Hive: agree with a colour model in bulk, and pieces that open at once (#1025)
    * Hive: agree with a colour model's answers in bulk
    With a colour model chosen on Piece samples, the cards it has answered can
    be picked (a box on each; shift-click picks a stretch; "Pick all shown"),
    and one request, POST /api/labeling/agree (up to 500 pieces), writes the
    user's own colour label for each picked piece as the colour the model gave
    it. Pieces the user may not see, the model has not answered, or whose answer
    is not a labelable colour are skipped. The picks clear and the cards show
    the new label.
    * Hive: opening a piece reads what was worked ou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
2026-10-13 Full-frame samples: at most one per camera every 2 minutes, and by default (#1026)
    Hive's default sample interval, which every machine follows, goes from 10 s
    to 2 minutes, and a stored or requested interval faster than that is raised
    to it. On the sorter the same 2 minutes is the default and the minimum: a
    saved setting faster than it is raised and stored, no camera gives two
    frames within it (training runs' calibration frames included), and the
    settings page offers nothing faster.
2026-10-14 Hive: set search, set inventories and kits from sets come from Rebrickable's CSV downloads (#1031)
    Rebrickable's API refuses requests from the server (403, Cloudflare error
    1006), so set search, a set's inventory and making a kit from a set all
    failed. Rebrickable publishes its sets, themes, inventories and inventory
    parts as daily CSV downloads, and those are enough for all three.
    - A new catalog sync, "sets", downloads themes, sets, inventories and
    inventory_parts and replaces four tables in parts.db with them (migration
    011), in one transaction on a connection of its own, streaming the rows
    through gzip so the 1.5 million inventory parts never sit in memory. It
    runs with the cata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
2026-10-14 Sorter: the hosted colour provider reads every frame of the C4 burst (#1035)
    It got the frames picked for recognising the part (often one, sometimes an
    empty frame) plus the upstream link views, which the colour models were not
    trained on. It now gets the burst's frames in order, at most the eight the
    endpoint takes, as Hive reads a stored piece's crops.
2026-10-14 Hive: judge a piece's colour from every crop the colour camera took (#1034)
    * Hive: a piece's colour is judged from every crop the colour camera took
    The colour guess and every colour model's answer read only the crops the
    machine used for part recognition, often a single frame and sometimes an
    empty one, which then decided the colour alone. They now read every C4 crop
    in burst order (at most 8). The kept colour guesses were made the old way and
    are dropped by a migration; the grid's warm jobs make them again.
    * Hive: the pixel colour guess names its colour without loading the catalog
    piece_warm makes a piece's guesses in the worker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
2026-10-14 docs(orange pi housing): build photos from BrickCycleAlice replace the renders they show (#1033)
    Approved in Discord by barthel, zed0.
2026-10-14 docs(bottom-layer): say the loose screw in the step 1 photo is a collar screw tightened in step 2
2026-10-14 docs(bottom-layer): the loose screw in step 1 is a collar screw tightened in step 2 (#1038)
    Approved in Discord by barthel, BrickCycleAlice.
2026-10-14 parts calculator: mark the colors that matter, free the lamp cover (#1041)
    The calculator listed every printed part with a color, and nothing set the
    ones that do a job apart from the ones that are only a default, so a lamp
    reflector printed in a bright color looked like a reasonable choice.
    - A fixed color now carries `why`, and the calculator shows a "Must be"
    badge with that reason on the parts list (both views) and the part page:
    the lamp inner reflector and its LED hooks (white, they reflect the light),
    and the stator, both rotors and the rotor cap (gray, the cameras look at
    them).
    - The lamp outer cover follows the C-channels color picker instead of a
    fixed ash gray. It does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
2026-10-14 docs(lab): add How the cameras are lit, on the lamp's reflector, strip, cover and light spread
2026-10-15 docs(lab/sorter): what is on record about the 8 inch bearing size (#1048)
    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
2026-10-15 docs(lab): why the chute is driven through an idler and a 120T gear (#1047)
    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
2026-10-15 docs(lab): give the reason for the hexagon frame (#1046)
    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
2026-10-15 docs(lab/power): say why the supply is the LRS-350-24 (#1045)
    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
2026-10-15 docs: why the servo signals come from a PCA9685 (#1044)
    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
2026-10-15 docs(lab): how the cameras are lit (cover, LED strips, light distribution) (#1043)
    Approved in Discord by barthel, ReveryX.
2026-10-15 Sorting profile: a part the profile does not list takes its base part's bin
    A printed, stickered or assembled part number (3010pb176R, 3464c02,
    122c01assy2) that the profile's map or program does not name now routes
    like its base part instead of falling to the default, so a piece that was
    classified lands in a bin. Variants never fill a kit.
2026-10-15 C4: a piece that comes back around is counted once and holds the machine
    A tire that does not fall off the exit rides on around the platter and is
    classified again in the drop zone, so one piece became two records. A piece
    classified as the same part and colour within 30 s of an eject is taken for
    the same one when it is a wheel or tire, or when that eject timed out without
    the piece being seen to fall: its record is marked dead so counts take it
    once, and a new piece_circling incident asks the operator to take it off.
2026-10-15 Hosted colour: one kept-open connection to the main hive, and slow calls logged
    Each colour prediction opened a new connection, so each paid a name lookup
    and a TLS handshake. A lookup is not covered by the request timeouts: on a
    machine where 4 in 10 system lookups stalled for the resolver's 5 s timeout,
    predictions reached the hive 10 to 16 s after the piece was seen and the
    piece fell back to Brickognize's colour, with nothing logged. One session
    keeps the connection open between pieces; a prediction slower than 3 s, or a
    failure, now logs how long it took.
2026-10-15 C4: push off a piece that was ejected but is still at the exit
    When a piece's track id blinked out at the exit for the 0.35 s that confirms
    an eject, the piece was committed as ejected while it still sat on the lip.
    Being the most forward piece it stayed the head, so nothing else was aimed or
    ejected until the stall watchdog swept the whole channel, classified pieces
    included, into the bucket 30 s later. While no other piece holds the chute
    (it is still aimed where this piece was going), the channel now turns 15 deg
    to push it off, up to three times; the watchdog stays the fallback.
2026-10-15 Sorter: capture issues are six icon switches on each piece, and the Pieces list shows 250 a page
    The compact review's "Report an issue" opened a menu of six switches: open it,
    click one, close it, for every piece. Now each issue is its own icon in the
    row: one click flags it and the icon turns to the warning tint, another
    takes the flag off, and a tooltip names it. The flag shows at once and is saved
    right away; flags clicked while a save is on its way go as the next answer, so
    clicking through several is several clicks.
    Lucide has no picture of a LEGO piece, so the six glyphs (not a LEGO piece,
    several pieces in frame, none, assembly, tangled, blurry) are drawn in the
    design system, like a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
2026-10-15 Sorter: a piece's page is one screen of what matters, with the debugging below
    The piece's page was five screens of panels: classification and record cards,
    pricing, the classification burst, other channels, a scratch reclassify panel
    and a lifecycle timeline, with the predictions in the middle of them. Now:
    - Back to the records is first, at the top left, then which piece it is.
    - The top card is what you came to see: every frame the camera took (small, the
    ones that produced the result tinted, each enlarged under the pointer and
    opening the full-size viewer when clicked), the part and what the machine
    decided about it (mold, color, category, bin, value, when), Brickognize's
    pictur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
2026-10-15 Sorter: search and filter the records list, and keep its pages still while the machine sorts
    GET /api/pieces takes q (a search: terms that must each match a part number
    from its start, a part or colour name, or a piece uuid from its start),
    sorting_run_id or lot_id (the operator's runs and lots; a lot is the runs that
    add to it), bin_x/bin_y/bin_z, reviewed, and the filters it had. The CSV export
    takes the same ones, so it is the list.
    A listing is cut at an anchor, the newest id when its first page is asked for.
    The answer names it (anchor), and sending it back with each later request keeps
    the pieces recorded meanwhile out: total is what the listing holds and newer is
    how many matching pi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
2026-10-15 Hosted colour: the burst's last frames, cut down to 256 px
    The colour provider got the burst's first eight frames at full size. With a
    longer burst those are the frames taken while the piece still slides in, and
    eight full-size crops made the upload most of a prediction's time over a
    slow uplink (3-6 s, Wi-Fi at 0.3-1.8 MB/s), while colorpred-v6 reads 64 x 64.
    It now gets the last eight frames, each at most 256 px on its long side.
2026-10-15 Sorter: search and filter the Pieces list, and open it from a run's piece count
    The Pieces tab has a search box (a part number, a part or colour name, or a piece
    id; it waits for a pause in typing) and filters for status, sorting run or lot,
    bin, a range of days, whether the piece is reviewed, and newest or oldest first.
    They are in the address, so Back and a link show the same list, and changing one
    replaces the history entry instead of adding a step. The list is cut at the newest
    piece when the search starts: pieces recorded meanwhile stay out of its pages and
    the page says how many came after, with a button that starts the search again.
    Export CSV exports the list as filtered, cut at the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
2026-10-15 Sorter: the Pieces filters sit two to a row on a phone
    The controls were one to a line at 390px wide, eight lines before the first piece.
    They now share a line in pairs, and keep their own widths from the sm breakpoint up.
2026-10-15 Sorter: crop each C2/C3 track's last sightings, C2 every 10 degrees, and log each C4 piece's track
    The picture right before a piece leaves a channel is the one that ties it to
    its arrival on the next, and the crop cadence skipped it. Frames the cadence
    skips are held per track and stored once the track is gone. C2 is cropped every
    10 degrees, up to 20 a pass (was 19.2 and 5). The control data log now records
    which C4 track each piece is (event c4_piece), so a classified piece can be
    found in the log with its earlier tracks.
2026-10-15 Hive: judge a piece's colour from its burst's last eight C4 crops (#1051)
    A C4 burst can now run past eight frames, and its first ones are taken while
    the piece still slides in. The sorter's own colour request already sends the
    last eight; Hive's guess and colour model runs now read the same ones. Bursts
    of eight or fewer are read whole, as before.
2026-10-15 C4: tie a track that takes over a piece to it in the control-data log
    When a new track id takes over a lost piece, the log now gets a c4_piece event
    for the new id, naming the id it replaced (took_over), so the piece can still
    be followed back to its earlier tracks.
2026-10-15 C4: a piece coming around from past the exit is no late double feed
    The late double feed rule also caught pieces that did not fall at the
    exit: they ride on past it, out of the camera's sight, and come back
    into the drop zone from behind while the next piece is staged. That
    sent the returning piece and the innocent staged piece to misc, about
    one cycle in eight. A late piece lands where the feeder drops pieces
    and only moves forward from there, so it is now counted only when first
    seen no further from the exit than where the staged piece landed (plus
    40 deg of landing scatter, and never beyond 280 deg).
2026-10-15 Tests: wait for the piece image store to write, not only to dequeue
    test_piece_image_separation read the table 0.1 s after the store's queue
    emptied, while the worker could still be making the tables and writing the
    file, so it failed now and then on a busy machine. The worker marks each item
    done and the test waits for that. The crop collector's test fakes the clock
    only for the collector, not for the time module other threads use.
2026-10-15 C4: after a resume, kept pieces can still claim new ids; no late feeds
    Seen on the first resume with kept pieces: a piece's tracker id changed
    during the stop, and the new id, older than the stray grace, went to
    misc as never photographed before the hand-over could claim it. On a
    resume, ids nobody photographed now get a fresh stray grace. A piece
    that landed while paused was taken for a late feed behind the piece
    staged on the first turn after the resume; a late arrival must now
    have appeared after the current turn began.
2026-10-15 Stores: a writer thread keeps the queue it started with
    The piece image, sample and channel crop stores each write from one thread
    that read the module's queue by name. Tests reload these modules, and every
    reload left the old thread running: once its wait ran out it took items from
    the new queue and wrote them after the test had moved on, so sync and sample
    tests failed now and then under load. A writer now keeps the queue it started
    with and stops when the module has a new one (nothing reloads them in
    production). The sync tests drain the image queue by hand on a queue of their
    own, and two waits on a write allow 15 s on a busy machine.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
2026-10-15 C4: two pieces landing touching are a double feed
    The camera merges boxes within 14 px into one, so one piece drawn as
    several counts once. That also fuses two pieces that land touching:
    they were tracked, photographed and sorted as one piece. In a replay of
    75 minutes (229 landings) four such pairs went to sorted bins.
    While the channel stands still, a frame with two boxes of a similar size
    within 25 deg of each other in the drop zone (tracked or not) makes
    every piece there a double feed, and so does a piece that lands within
    1 s after it (the fused box often gets its id a few frames later). A
    piece whose box grows to 1.6 times its settled size in two frames at
    rest had another land again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
2026-10-15 Feeder: a cap on pieces per channel; C4: a new run's first step re-arms
    C3 drops two pieces at once when it is packed: crowded pieces sit
    touching and the exit pushes both. It packs after a heavy pour floods
    C2 (one went from 5 pieces to 25 in a few seconds, C3 from 2 to 7, and
    double feeds ran at 46% for two minutes). ch3_max_pieces stops C2
    handing C3 a piece while C3 holds that many; ch2_max_pieces does the
    same for C1 into C2. Pieces the feeder knows are out of sight count.
    Both default to 0, no limit.
    C4: the first step after the flow is built now restarts the stall
    watchdog's clock, like a resume does. A home before the first resume
    read as a stall and swept the channel.
    Co-Authored-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
2026-10-16 Perception: C2/C3 keep detections up to 85% of the outline's length
    The oversize filter drops a box wider or taller than 60% of the channel
    outline's extent, to catch a hand, a shadow or the model taking the
    whole channel. C2 and C3 are framed so their outline fills the camera
    image, and a long piece lying along the channel spans more than that:
    one about 445 px tall in a 720 px image was dropped, and the feeder
    never saw it. The feeder channels now allow 85%
    (SORTER_FEEDER_MAX_BBOX_MASK_DIM_FRACTION); the classification channel
    keeps 60%, and the area limit is unchanged.
2026-10-16 C4: eject the head alone while the feeder's gate stays shut
    A stage that stops short of the exit can leave a piece straddling the
    drop zone's edge: its centre outside, its box inside. The drop zone
    then reads occupied, so the feeder's gate never opens and no next piece
    comes, while the head waited for the gate to be open 12 s before going
    out alone. Nothing moved until the stall watchdog swept the channel 30 s
    later. The 12 s now also count from when the channel stopped while the
    gate stays shut.
2026-10-16 docs: top interface step 10, show where the cable mount bracket goes (#1057)
    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
2026-10-16 Orange Pi 5 Pro, Max and Ultra housing: catalog and docs (#1058)
    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
2026-10-17 catalog: build plates for the chute core and the two funnels (#1062)
    Approved in Discord by zed0, ReveryX.
2026-10-17 docs(lab): casters screwed straight into the extrusion (Tested variants) (#1063)
    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
2026-10-17 docs(chute): swap the layer connectors in the renders so the round cutout faces the front (#1064)
    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
2026-10-17 catalog: ext-bracket-bottom-vertical STL exported in print orientation
2026-10-17 docs(lab): bin retainers with one joint screw and a hook (Tested variants) (#1070)
    Approved in Discord by Soran82, ReveryX.
2026-10-17 docs(hex-frame): even passes in step 8, and say the bracket holes are a fallback (#1074)
    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
2026-10-17 Supplier list for cut-to-length 2020 extrusion on the framing page (#1069)
    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
2026-10-17 catalog: re-export the Frame crossbeam flat on the bed (#1066)
    Approved in Discord by Jayesh-Herndon, ReveryX.
2026-10-17 hive: fleet:detail, the operator's view of every machine (#1076)
    A new service-to-service tier, GET /api/public/fleet/detail under its own
    scope. It is the identified roster with what running the fleet takes added
    to each row: the last status report (software, OS, hardware, temperature,
    disk, uptime, online), the hardware report's platform, cameras and boards,
    the sorting profile and whether it runs the version it was given, when each
    kind of upload last arrived, lifetime sample and session counts, and the
    last 30 days. Status reports from sorters that name no machine here are
    served under a pseudonym as unlinked_sorters.
    Every field is projected by name: no IP, no network_info, no camera U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
2026-10-17 catalog: External bracket - side STL in print orientation (#1065)
    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
2026-10-17 catalog(frame-90deg-bracket): print orientation, corner down with no supports (#1067)
    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
2026-10-17 parts-calculator: name a cutting service for Germany on the Laser cut page (#1075)
    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
2026-10-18 Keep hardware settings the same across restarts: one declaration each
    Settings a person changes for the stepper drivers, the chute and the layer
    servos are now declared once, in software/sorter/backend/hardware_settings/:
    the machine.toml table and key each is saved under, its range and default,
    and how it reaches the hardware. Start-up (irl/config.py) and every route
    that changes one read, save and apply it through those modules, replacing
    the per-route helpers and the name tables that had drifted apart.
    What this fixes:
    - The chute's operating speed was saved but never set on the stepper: after
    a start the chute ran at the start-up limit (3000 µsteps/s) or whatever a
    jog left behind.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
2026-10-18 docs: say when the stepper_driver settings reach the driver
2026-10-18 docs: explain the double brackets on [[servo.channels]]
2026-10-18 channel pages: the zones beside the camera, found, adjusted, locked
    The channel settings page was one 4,200-line file: the camera chooser, the
    picture, detection and LED panels, and a canvas zone editor for three kinds of
    zone (arcs, a four-corner shape and free polygons) plus foreign zones. Its
    handles were pinned inside the picture, so dragging one whose edge ran off
    the frame made the zone jump.
    Now the page is ChannelSection, with the camera chooser in its own component.
    The zones are drawn over the picture as SVG in the picture's own pixels, so
    nothing is pinned and shapes run off the edges freely. Beside the picture the
    Zones panel has a row for the ring, the drop zone, the precise sl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
2026-10-18 zones: pair each landing with the piece that left last before it
    A channel's camera can lose sight of part of its ring, so pieces' tracks also
    end there, a moment before another piece falls off the exit. The learner
    matched each ended track with the first landing after it, so a track that
    went out of sight could take the next channel's landing. Now each landing is
    matched with the most recent track to end before it, once any track that
    ended just before it is known to be gone.
2026-10-18 design system: a setting's explanation can sit behind an info icon
    A page of a dozen settings with a sentence of help under each is as tall as
    three screens. SettingRow takes `info`: a small info icon button right after
    the name, named "About <name>", whose Tooltip shows the text on hover and on
    keyboard focus (a click focuses it, for a touch screen). The row stays one
    line.
    This is an exception to "help is always visible, never in a tooltip", for dense
    lists only. It holds what a setting is for; a warning or a cost stays under
    the setting as `help`. The rule's words change in overlays, components, type
    and decisions, the Forms page shows it working, and the Sorter UI takes the
    two changed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
2026-10-18 settings: one Data page for what a sorter shares, captures and keeps
    Sample capture, the per-Hive "Uploads" dialog and the storage section were
    three places that all said what leaves the machine. Settings > Data now has
    them in one compact page, each setting's explanation behind an info icon:
    - Shared with Hive: a row per stream (machine telemetry, piece records, piece
    pictures, camera frames, channel crops, feeder logs, network addresses),
    "Always" for what cannot be turned off and a switch for the rest. A select
    chooses every Hive or one Hive; a Hive's own values say so and go back to
    what every Hive gets, and a reset puts every value back to its default. A
    notice asks for the a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
2026-10-18 setup: a step that says what this sorter shares, before Hive
    A new step, "What this sorter shares", comes right before Hive:
    - Always: piece photos go to Brickognize, and an hourly status report goes to
    basically, with what each carries.
    - With a Hive connected: a row per stream, each with an info icon, machine
    telemetry marked "Always" and the rest on by default with a switch, and a line
    on why pictures and piece records matter.
    - A link to the full list of what leaves the machine, and "Agree and continue",
    which records the agreement with the switches as they are.
    The step is its own component with all its words in one place, so it can be
    reused where a Hive is connected from Set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
2026-10-18 hive settings: connecting a Hive shows what the sorter shares first
    Pairing, adding a token and registering (legacy) each ask for the agreement
    before they open, when the person has not given it: the same notice as the
    setup step appears under the buttons, with a Cancel, and "Agree and continue"
    records the agreement and opens the flow that was chosen. A sorter that is
    already connected to a Hive but has not agreed shows a quiet notice with a
    "Review and agree" button, since nothing is sent until then.
2026-10-18 settings: training runs move under Data, and the nav is one Data item
    Training runs are the third thing Data holds, so /settings/training-data
    becomes /settings/data/training and a run's page /settings/data/training/<id>.
    The dashboard's links follow, and the old addresses (and /settings/sample-capture
    before it) redirect, since people have them bookmarked.
    The side nav's two Data pages become one item, "Data", with "Uploads" and
    "Training runs" listed under it the way the chute lists its own pages, and the
    item sits beside Hive.
2026-10-18 hive: keep sorters' telemetry records (specs, stepper load, camera readings, stalls)
    A sorter now sends how it is set up and how it runs as small telemetry
    records: snapshots of its specs, hour-long windows of stepper load and camera
    readings while sorting, and stall events. POST /api/machine/sync/telemetry
    upserts them into machine_telemetry by (machine, local_id) with the usual
    watermark (data type telemetry); a bad record is skipped. The newest
    machine_specs snapshot in a batch also becomes the machine's hardware summary
    and history, as specs on a heartbeat did.
    Nothing reads them in the UI yet; agent-docs/telemetry.md describes the kinds,
    their size and how to query them.
    Co-Authored-B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
2026-10-18 uploads: name what the tooltip's number counts, and say the budget once
    An hour's tooltip now says what its first number is ("12.4 MB uploaded",
    "31 waiting"). The four tiles lose the budget's numbers, which were cut off in a
    narrow tile; one sentence under them gives the limit and what "not uploaded"
    means.
2026-10-19 fleet telemetry: leave a driver that stops answering alone for five minutes
2026-10-19 zones: Find puts the exit at the wall's opening, picked by where pieces fell
    Find kept a machine's exit where it was drawn, only measuring it again from
    the new center, so an exit drawn in the wrong place stayed wrong. It now
    looks for the opening in the wall. Where the wall stands, the rotor's edge
    is a dark line with light on both sides, the disc and the wall's top; where
    the wall is open the outside is open too, and the line is no valley. The
    opening is a run of the rim 15 to 100 degrees wide where the valley falls
    under 0.4 of the wall's, starting at the wall and ending at the wall or
    where the rim leaves the picture. It is looked for at the camera's own size,
    on the median of up to 16 p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
2026-10-19 feeder: a landing on C3 is a new piece just after C2 dropped one
    The room C2 leaves on C3 is measured from where pieces land: the front of
    each new piece first seen in C3's landing zone. A tracker switch also gives
    a piece already on C3 a new id, anywhere in the zone, and the most forward of
    those set the front: on one machine 155 degrees before the exit where pieces
    land at 190-210, so C2 waited for far more room than meant (19% of the time
    it had a piece ready). A new piece now counts as a landing only within 2.5 s
    of C2's gate seeing a piece fall, and the front is the most forward quarter
    of the landings rather than the tenth, so one stray cannot set it.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
2026-10-19 stallguard: the chute tunes its own threshold and speed floor
    StallGuard's threshold and speed floor were typed in once and left, but what
    a motor's load reads depends on its speed, current, microstepping and
    chopper mode, and drifts as it wears. A speed changed without retuning could
    leave the floor above the cruise, so StallGuard never looked, and a stale
    threshold could stop catching a stall.
    stallguard_tuner.py now keeps both for the chute while it runs:
    - The speed floor is 1.25 times the TSTEP of the operating speed, so the
    driver judges the cruise and the top of each ramp at any speed.
    - While the chute moves at its operating speed, the tuner reads TSTEP and
    SG_RESULT every 50 m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
2026-10-19 stallguard tab: the guided steps say they are optional while it tunes itself
2026-10-19 zones: look for the end face within 8 degrees of the opening's end
    Where the camera sees a wall's end face at an angle, the face is dark where
    the rim's line would be, so the valley reads the opening a few degrees wider
    than it is (4.5 degrees on one feeder channel), past the 4 degree search.
2026-10-19 zones: each end of the exit is the sharpest edge on its side of the opening
    The opening read at the rim can run far past an end face: on one machine to
    where the rim leaves the picture, 10.7 degrees past it, because the dark
    face reads as opening. Each end is now the sharpest radial line between the
    opening's middle and 8 degrees past the valley's end, counting each angle
    over the radii the picture shows there, so the search reaches the edge of
    the frame.
    The edge tests now measure around a locked ring at the true center (a found
    center a pixel off turns the edges by 0.2 degrees), and draw their wedges
    anti-aliased to a sixteenth of a pixel.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
2026-10-19 zones: each end of the exit is the outermost sharp line on its side
    Through the opening the next channel shows, with sharp lines of its own; on
    one machine, after homing, a part of the classification channel seen
    through C3's opening was sharper than C3's own end face, and the sharpest
    line on that side put the exit's start 17 degrees inside the opening. The
    end faces bound everything seen through the opening, so each end is now the
    sharp line furthest from the opening's middle.
    A line must also stand three times above the usual change on each side of
    it within 2 degrees, so the shading across an end face seen at an angle,
    which changes as much over degrees, is no line.
    Tests: a bright bar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
2026-10-20 docs(sorter): Bins and profiles page
    How bins get their categories, saving a profile's bin layout and getting it
    back after a profile switch, what a newer version of the same profile does
    to the bins, what happens when a bin hits its limit, and Empty vs Reset.
2026-10-20 docs(sorter): bins and profiles, rewritten for the reader at the machine
    Short plain sentences and numbered steps; the top banner now also says
    SorterOS changes quickly, so a button's name or place may have moved.
2026-10-20 docs(sorter): bins and profiles, homing the chute during long runs
    It never re-homes by itself; a stall stops the machine with Chute needs
    homing; home by hand with the machine paused.
2026-10-20 catalog: re-export the Top interface chute mount plate-down
2026-10-20 parts-calculator: restamp four versions whose commits no clone can reach
    cable-cage v1, superstructure v1, bottom-interface v1 and layer v2 were stamped
    with pre-squash branch heads (47a5e5a5, 36826f49, 1ce549ec) that are on no
    branch, so version-snapshots.mjs exits 1 and the Pages build fails with no
    compile error. Point them at the squash commits on main: 6bcb3c0e (#589),
    de693213 (#545) and dc1f661e (#544).
2026-10-20 stallguard: automatic tuning is off until it is turned on
    The chute's automatic StallGuard tuning (#1126) was on by default for a
    chute with no saved StallGuard settings. It is now off for every motor until
    it is turned on with the switch on the chute's StallGuard tab, and Hive's
    copy of the defaults says the same. A machine that turned it on keeps it.
2026-10-20 chute: check its position against the home switch every so many pieces
2026-10-21 parts-calculator: show the Supports badge in every view of a part
    The badge only rendered on By assembly part rows. Add a shared SupportBadge
    and use it in By unique part, the assembly detail modal, the assembly page
    and the part viewer.
2026-10-21 parts-calculator: rename the Supports badge to Support needed
    Asked for by ReveryX, with barthel and zed0 agreeing. The printing page
    names the badge, so it changes with it.
2026-10-21 catalog: take the support flag off the Camera lamp ring
    Reverts a1e80451c. Two builders printed the ring fine without supports and
    nobody in the logs reports needing them, so the Support needed badge and the
    36 g estimate overstate it. Back to 14.68 g and 3107 s.
2026-10-21 docs: add the push-button power manager concept to Design and research
    Concept proposal by Soran82 (Jan-Henning Grell): switch a Mean Well HRPG-150-24
    through its remote-control input with a button, a clean Orange Pi shutdown
    handshake and an optional shutdown after sorting. The PDF is hosted on the
    asset service and linked from the page.
2026-10-22 catalog(hsi-m4): US source is CNC Kitchen's US store, amazon.com dropped the M4x8.1
    amazon.com no longer lists the M4x8.1 variant on ruthex's listing, so
    B07YSV66Y5 landed on the 1/4"-20x6.4 inserts instead. The US row now points
    at CNC Kitchen's M4 x 8.1 (50 pieces, $11.50), shipped from the US.
2026-10-22 docs(sorter): commissioning fixes for getting in, the wizard, updates and shutdown
    From BrickCycleAlice's first build: http not https, the real route back
    to the setup wizard, update the software before the wizard, which version
    you are on, a real finished-result screenshot, and the Powering down
    screen that never says it has finished.
2026-10-22 docs(sorter): first-setup is builder-verified, drop the AI-draft warning
    BrickCycleAlice commissioned a machine through the wizard and approved the
    page in the PR thread. The AI-draft half of the banner is out, the
    SorterOS changes quickly notice stays, last_verified is stamped and she is
    in contributors.
2026-10-22 docs(sorter): first-setup opens the wizard where you start it, not in Open the UI
    The UI shows the wizard on first open, but it is the third thing you do,
    after updating and picking the machine setup. Open the UI now says to leave
    it and go to Settings; how to open it, and its step 1 screenshot, move to a
    new Open the setup wizard section in place of How the wizard works.
    Requested by BrickCycleAlice in the PR thread.
2026-10-22 docs(sorter): first-setup says the standard build, drops the removed Machine setup picker
    SorterOS has had one machine setup since 2026-09-28 (4631f2ece, "remove
    obsolete machine setup controls"; stable v0.3.0 onwards). The page still
    told the reader to pick one of three in Settings, General, and steps 4, 5
    and 7 still described the carousel. Before you start now states the build
    is the standard V2 from the parts calculator and that there is nothing to
    choose; the Machine setup section and its screenshot are gone; steps 4, 5
    and 7 match stable v0.4.4 (C-Channel 1 to 4 and the Chute, a chute-only
    endstop step, three cameras, current button labels).
    Requested by BrickCycleAlice in the PR threa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
2026-10-22 docs(sorter): commissioning batch 2, cameras
    Focus steps say whether you are at the machine or in the UI, lamp on
    before focusing, BrickCycleAlice's photo of the chart on the rotor and her
    focused live view as the finished result. First setup step 7: lens cap
    off, a different piece on C2 and C3 to tell the cameras apart, a slow
    mode list sends you to troubleshooting, zoom out for the sliders. New
    troubleshooting entry for a camera stuck on small modes or 5 fps.
2026-10-22 docs(camera-calibration): crop the modified C2/C3 camera mounts out of the rotor photo, name C4 in both captions
2026-10-22 docs(camera-calibration): drop the classification chamber tray from step 1, point finer tuning at the Picture settings
2026-10-22 docs(troubleshooting): a camera lamp stays dark
    Empty Output list, picking the output, polarity, measuring across the
    lamp at 0% and 100%, then the barrel pair and the crimps.
2026-10-22 docs(first-setup): placeholder for the finished-result dashboard, the screenshot's C2/C3 views came from modified camera mounts
2026-10-22 docs(sorter): commissioning batch 3, chute and flaps
    Chute calibration: the changes-quickly notice, the current routes and
    button names, which way the chute should home and how to flip it, and
    calibrate on the first section after home with the bin count of that one
    section. First setup step 5 says which way is right; step 6 is the flap
    panel on the standard board, with BrickCycleAlice's torch and clicking
    tips and the Advanced switch for the Channel box.
2026-10-22 docs(first-setup): step 3, the standard build has one device, the servos run from the control board
2026-10-22 docs(sorter): flap servo care, restart after a layer change, endstop and flap troubleshooting
    First setup step 6: never turn a flap by hand, the first arrow press after
    power-on sends an uncalibrated flap to 0 deg (firmware starts every servo at
    0 and enabling outputs that pulse), and a layer added or re-binned needs a
    backend restart, not a re-home (the running layout is built once at process
    start). Troubleshooting: chute endstop always or never triggered, and a flap
    that cannot reach open or closed or a servo that spins freely.
2026-10-22 docs(chute-calibration): describe the chute as the turning stack, not an arm
2026-10-22 docs(chute-calibration): Mira pass, direction check in step 1, shorter opening
    Step 1 now says which way the chute should turn and how to reverse it, and
    that homing backs off to about the first bin (chute.py _backoffToFirstBin).
    Opening cut to one paragraph and a checklist; the active-numbers screenshot,
    the stale step 1 screenshot (0.0 deg, Triggered) and the homing-controls
    screenshot are gone. Jog buttons named as the UI labels them (+2, -0.25).
    Lists switched to bulleted-list HTML so they render with markers.
2026-10-22 docs(chute-calibration): diagram of the first section for steps 2 and 3, and the 3D page for testing later
2026-10-22 docs(chute-calibration): diagram of what a section is, both layer sizes
2026-10-22 docs(chute-calibration): front view of a section, from where the builder stands
2026-10-22 docs(sorter): the home switch is on the far side, above the PSU
    At home the chute points at the section left of the control board, and the
    hammer on its back presses the switch. Both diagrams had put the switch where
    the chute points. Redrawn, and the first section named by that landmark.
2026-10-22 docs(troubleshooting): re-couple a flap at 0 deg with it open, not 90
    Each start swings every flap to 0 deg on the way to opening it (#1158), so a
    flap coupled at 90 mid-swing would be driven into the wall at every start.
    Matches the coupling procedure in #1159.
2026-10-22 docs(chute-calibration): the route to Chute aiming opens step 1
2026-10-22 docs(chute-calibration): steps 1 to 5 are on the Chute aiming tab
2026-10-22 docs(chute-calibration): a third-size layer is a limit of the page, not a build rule
    The Bins in this section control offers 3 to 6 (chute-aiming/+page.svelte);
    the derive endpoint itself accepts 2 (chute.py, k >= 2). Say so, and say a
    machine with only half-size layers cannot calibrate here yet.
2026-10-22 docs(chute-calibration): step 2 screenshot without 'a section you can see in full'
    The calibration has to use the first section, so that part of the old UI hint
    is cut from the screenshot; 'pick any layer' and the jog pad stay.
2026-10-22 docs: control board tester page that drives steppers, servos and inputs over Web Serial
2026-10-28 firmware: STEPPER SET_DIAG_PIN, a host-set GPIO for a channel's DIAG wire
    A board whose DIAG lines are jumper wires (the basically v1-1 convention)
    can now have a channel's DIAG moved to another free GPIO at runtime, like
    current and microsteps, instead of rebuilding with a new hwcfg. Every board
    boots, and INIT resets, to its own STEPPER_DIAG_PINS, so nothing changes
    until a host sends the command. A pin the board already uses (step, dir,
    enable, UART, I2C, inputs, outputs) is refused; -1 means no DIAG. Stall
    detection is left off across the change. Observability reports the pins in
    use.
2026-10-28 parts-calculator: name expresszuschnitt as a second German cutting service on the Laser cut page
2026-10-28 parts-calculator: hand-cut guides show mm and inches together, drop the unit toggle
2026-10-30 docs: Pico page: lamp/fan ports and spare second switch input (#1213)
    Approved in Discord by barthel, JensR80 (ReveryX).
2026-11-01 catalog: Support needed badge on both bearing holders (#1221)
    Approved in Discord by JensR80 (ReveryX), DodgyBob.
2026-11-02 catalog(pulley-20t-8mm): add Amazon DE as an EU source (#1222)
    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
2026-11-03 parts(stator): print with the top rim on the bed (#1224)
    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
2026-11-03 docs(sorter): what the cameras see and what is cropped, crops sent to Brickognize (#1223)
    Approved in Discord by barthel.
2026-11-05 catalog: interface rib print note (#1228)
    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
2026-11-08 docs: chute calibration, restart if every test aim is off by a constant (#1231)
    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
2026-11-10 hive: turn sorter uploads away with a 429 while the web process is overloaded (#1236)
    When the box stalls, sorters' file uploads pile up in the web process until
    it passes its memory ceiling and is killed. While too many uploads or
    requests are in flight, or the container's memory is near its limit, the
    upload routes now answer 429 with Retry-After before parsing anything; the
    sorter keeps the data and backs off. Each episode is logged, shown on the
    Server API and sent as an operator alert when one is configured. The backend
    and worker logs are capped.
2026-11-14 framing: add Profilium (Australia) to Where to get it cut (#1243)
    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
